EVA-3D/eva-main/readme.md

# EVA

EVA is a carriage platform for MGN rail based printers.

To learn more about EVA [go to the documentation](https://main.eva-3d.page/).

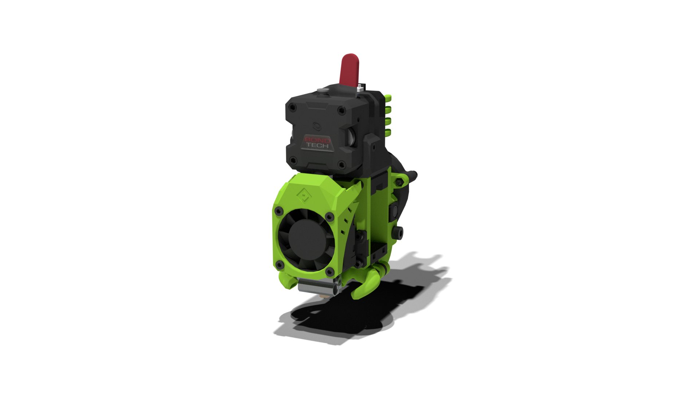
[picture p1: docs/assets/EVA.png]
