EVA-3D/eva-main/docs/ecosystem.md

---
hide:
  - navigation
---

# Ecosystem

There are many projects that came from the same family as EVA. Check them out for the full experience :)

## V-Core 3

A CoreXY 3D printer design from Rat Rig, where I am one of the main developers. Fully compatible with EVA.

{{ button("V-Core 3 page", "https://v-core.ratrig.com/", open_in_new_tab=True) }}

## V-Minion

A cantilevered, cartesian style printer with 180^3^ print volume, I'm on the development team of that one as well. Fully compatible with EVA.

{{ button("V-Minion page", "https://v-minion.ratrig.com/", open_in_new_tab=True) }}

## RatOS

A Klipper-based "firmware bundle" created and maintained by Mikkel Schmidt. 

RatOS allows you to quickly install the firmware for your printer, without the need to learn the very technical details of Klipper.
This bundle contains presets not only for the printers listed above (and more) but also for the specific EVA variants. This is also where you can find different wiring diagrams.

{{ button("RatOS page", "https://os.ratrig.com/", open_in_new_tab=True) }}
