EVA-3D/eva-main/include/heat_insert/probes/bl_touch_volcano.md

---
title: BL-touch Volcano
eva:
  category: probes
  component: bl_touch_volcano
  mounting: heat_insert
  name: heat_insert.probes.bl_touch_volcano
title: BL-touch Volcano

---

{% extends 'component.md' %}
