EVA-3D/eva-main/include/hex_nuts/probes/bl_touch_volcano.md

---
title: BL-touch Volcano
eva:
  category: probes
  component: bl_touch_volcano
  mounting: hex_nuts
  name: hex_nuts.probes.bl_touch_volcano
title: BL-touch Volcano

---

{% extends 'component.md' %}
