EVA-3D/eva-main/include/heat_insert/bottoms/default.md

---
title: Default
eva:
  category: bottoms
  component: default
  mounting: heat_insert
  name: heat_insert.bottoms.default
title: Default

---

{% extends 'component.md' %}
