EVA-3D/eva-main/include/heat_insert/bottoms/tri_horn.md

---
title: Tri Horn
eva:
  category: bottoms
  component: tri_horn
  mounting: heat_insert
  name: heat_insert.bottoms.tri_horn
title: Tri Horn

---

{% extends 'component.md' %}
