EVA-3D/eva-main/include/heat_insert/bottoms/volcano.md

---
title: Volcano
eva:
  category: bottoms
  component: volcano
  mounting: heat_insert
  name: heat_insert.bottoms.volcano
title: Volcano

---

{% extends 'component.md' %}
