EVA-3D/eva-main/include/heat_insert/hotend/revo_voron.md

---
title: REVO Voron
eva:
  category: hotend
  component: revo_voron
  mounting: heat_insert
  name: heat_insert.hotend.revo_voron
title: REVO Voron

---

{% extends 'component.md' %}
