EVA-3D/eva-main/include/heat_insert/shrouds/chonkier.md

---
title: Chonkier
eva:
  category: shrouds
  component: chonkier
  mounting: heat_insert
  name: heat_insert.shrouds.chonkier
title: Chonkier

---

{% extends 'component.md' %}
