EVA-3D/eva-main/include/heat_insert/shrouds/chonky.md

---
title: Chonky
eva:
  category: shrouds
  component: chonky
  mounting: heat_insert
  name: heat_insert.shrouds.chonky
title: Chonky

---

{% extends 'component.md' %}
