EVA-3D/eva-main/include/heat_insert/shrouds/small.md

---
title: Small
eva:
  category: shrouds
  component: small
  mounting: heat_insert
  name: heat_insert.shrouds.small
title: Small

---

{% extends 'component.md' %}
