EVA-3D/eva-main/include/heat_insert/shrouds/tank.md

---
title: Tank
eva:
  category: shrouds
  component: tank
  mounting: heat_insert
  name: heat_insert.shrouds.tank
title: Tank

---

{% extends 'component.md' %}
