EVA-3D/eva-main/include/hex_nuts/bottoms/default.md

---
title: Default
eva:
  category: bottoms
  component: default
  mounting: hex_nuts
  name: hex_nuts.bottoms.default
title: Default

---

{% extends 'component.md' %}
