EVA-3D/eva-main/include/hex_nuts/bottoms/tri_horn.md

---
title: Tri Horn
eva:
  category: bottoms
  component: tri_horn
  mounting: hex_nuts
  name: hex_nuts.bottoms.tri_horn
title: Tri Horn

---

{% extends 'component.md' %}
