EVA-3D/eva-main/include/hex_nuts/bottoms/volcano.md

---
title: Volcano
eva:
  category: bottoms
  component: volcano
  mounting: hex_nuts
  name: hex_nuts.bottoms.volcano
title: Volcano

---

{% extends 'component.md' %}
