EVA-3D/eva-main/include/hex_nuts/hotend/revo_voron.md

---
title: REVO Voron
eva:
  category: hotend
  component: revo_voron
  mounting: hex_nuts
  name: hex_nuts.hotend.revo_voron
title: REVO Voron

---

{% extends 'component.md' %}
