EVA-3D/eva-main/include/hex_nuts/shrouds/chonkier.md

---
title: Chonkier
eva:
  category: shrouds
  component: chonkier
  mounting: hex_nuts
  name: hex_nuts.shrouds.chonkier
title: Chonkier

---

{% extends 'component.md' %}
