EVA-3D/eva-main/include/hex_nuts/shrouds/chonky.md

---
title: Chonky
eva:
  category: shrouds
  component: chonky
  mounting: hex_nuts
  name: hex_nuts.shrouds.chonky
title: Chonky

---

{% extends 'component.md' %}
