EVA-3D/eva-main/include/hex_nuts/shrouds/small.md

---
title: Small
eva:
  category: shrouds
  component: small
  mounting: hex_nuts
  name: hex_nuts.shrouds.small
title: Small

---

{% extends 'component.md' %}
