EVA-3D/eva-main/include/hex_nuts/shrouds/tank.md

---
title: Tank
eva:
  category: shrouds
  component: tank
  mounting: hex_nuts
  name: hex_nuts.shrouds.tank
title: Tank

---

{% extends 'component.md' %}
