EVA-3D/eva-main/include/heat_insert/cooling_inlet/40mm.md

---
title: 40mm based fan
eva:
  category: cooling_inlet
  component: 40mm
  mounting: heat_insert
  name: heat_insert.cooling_inlet.40mm
title: 40mm based fan

---

{% extends 'component.md' %}
