EVA-3D/eva-main/include/heat_insert/cooling_inlet/dual_5015.md

---
title: Dual 5015
eva:
  category: cooling_inlet
  component: dual_5015
  mounting: heat_insert
  name: heat_insert.cooling_inlet.dual_5015
title: Dual 5015

---

{% extends 'component.md' %}
