EVA-3D/eva-main/include/heat_insert/core/cartesian.md

---
title: Cartesian
eva:
  category: core
  component: cartesian
  mounting: heat_insert
  name: heat_insert.core.cartesian
title: Cartesian

---

{% extends 'component.md' %}
