EVA-3D/eva-main/include/heat_insert/core/corexy.md

---
title: CoreXY
eva:
  category: core
  component: corexy
  mounting: heat_insert
  name: heat_insert.core.corexy
title: CoreXY

---

{% extends 'component.md' %}
