EVA-3D/eva-main/include/heat_insert/drive/bmg.md

---
title: BMG
eva:
  category: drive
  component: bmg
  mounting: heat_insert
  name: heat_insert.drive.bmg
title: BMG

---

{% extends 'component.md' %}
