EVA-3D/eva-main/include/heat_insert/drive/lgx.md

---
title: LGX
eva:
  category: drive
  component: lgx
  mounting: heat_insert
  name: heat_insert.drive.lgx
title: LGX

---

{% extends 'component.md' %}
