EVA-3D/eva-main/include/heat_insert/drive/lgx_lite.md

---
title: LGX Lite
eva:
  category: drive
  component: lgx_lite
  mounting: heat_insert
  name: heat_insert.drive.lgx_lite
title: LGX Lite

---

{% extends 'component.md' %}
