EVA-3D/eva-main/include/heat_insert/drive/orbiter_1_5.md

---
title: Orbiter 1.5
eva:
  category: drive
  component: orbiter_1_5
  mounting: heat_insert
  name: heat_insert.drive.orbiter_1_5
title: Orbiter 1.5

---

{% extends 'component.md' %}
