EVA-3D/eva-main/include/heat_insert/drive/orbiter_2_0.md

---
title: Orbiter 2.0
eva:
  category: drive
  component: orbiter_2_0
  mounting: heat_insert
  name: heat_insert.drive.orbiter_2_0
title: Orbiter 2.0

---

{% extends 'component.md' %}
