EVA-3D/eva-main/include/heat_insert/hotend/bmo.md

---
title: BMO
eva:
  category: hotend
  component: bmo
  mounting: heat_insert
  name: heat_insert.hotend.bmo
title: BMO

---

{% extends 'component.md' %}
