EVA-3D/eva-main/include/heat_insert/hotend/mosquito.md

---
title: Mosquito
eva:
  category: hotend
  component: mosquito
  mounting: heat_insert
  name: heat_insert.hotend.mosquito
title: Mosquito

---

{% extends 'component.md' %}
