EVA-3D/eva-main/include/heat_insert/hotend/nova.md

---
title: Nova
eva:
  category: hotend
  component: nova
  mounting: heat_insert
  name: heat_insert.hotend.nova
title: Nova

---

{% extends 'component.md' %}
