EVA-3D/eva-main/include/heat_insert/hotend/rapido.md

---
title: Rapido
eva:
  category: hotend
  component: rapido
  mounting: heat_insert
  name: heat_insert.hotend.rapido
title: Rapido

---

{% extends 'component.md' %}
