EVA-3D/eva-main/include/heat_insert/probes/8mm_probe.md

---
title: 8mm Probes
eva:
  category: probes
  component: 8mm_probe
  mounting: heat_insert
  name: heat_insert.probes.8mm_probe
title: 8mm Probes

---

{% extends 'component.md' %}
