EVA-3D/eva-main/include/heat_insert/probes/bl_touch.md

---
title: BL-touch
eva:
  category: probes
  component: bl_touch
  mounting: heat_insert
  name: heat_insert.probes.bl_touch
title: BL-touch

---

{% extends 'component.md' %}
