EVA-3D/eva-main/include/hex_nuts/cooling_inlet/40mm.md

---
title: 40mm based fan
eva:
  category: cooling_inlet
  component: 40mm
  mounting: hex_nuts
  name: hex_nuts.cooling_inlet.40mm
title: 40mm based fan

---

{% extends 'component.md' %}
