EVA-3D/eva-main/include/hex_nuts/cooling_inlet/dual_5015.md

---
title: Dual 5015
eva:
  category: cooling_inlet
  component: dual_5015
  mounting: hex_nuts
  name: hex_nuts.cooling_inlet.dual_5015
title: Dual 5015

---

{% extends 'component.md' %}
