EVA-3D/eva-main/include/hex_nuts/cooling_inlet/single_5015.md

---
title: Single 5015
eva:
  category: cooling_inlet
  component: single_5015
  mounting: hex_nuts
  name: hex_nuts.cooling_inlet.single_5015
title: Single 5015

---

{% extends 'component.md' %}
