EVA-3D/eva-main/include/hex_nuts/core/cartesian.md

---
title: Cartesian
eva:
  category: core
  component: cartesian
  mounting: hex_nuts
  name: hex_nuts.core.cartesian
title: Cartesian

---

{% extends 'component.md' %}
