EVA-3D/eva-main/include/hex_nuts/core/corexy.md

---
title: CoreXY
eva:
  category: core
  component: corexy
  mounting: hex_nuts
  name: hex_nuts.core.corexy
title: CoreXY

---

{% extends 'component.md' %}
