EVA-3D/eva-main/include/hex_nuts/drive/bmg.md

---
title: BMG
eva:
  category: drive
  component: bmg
  mounting: hex_nuts
  name: hex_nuts.drive.bmg
title: BMG

---

{% extends 'component.md' %}
