EVA-3D/eva-main/include/hex_nuts/drive/lgx.md

---
title: LGX
eva:
  category: drive
  component: lgx
  mounting: hex_nuts
  name: hex_nuts.drive.lgx
title: LGX

---

{% extends 'component.md' %}
