EVA-3D/eva-main/include/hex_nuts/drive/lgx_lite.md

---
title: LGX Lite
eva:
  category: drive
  component: lgx_lite
  mounting: hex_nuts
  name: hex_nuts.drive.lgx_lite
title: LGX Lite

---

{% extends 'component.md' %}
