EVA-3D/eva-main/include/hex_nuts/drive/orbiter_1_5.md

---
title: Orbiter 1.5
eva:
  category: drive
  component: orbiter_1_5
  mounting: hex_nuts
  name: hex_nuts.drive.orbiter_1_5
title: Orbiter 1.5

---

{% extends 'component.md' %}
