EVA-3D/eva-main/include/hex_nuts/drive/orbiter_2_0.md

---
title: Orbiter 2.0
eva:
  category: drive
  component: orbiter_2_0
  mounting: hex_nuts
  name: hex_nuts.drive.orbiter_2_0
title: Orbiter 2.0

---

{% extends 'component.md' %}
