EVA-3D/eva-main/include/hex_nuts/hotend/bmo.md

---
title: BMO
eva:
  category: hotend
  component: bmo
  mounting: hex_nuts
  name: hex_nuts.hotend.bmo
title: BMO

---

{% extends 'component.md' %}
