EVA-3D/eva-main/include/hex_nuts/hotend/mosquito.md

---
title: Mosquito
eva:
  category: hotend
  component: mosquito
  mounting: hex_nuts
  name: hex_nuts.hotend.mosquito
title: Mosquito

---

{% extends 'component.md' %}
