EVA-3D/eva-main/include/hex_nuts/hotend/nova.md

---
title: Nova
eva:
  category: hotend
  component: nova
  mounting: hex_nuts
  name: hex_nuts.hotend.nova
title: Nova

---

{% extends 'component.md' %}
