EVA-3D/eva-main/include/hex_nuts/hotend/rapido.md

---
title: Rapido
eva:
  category: hotend
  component: rapido
  mounting: hex_nuts
  name: hex_nuts.hotend.rapido
title: Rapido

---

{% extends 'component.md' %}
