EVA-3D/eva-main/include/hex_nuts/probes/8mm_probe.md

---
title: 8mm Probes
eva:
  category: probes
  component: 8mm_probe
  mounting: hex_nuts
  name: hex_nuts.probes.8mm_probe
title: 8mm Probes

---

{% extends 'component.md' %}
