EVA-3D/eva-main/include/hex_nuts/probes/bl_touch.md

---
title: BL-touch
eva:
  category: probes
  component: bl_touch
  mounting: hex_nuts
  name: hex_nuts.probes.bl_touch
title: BL-touch

---

{% extends 'component.md' %}
