EVA-3D/eva-main/docs/assets/360/0001.png

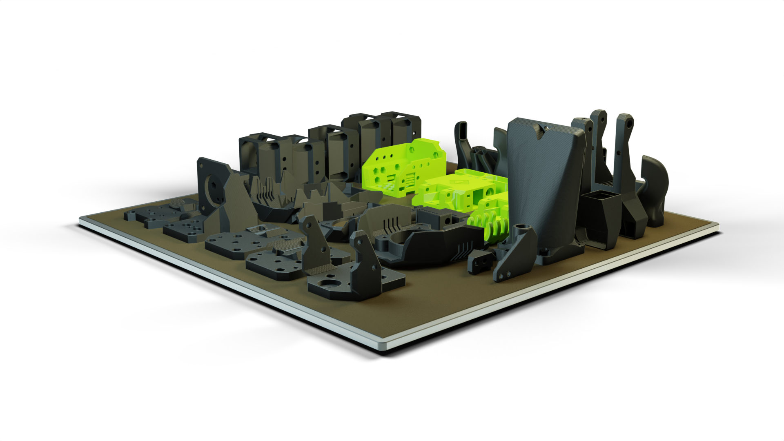
docs/assets/360/0001.png
