EVA-3D/eva-main/docs/assets/360/0002.png

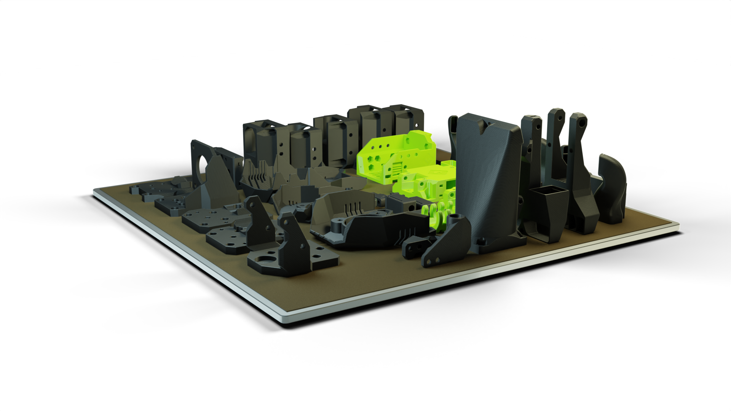
docs/assets/360/0002.png
