EVA-3D/eva-main/docs/assets/360/0004.png

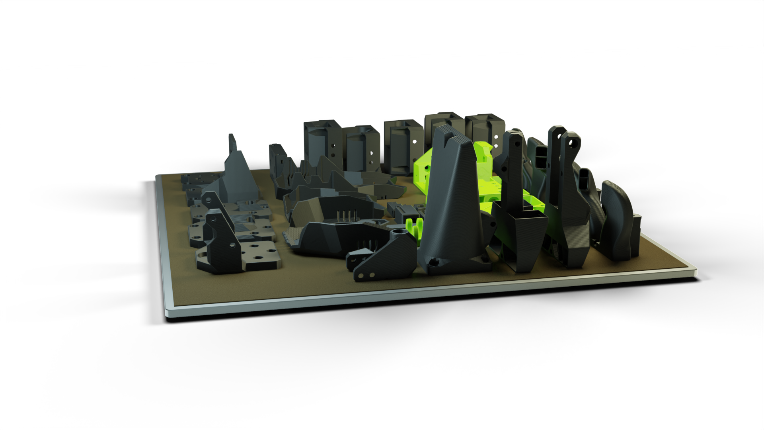
docs/assets/360/0004.png
