EVA-3D/eva-main/docs/assets/360/0005.png

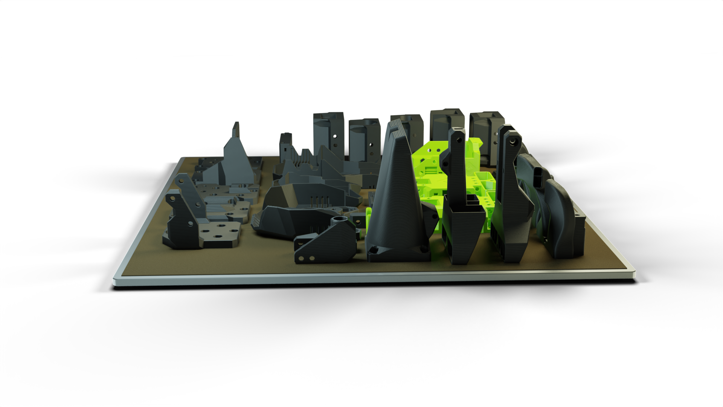
docs/assets/360/0005.png
