EVA-3D/eva-main/docs/assets/360/0006.png

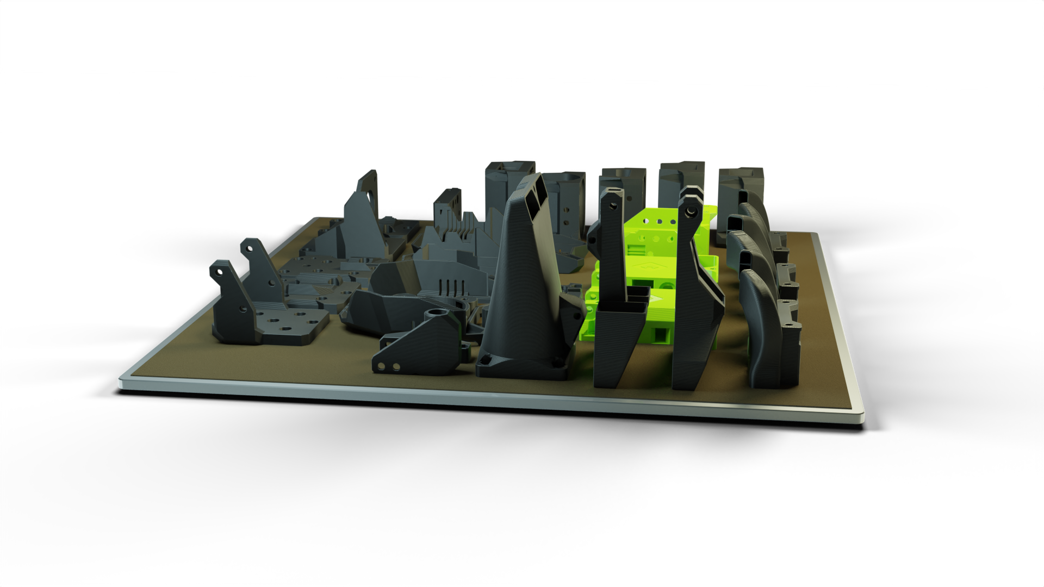
docs/assets/360/0006.png
