EVA-3D/eva-main/docs/assets/360/0007.png

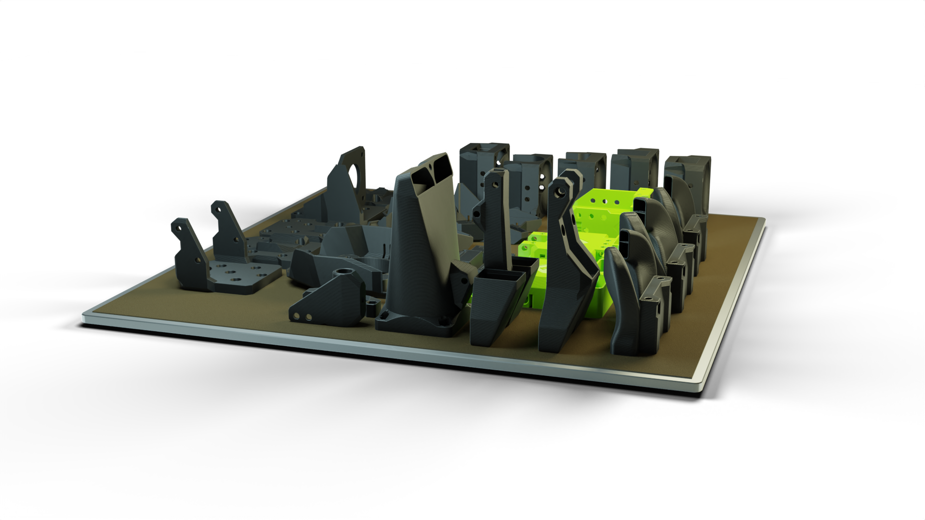
docs/assets/360/0007.png
