EVA-3D/eva-main/docs/assets/360/0008.png

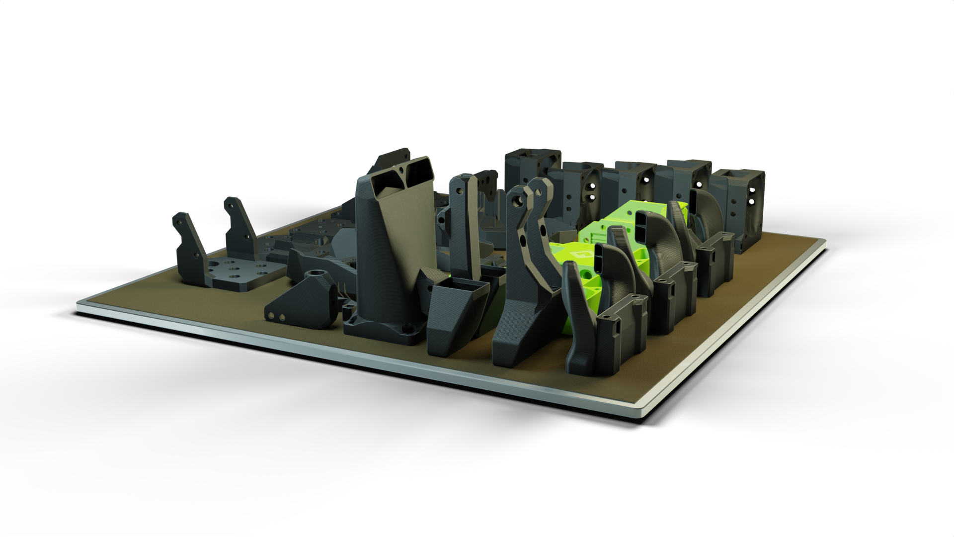
docs/assets/360/0008.png
