EVA-3D/eva-main/docs/assets/360/0009.png

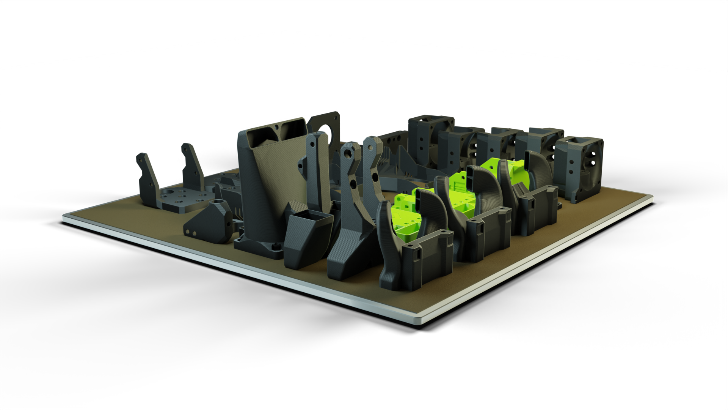
docs/assets/360/0009.png
