EVA-3D/eva-main/docs/assets/360/0010.png

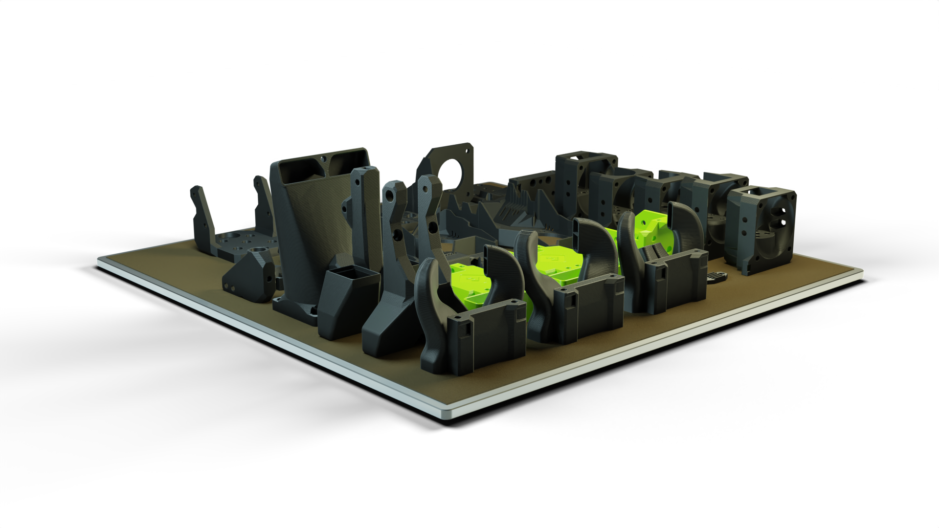
docs/assets/360/0010.png
