EVA-3D/eva-main/docs/assets/360/0011.png

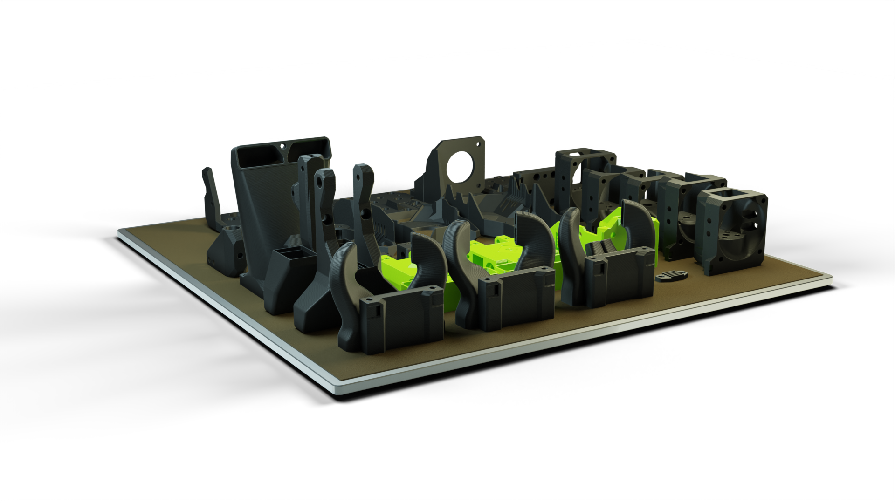
docs/assets/360/0011.png
