EVA-3D/eva-main/docs/assets/360/0012.png

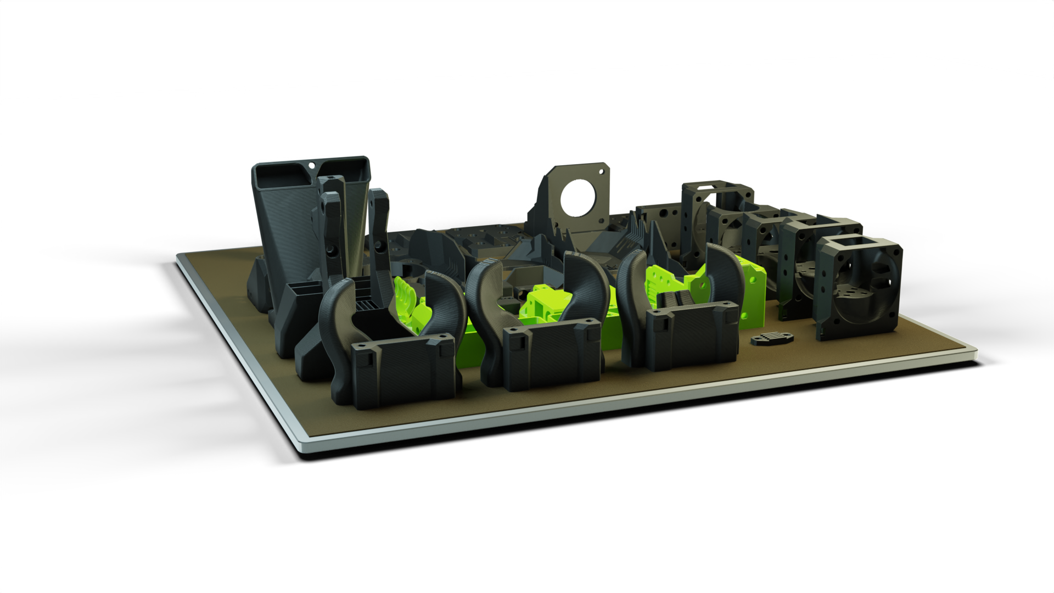
docs/assets/360/0012.png
