EVA-3D/eva-main/docs/assets/360/0013.png

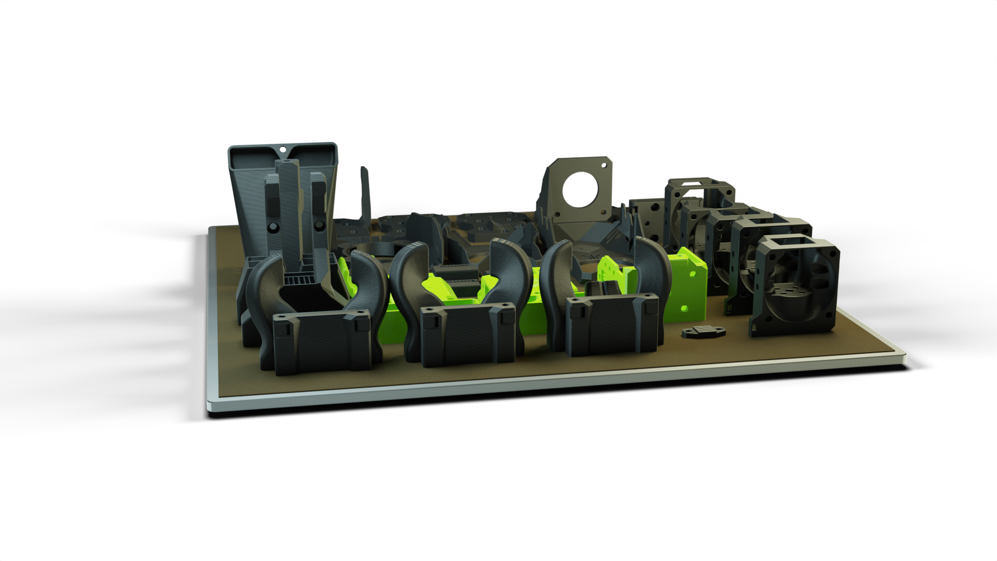
docs/assets/360/0013.png
