EVA-3D/eva-main/docs/assets/360/0014.png

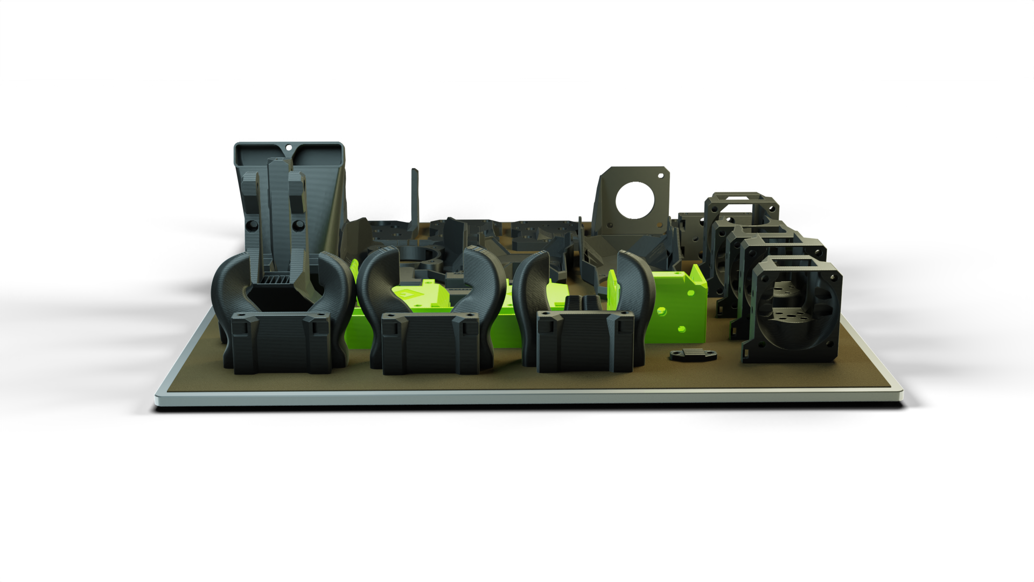
docs/assets/360/0014.png
