EVA-3D/eva-main/docs/assets/360/0015.png

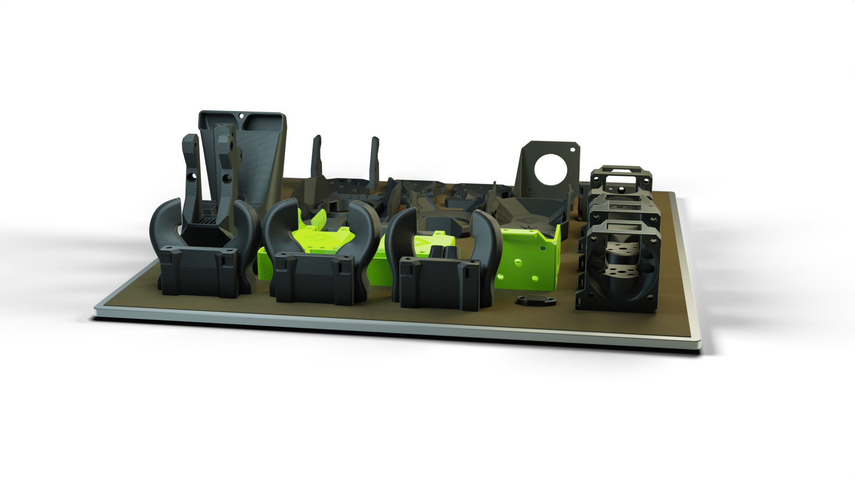
docs/assets/360/0015.png
