EVA-3D/eva-main/docs/assets/360/0016.png

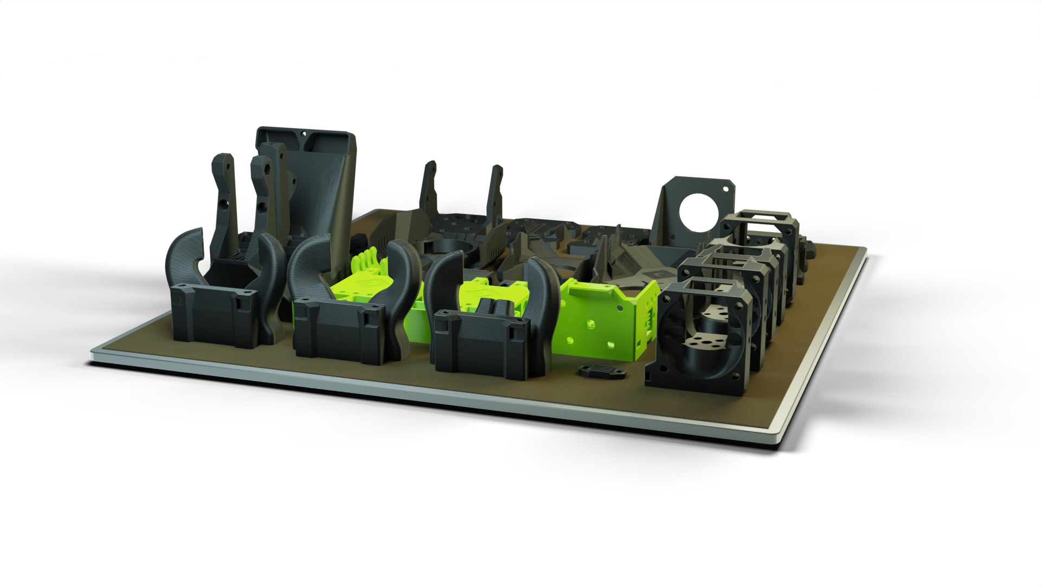
docs/assets/360/0016.png
