EVA-3D/eva-main/docs/assets/360/0017.png

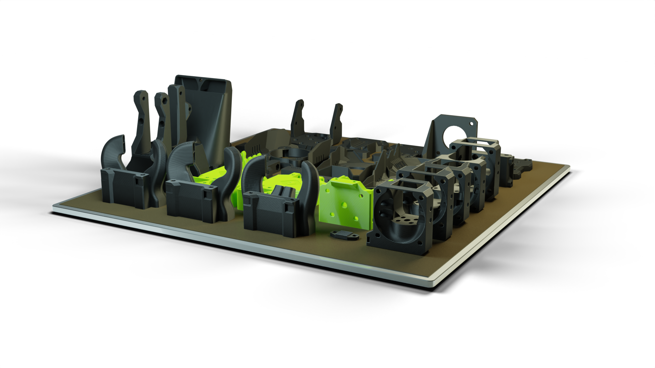
docs/assets/360/0017.png
