EVA-3D/eva-main/docs/assets/360/0019.png

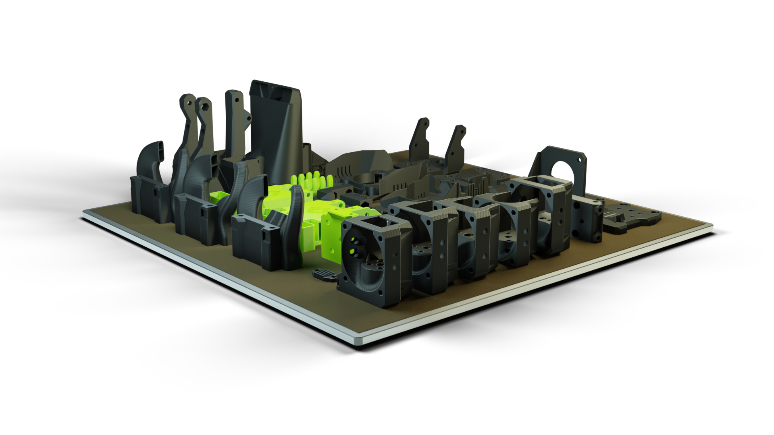
docs/assets/360/0019.png
