EVA-3D/eva-main/docs/assets/360/0020.png

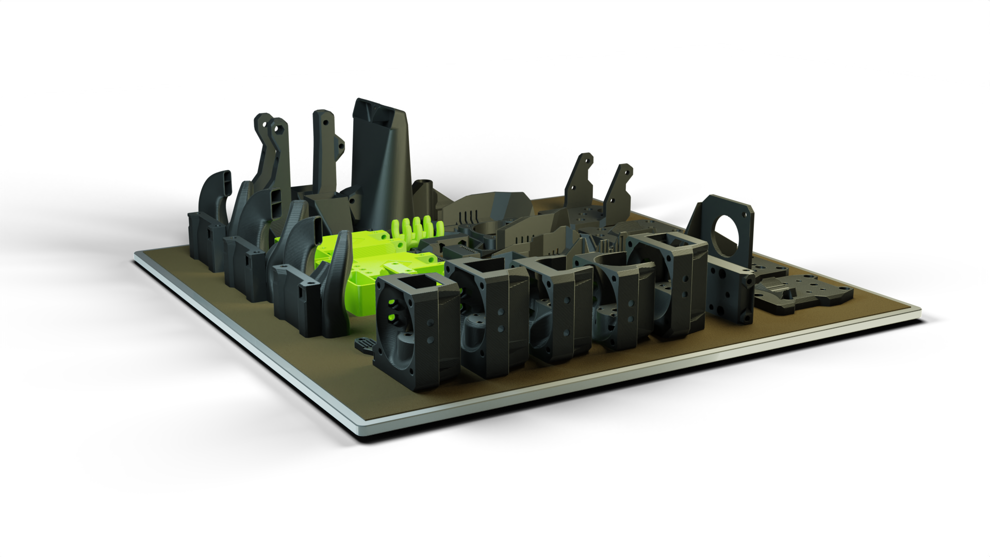
docs/assets/360/0020.png
