EVA-3D/eva-main/docs/assets/360/0021.png

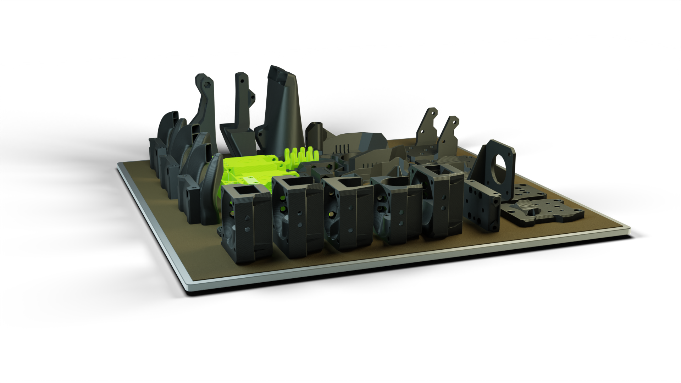
docs/assets/360/0021.png
