EVA-3D/eva-main/docs/assets/360/0022.png

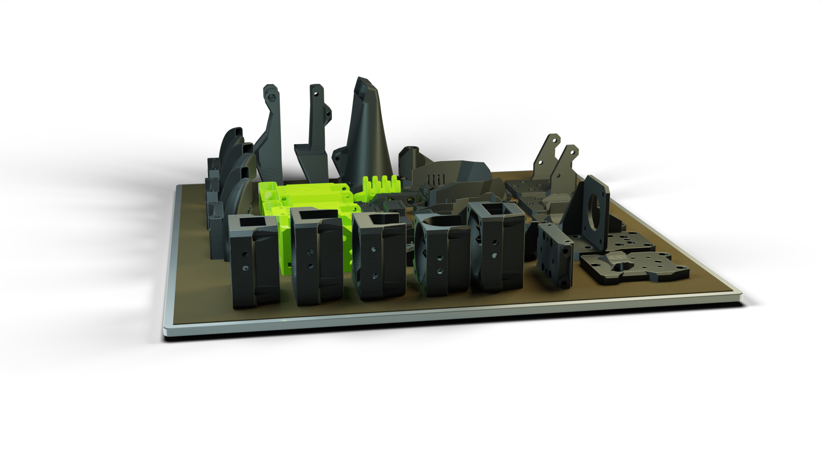
docs/assets/360/0022.png
