EVA-3D/eva-main/docs/assets/360/0023.png

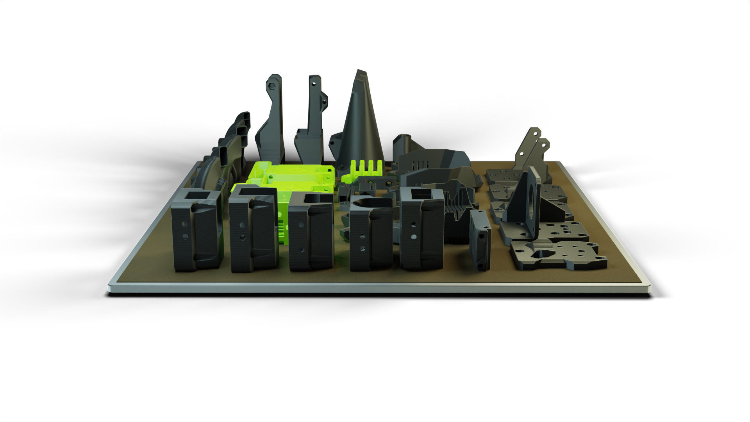
docs/assets/360/0023.png
