EVA-3D/eva-main/docs/assets/360/0024.png

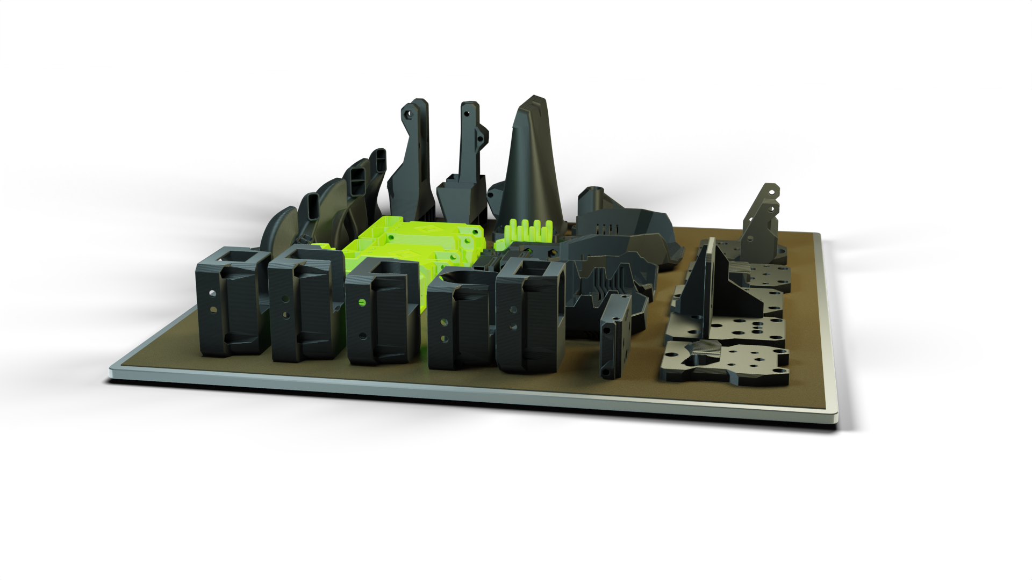
docs/assets/360/0024.png
