EVA-3D/eva-main/docs/assets/360/0025.png

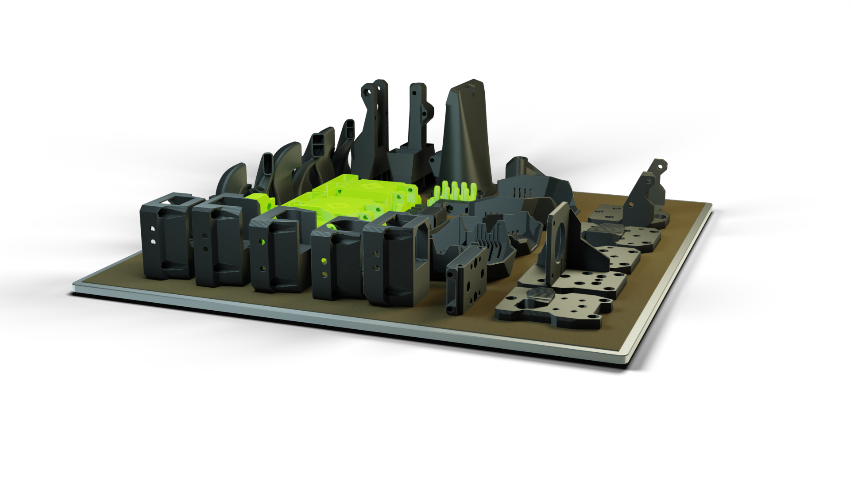
docs/assets/360/0025.png
