EVA-3D/eva-main/docs/assets/360/0027.png

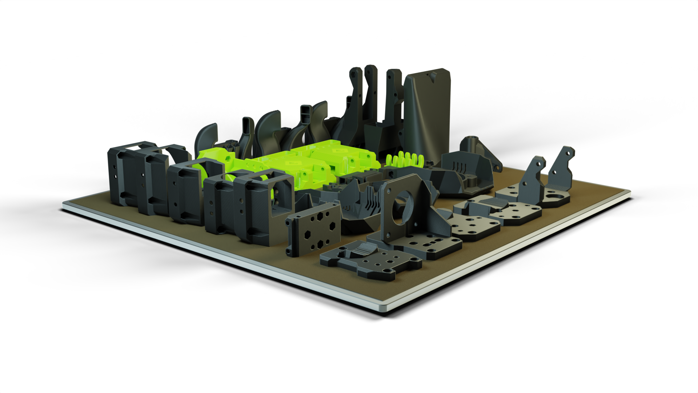
docs/assets/360/0027.png
