EVA-3D/eva-main/docs/assets/360/0029.png

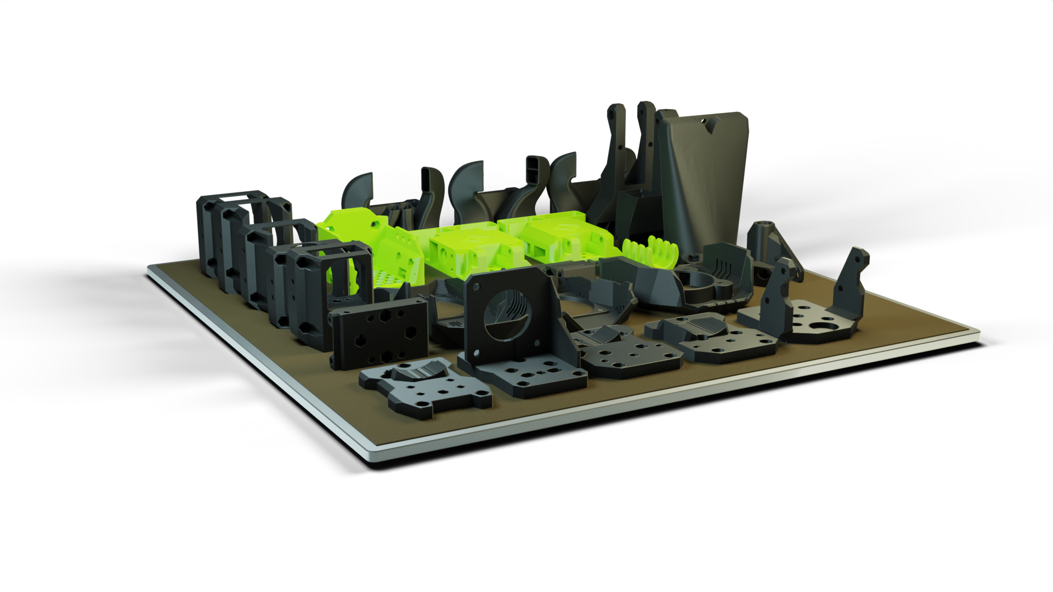
docs/assets/360/0029.png
