EVA-3D/eva-main/docs/assets/360/0030.png

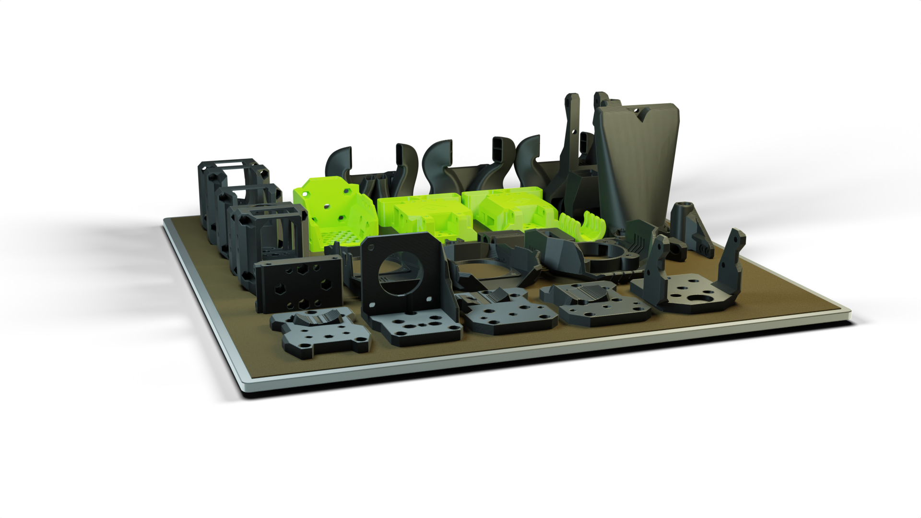
docs/assets/360/0030.png
