EVA-3D/eva-main/docs/assets/360/0031.png

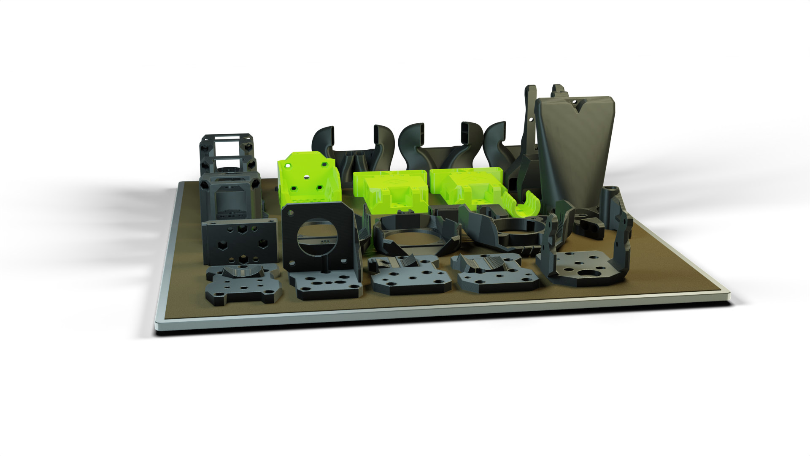
docs/assets/360/0031.png
