EVA-3D/eva-main/docs/assets/360/0032.png

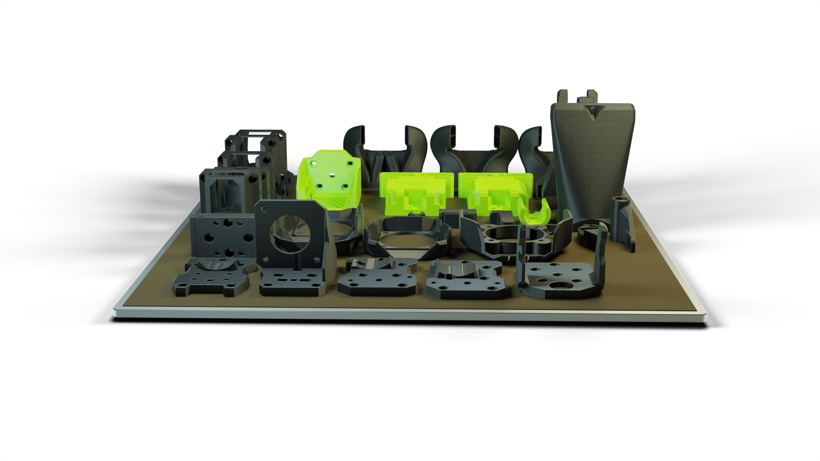
docs/assets/360/0032.png
