EVA-3D/eva-main/docs/assets/360/0033.png

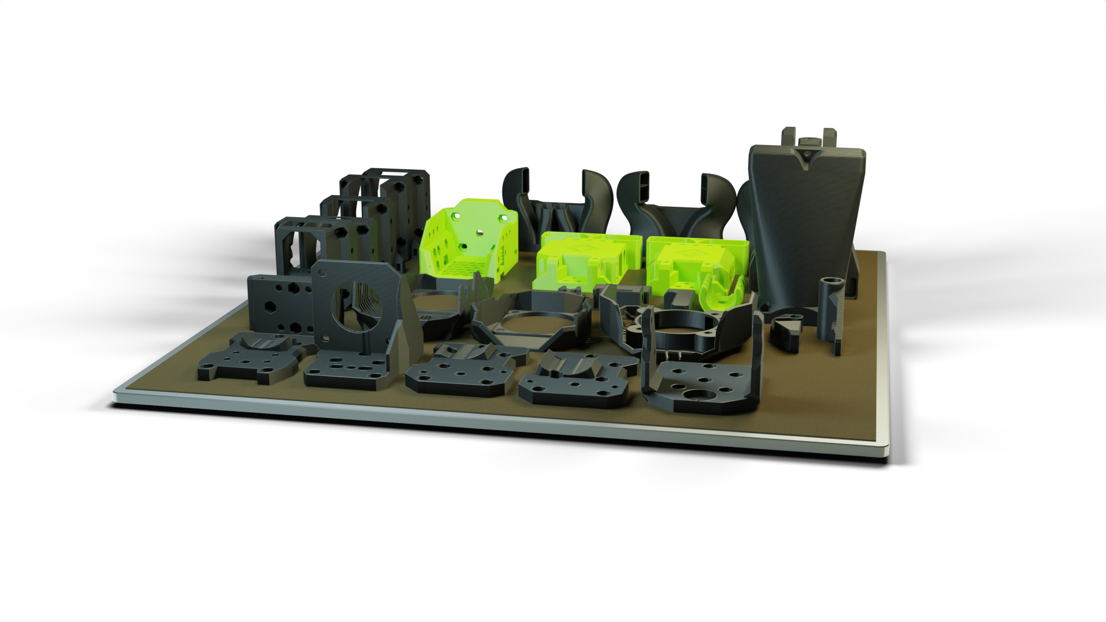
docs/assets/360/0033.png
