EVA-3D/eva-main/docs/assets/360/0034.png

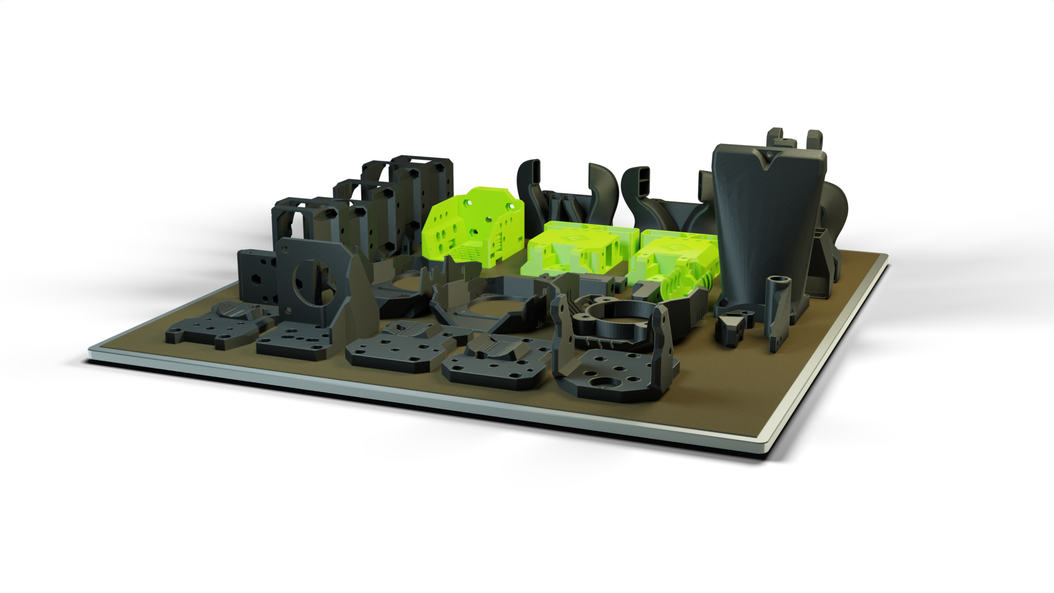
docs/assets/360/0034.png
