EVA-3D/eva-main/docs/assets/pfte_cross_section.png

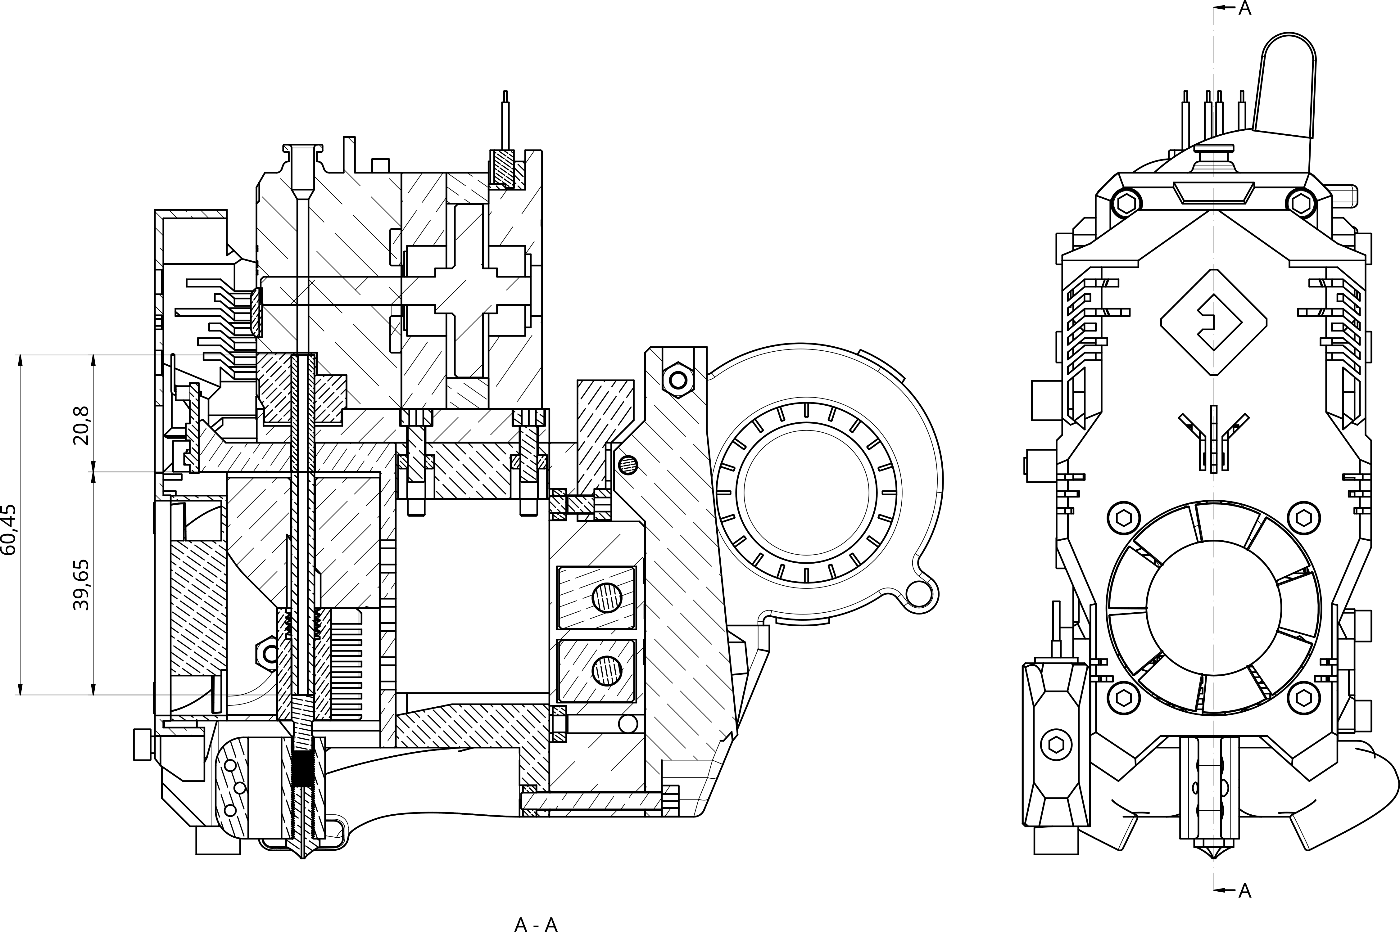
docs/assets/pfte_cross_section.png
