EVA-3D/eva-main/docs/assets/stupid_heat_insert_but_purdy.png

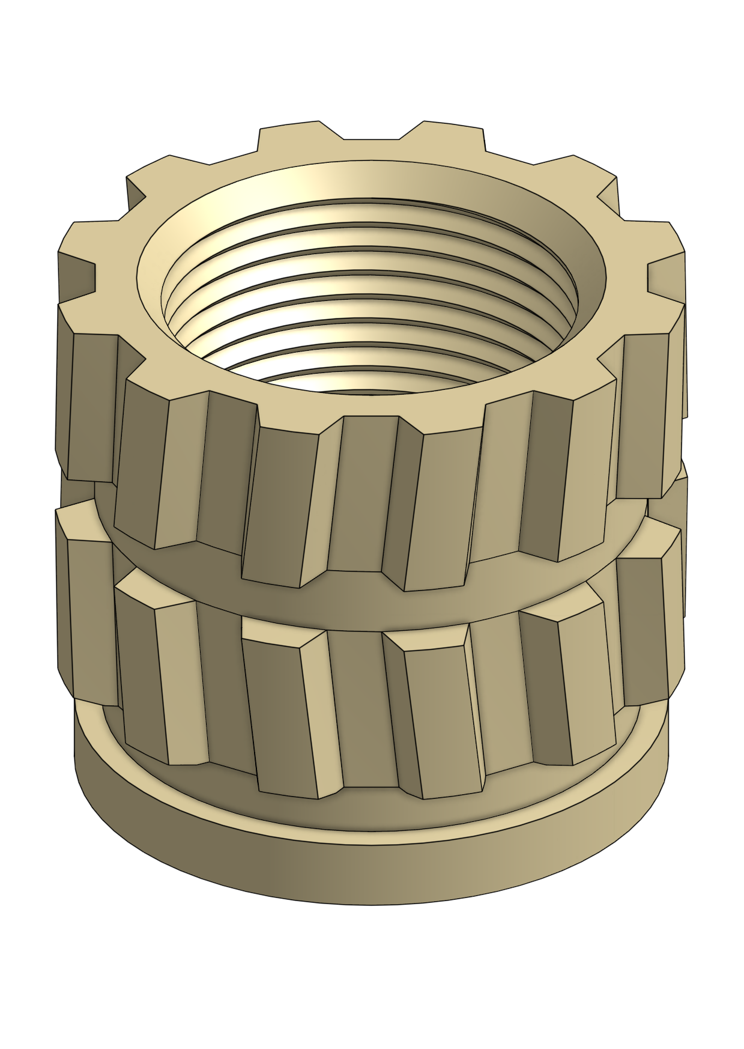
docs/assets/stupid_heat_insert_but_purdy.png
