EVA-3D/eva-main/docs/onshape_assets/heat_insert.bottoms.default.png

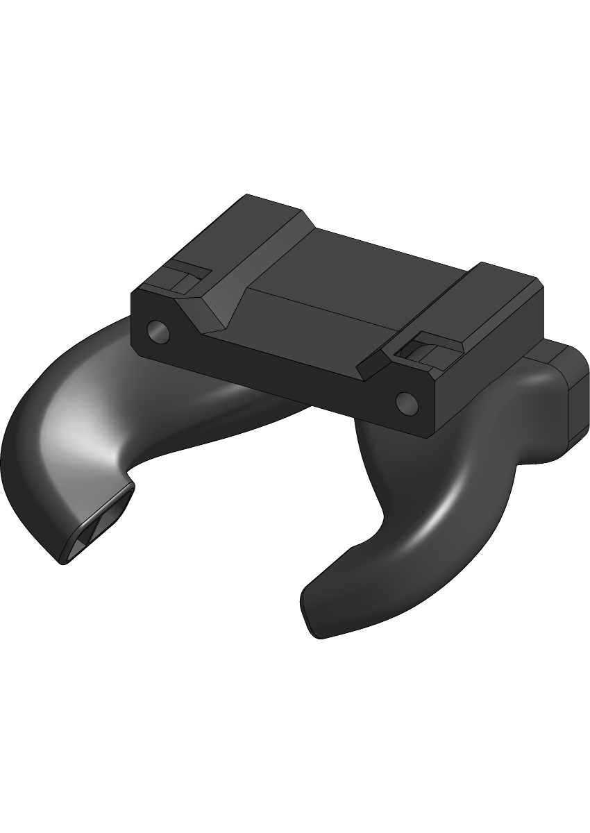
docs/onshape_assets/heat_insert.bottoms.default.png
