EVA-3D/eva-main/docs/onshape_assets/heat_insert.bottoms.volcano.png

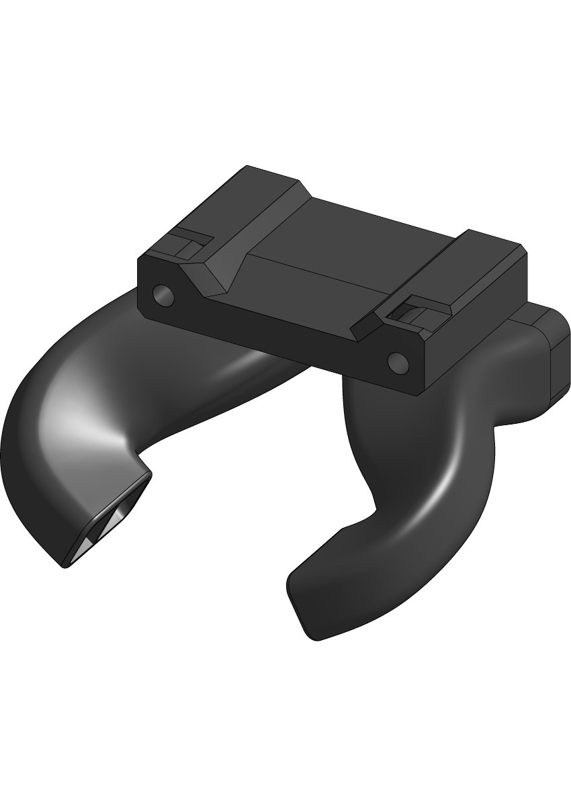
docs/onshape_assets/heat_insert.bottoms.volcano.png
