EVA-3D/eva-main/docs/onshape_assets/heat_insert.cooling_inlet.40mm.png

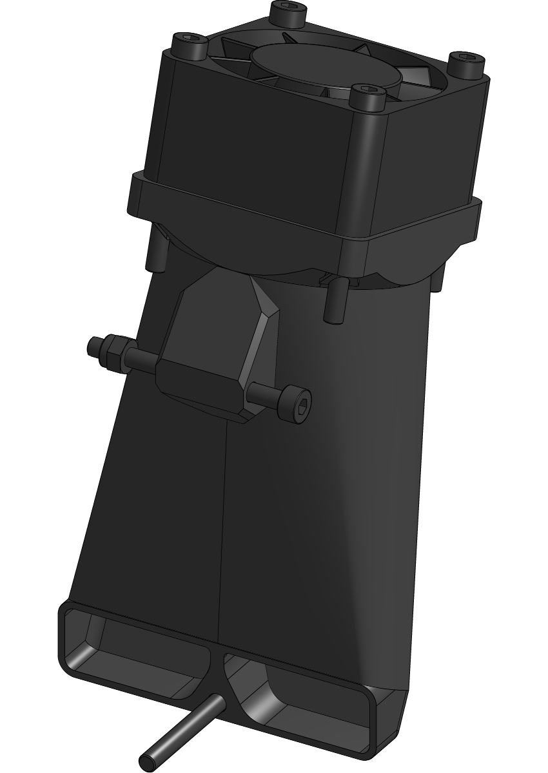
docs/onshape_assets/heat_insert.cooling_inlet.40mm.png
