EVA-3D/eva-main/docs/onshape_assets/heat_insert.cooling_inlet.single_5015.png

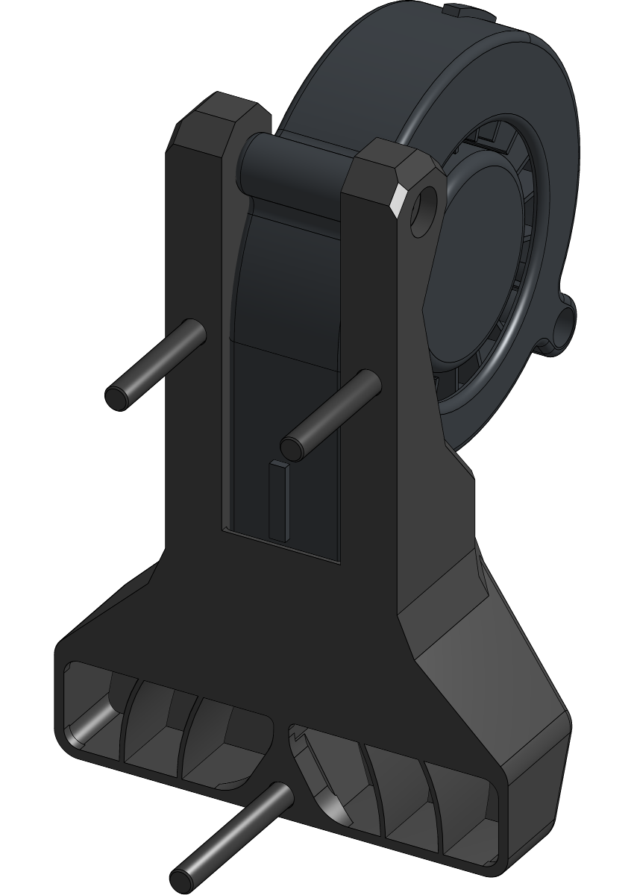
docs/onshape_assets/heat_insert.cooling_inlet.single_5015.png
