EVA-3D/eva-main/docs/onshape_assets/heat_insert.core.cartesian.png

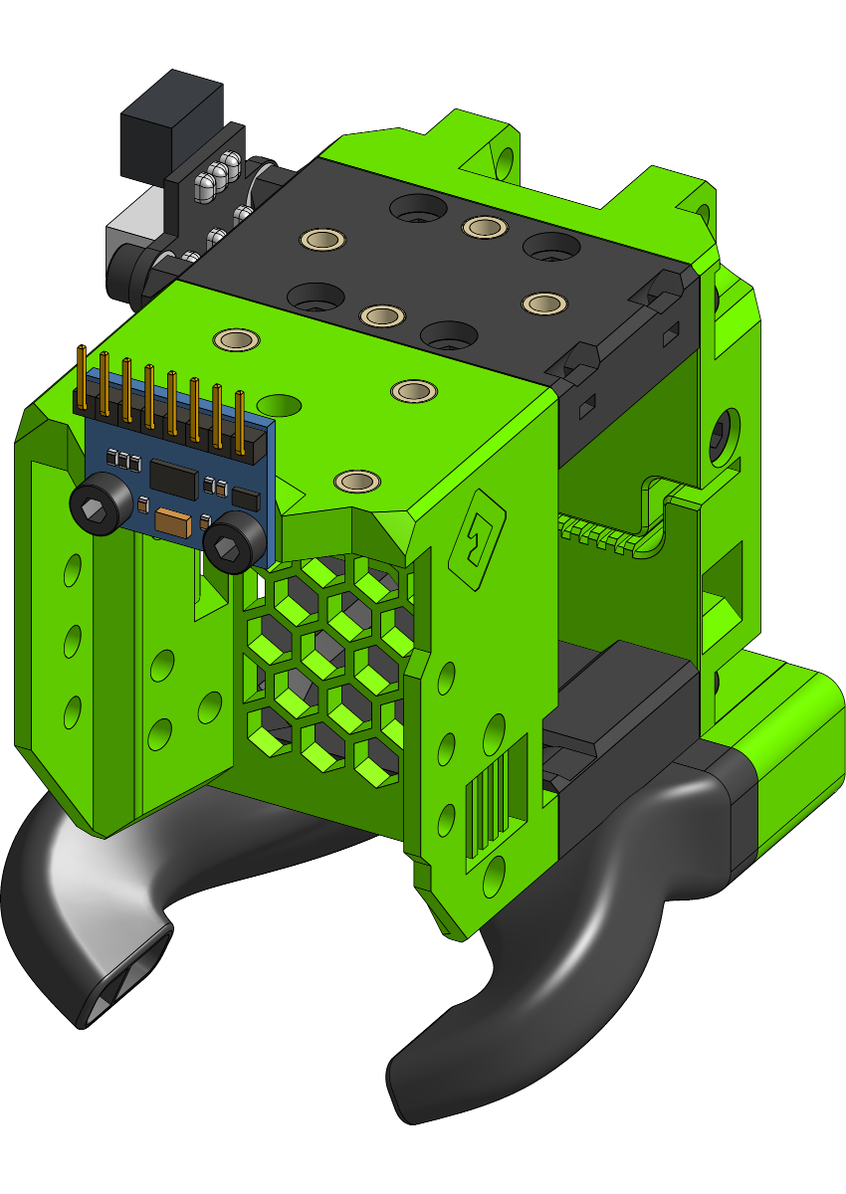
docs/onshape_assets/heat_insert.core.cartesian.png
