EVA-3D/eva-main/docs/onshape_assets/heat_insert.core.corexy.png

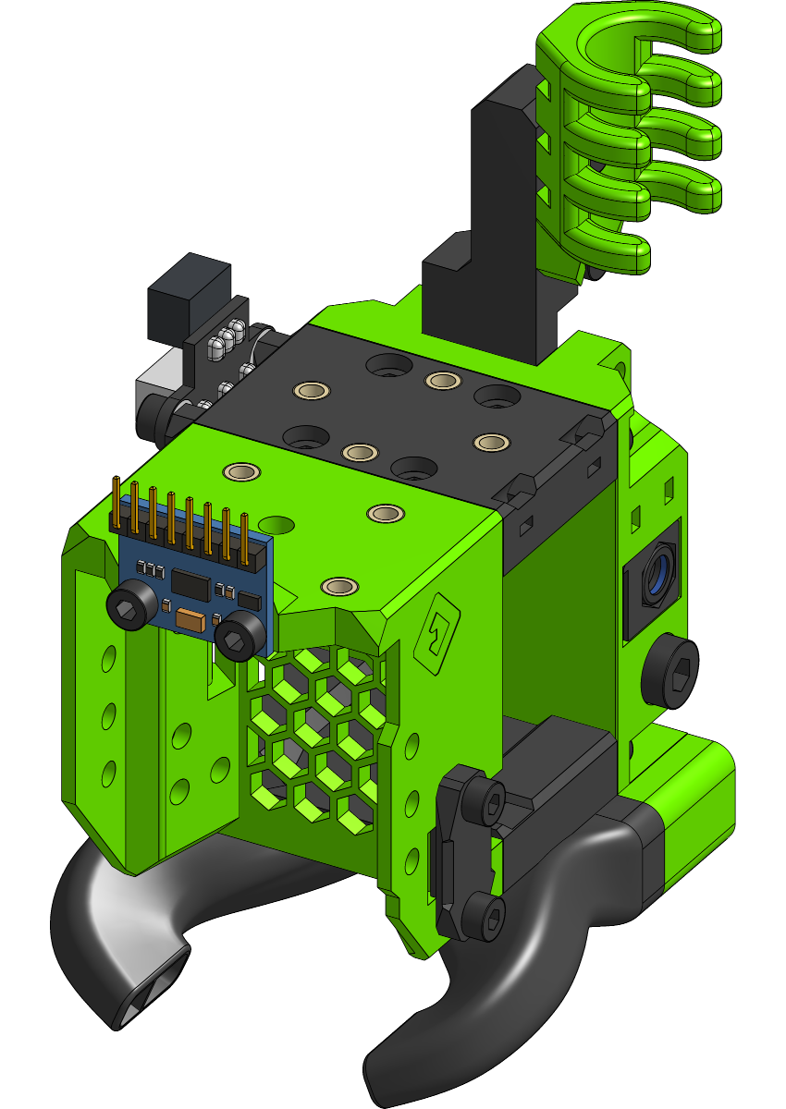
docs/onshape_assets/heat_insert.core.corexy.png
