EVA-3D/eva-main/docs/onshape_assets/heat_insert.drive.bmg.png

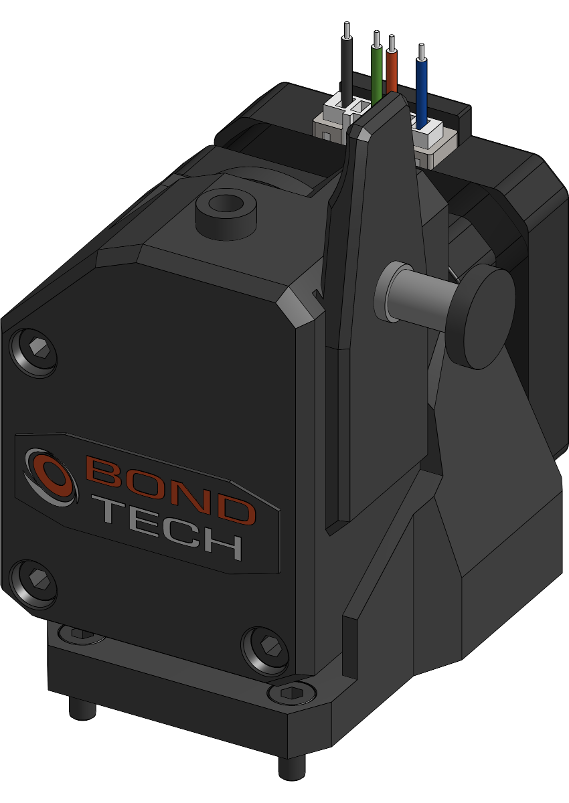
docs/onshape_assets/heat_insert.drive.bmg.png
