EVA-3D/eva-main/docs/onshape_assets/heat_insert.drive.lgx_lite.png

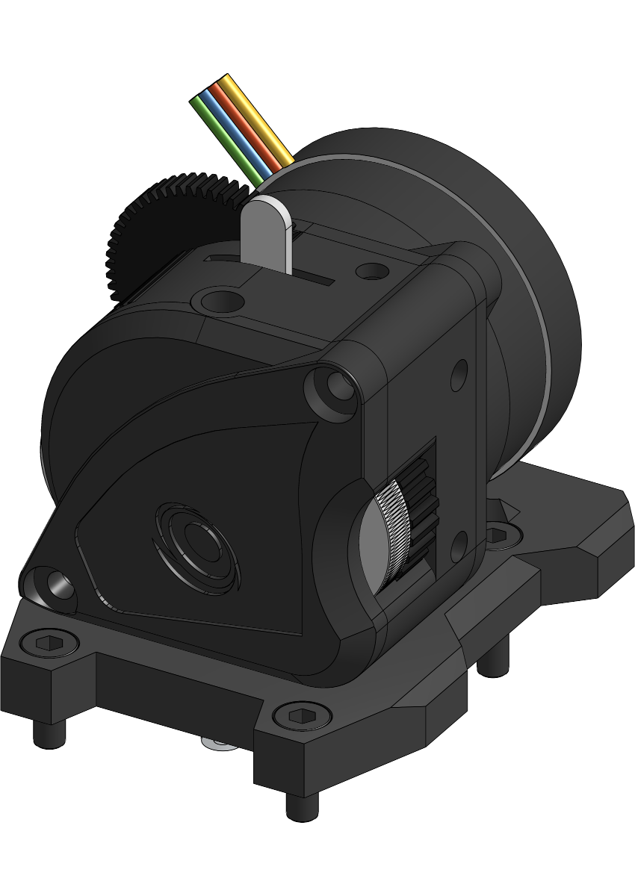
docs/onshape_assets/heat_insert.drive.lgx_lite.png
