EVA-3D/eva-main/docs/onshape_assets/heat_insert.drive.orbiter_1_5.png

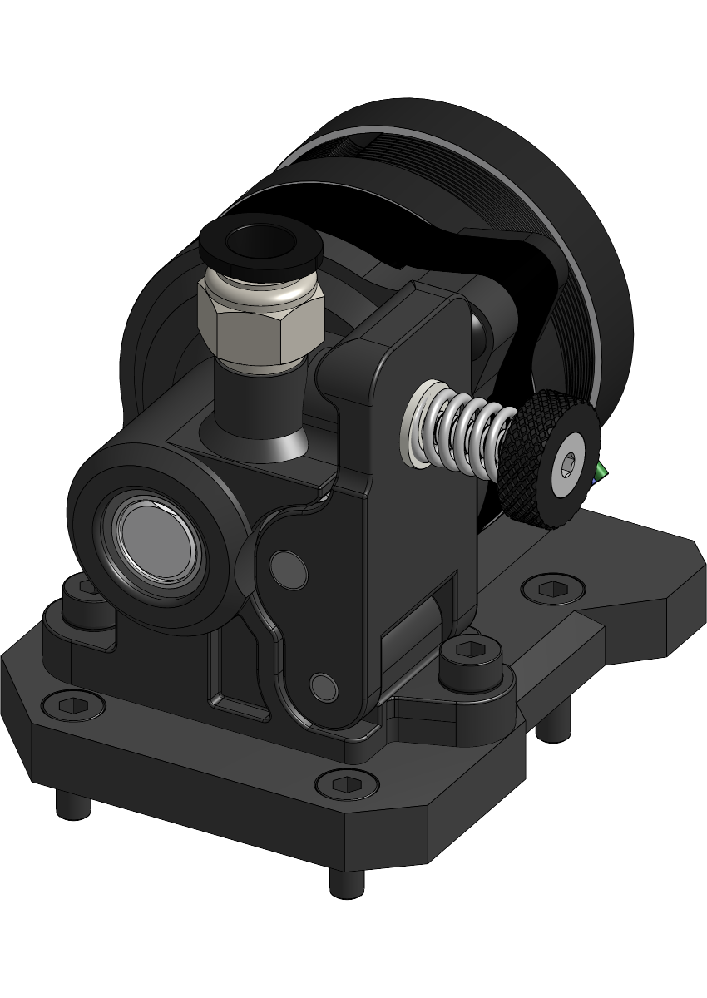
docs/onshape_assets/heat_insert.drive.orbiter_1_5.png
