EVA-3D/eva-main/docs/onshape_assets/heat_insert.drive.orbiter_2_0.png

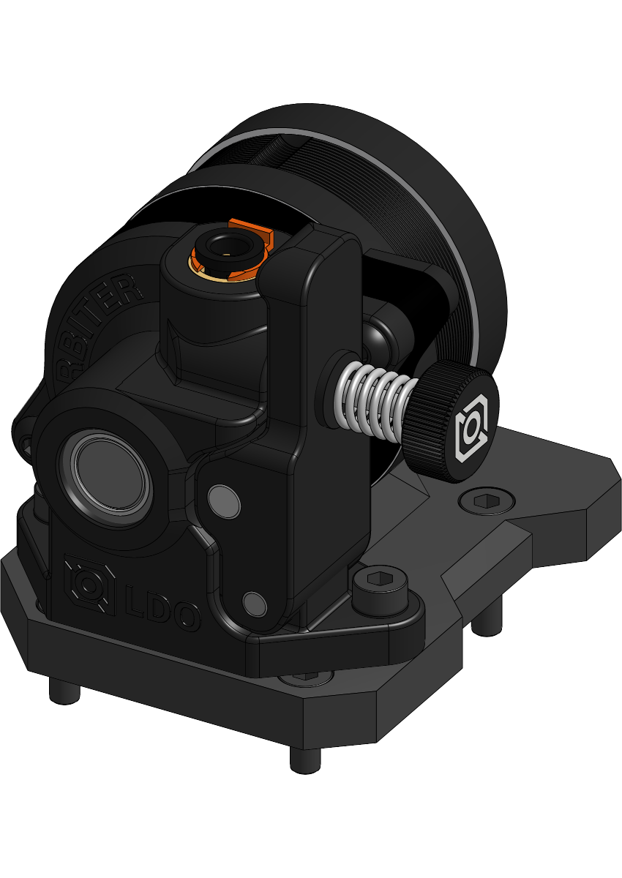
docs/onshape_assets/heat_insert.drive.orbiter_2_0.png
