EVA-3D/eva-main/docs/onshape_assets/heat_insert.hotend.bmo.png

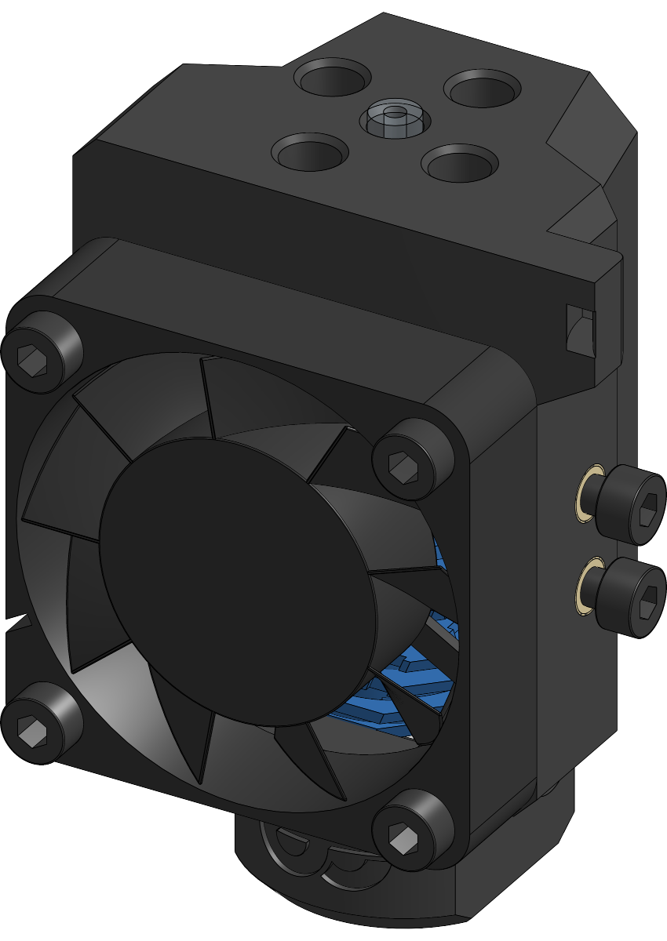
docs/onshape_assets/heat_insert.hotend.bmo.png
