EVA-3D/eva-main/docs/onshape_assets/heat_insert.hotend.rapido.png

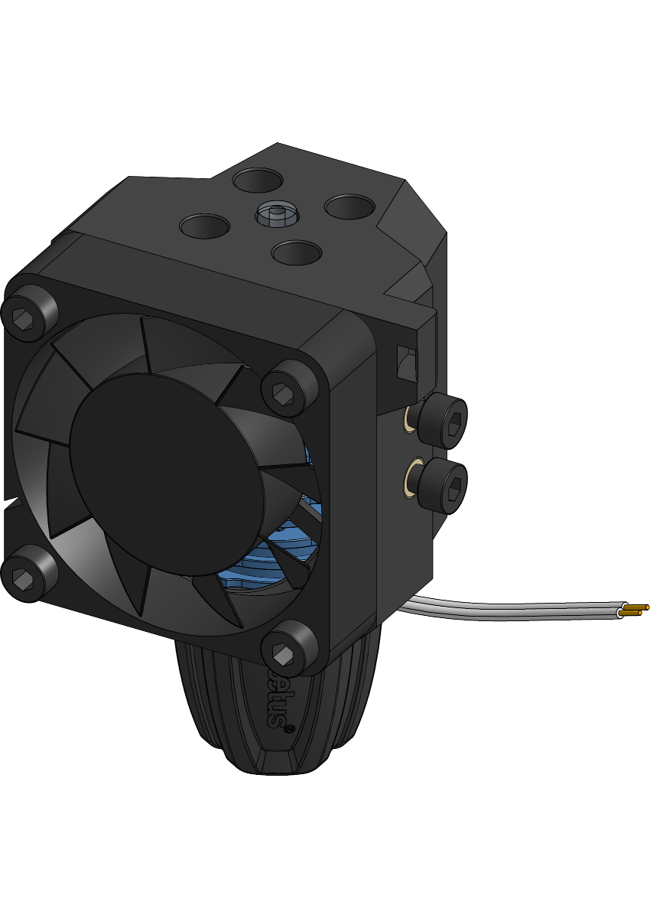
docs/onshape_assets/heat_insert.hotend.rapido.png
