EVA-3D/eva-main/docs/onshape_assets/heat_insert.hotend.revo_voron.png

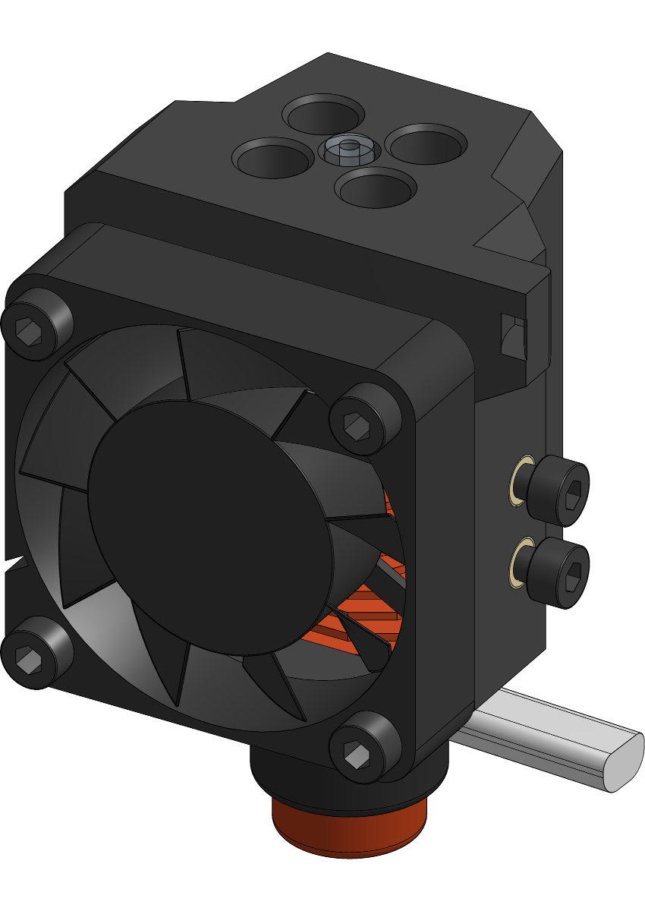
docs/onshape_assets/heat_insert.hotend.revo_voron.png
