EVA-3D/eva-main/docs/onshape_assets/heat_insert.probes.8mm_probe.png

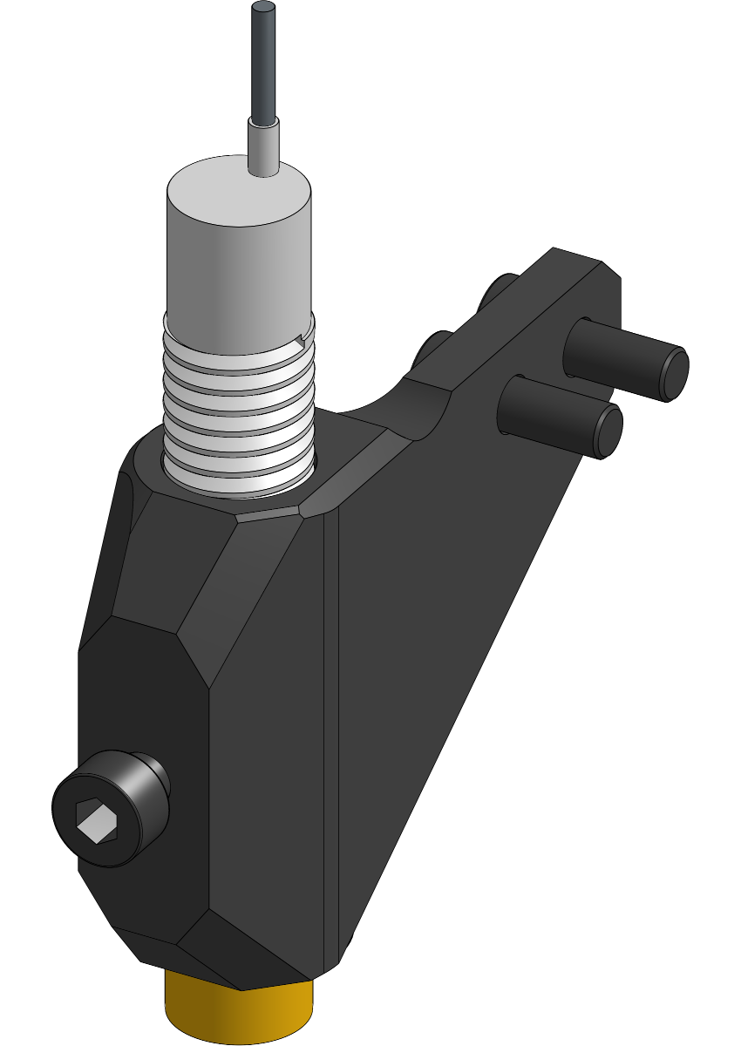
docs/onshape_assets/heat_insert.probes.8mm_probe.png
