EVA-3D/eva-main/docs/onshape_assets/heat_insert.probes.bl_touch_volcano.png

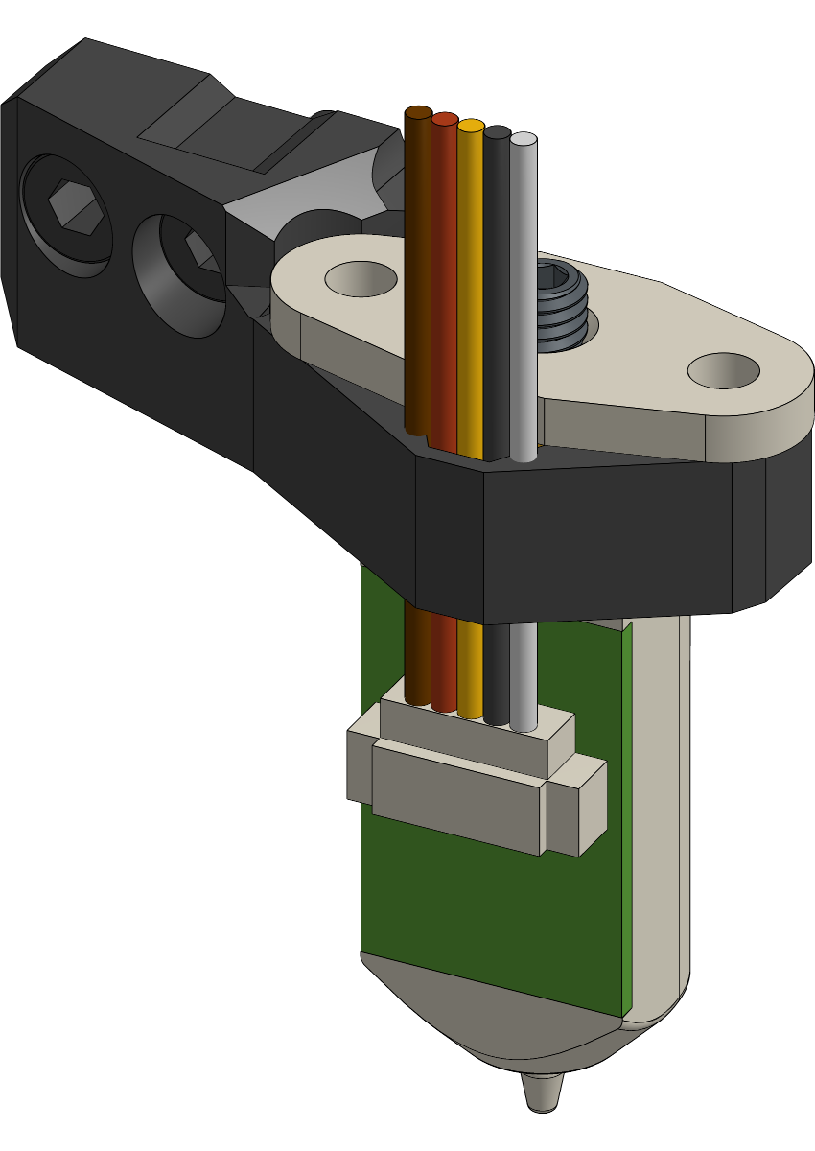
docs/onshape_assets/heat_insert.probes.bl_touch_volcano.png
