EVA-3D/eva-main/docs/onshape_assets/heat_insert.shrouds.chonkier.png

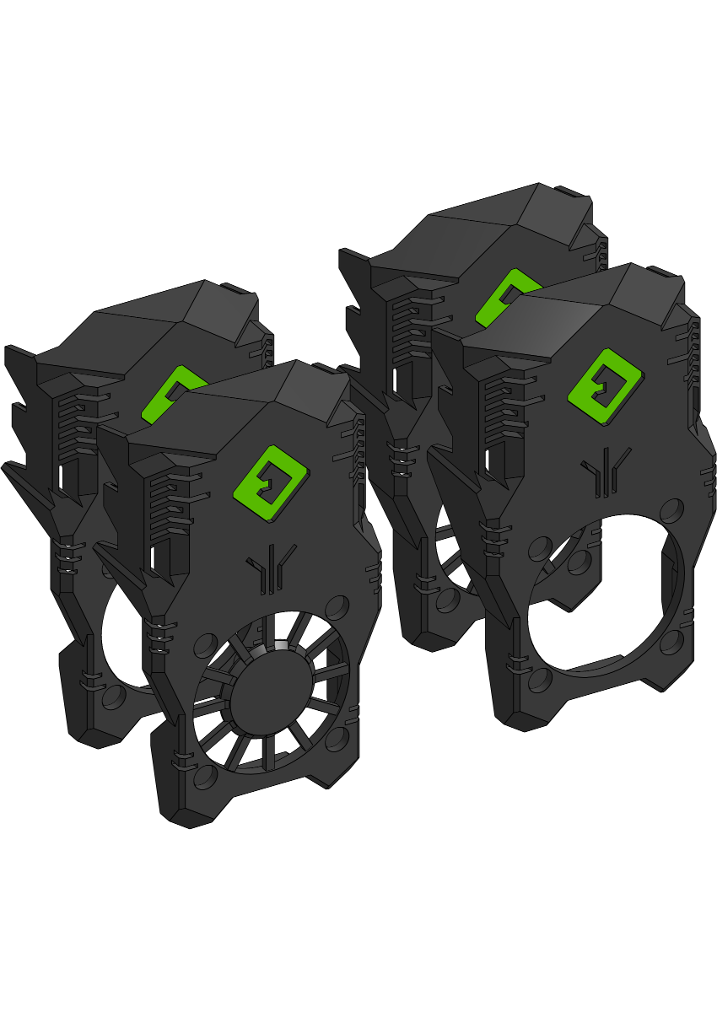
docs/onshape_assets/heat_insert.shrouds.chonkier.png
