EVA-3D/eva-main/docs/onshape_assets/heat_insert.shrouds.chonky.png

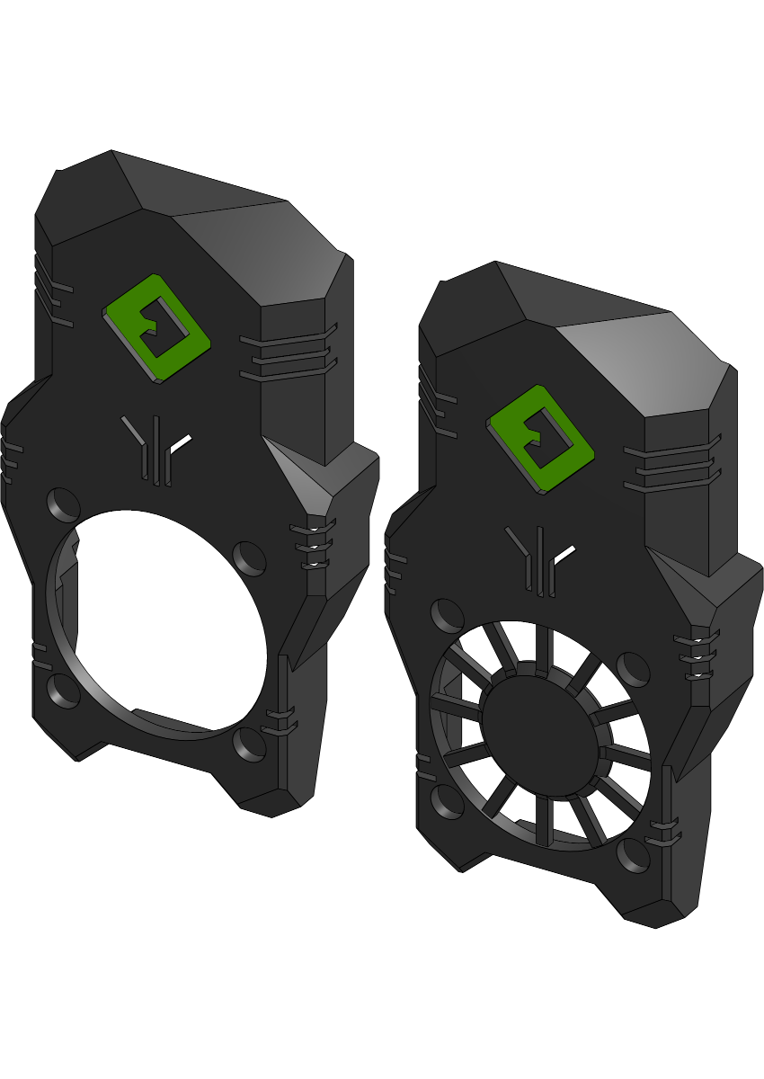
docs/onshape_assets/heat_insert.shrouds.chonky.png
