EVA-3D/eva-main/docs/onshape_assets/heat_insert.shrouds.small.png

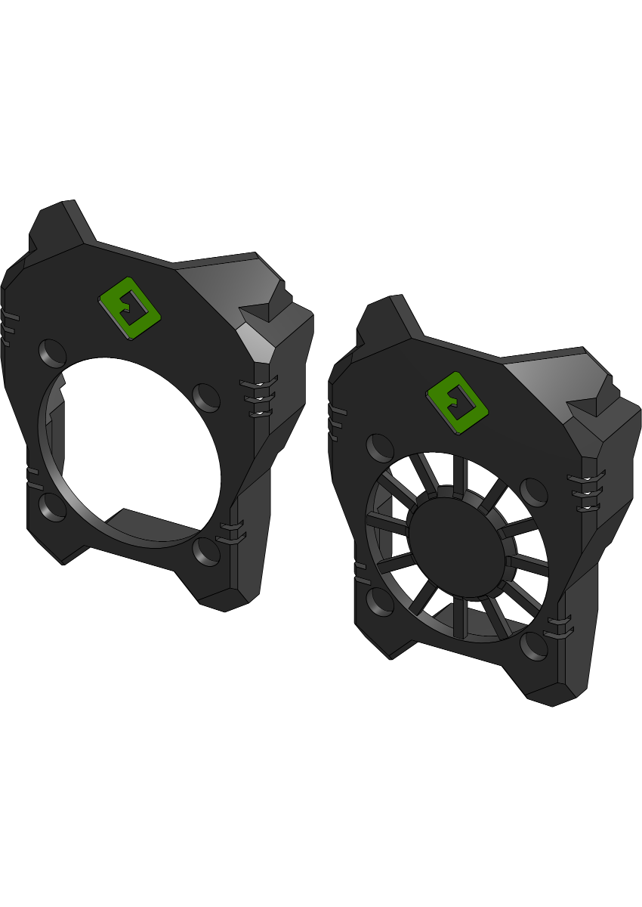
docs/onshape_assets/heat_insert.shrouds.small.png
