EVA-3D/eva-main/docs/onshape_assets/heat_insert.shrouds.tank.png

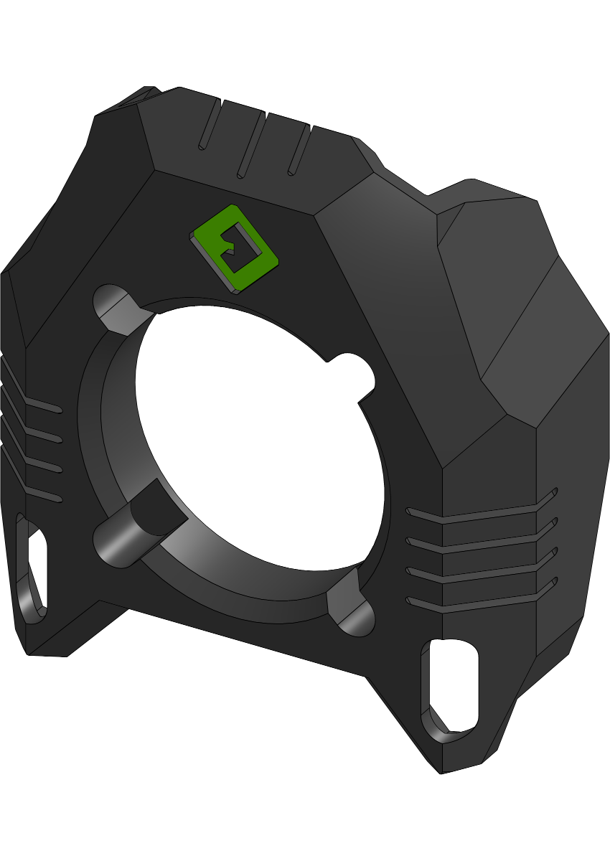
docs/onshape_assets/heat_insert.shrouds.tank.png
