EVA-3D/eva-main/docs/onshape_assets/hex_nuts.core.cartesian.png

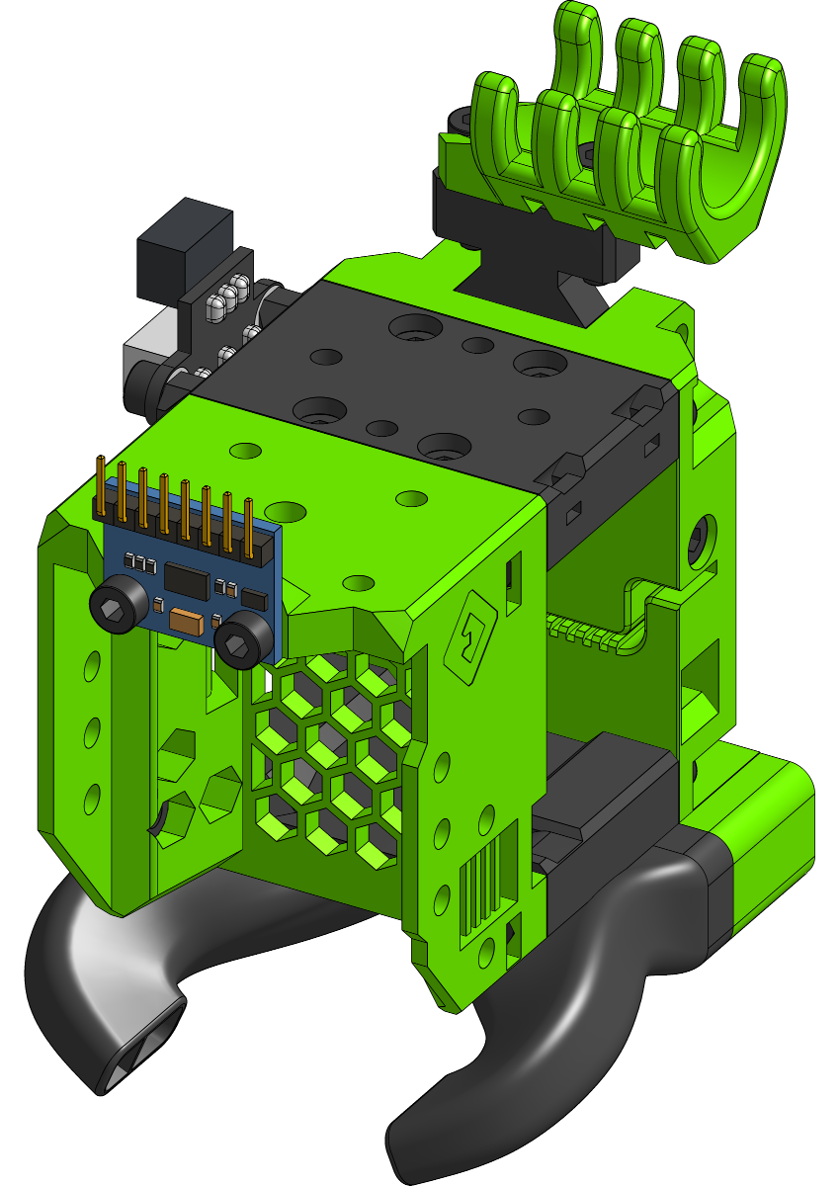
docs/onshape_assets/hex_nuts.core.cartesian.png
