EVA-3D/eva-main/docs/stls/heat_insert/cable_management/guide/cable_guide_mount_fi.stl

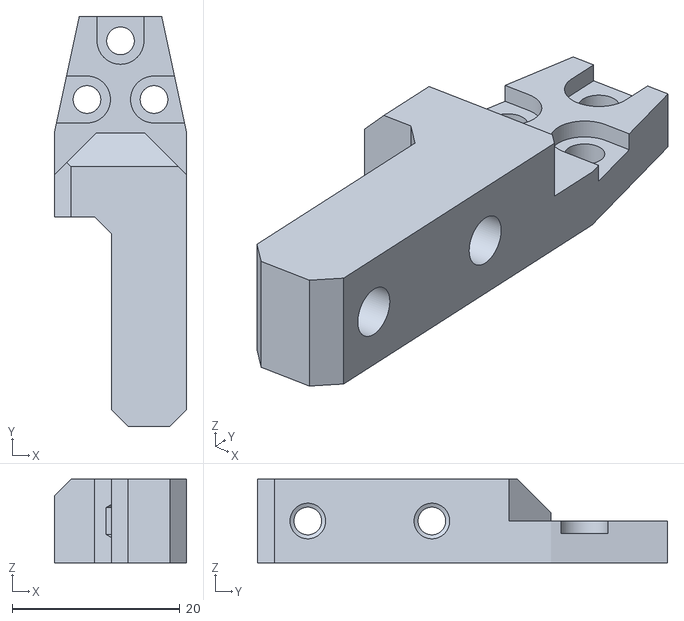
[picture p65: CAD file, 2022-06-12]
docs/stls/heat_insert/cable_management/guide/cable_guide_mount_fi.stl
15.8 x 48.9 x 10.0
