EVA-3D/eva-main/docs/stls/heat_insert/cooling_inlet/40mm/40mm_fan_inlet_fi.stl

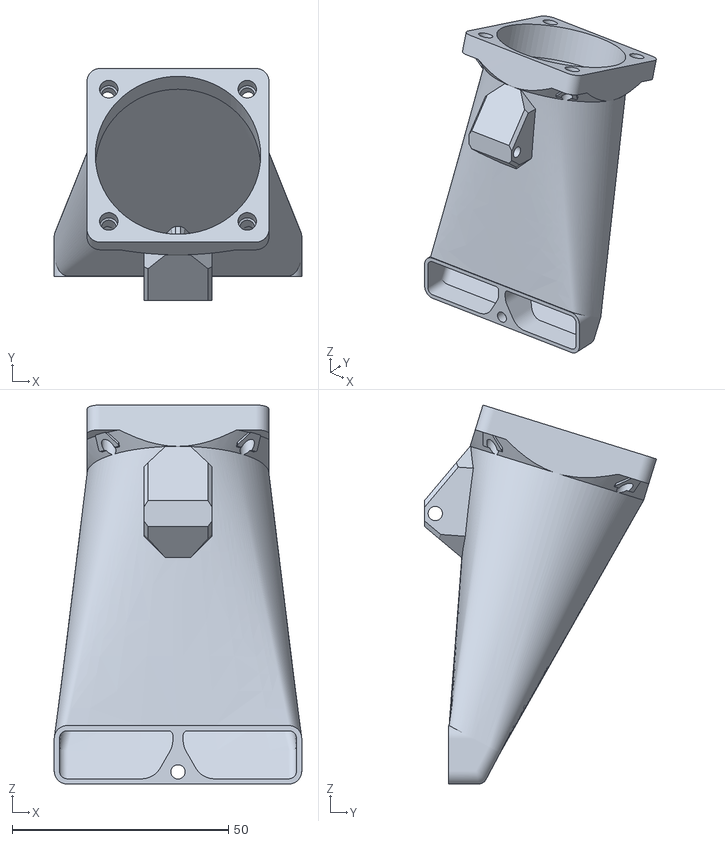
[picture p66: CAD file, 2022-05-08]
docs/stls/heat_insert/cooling_inlet/40mm/40mm_fan_inlet_fi.stl
57.2 x 53.6 x 87.6
