EVA-3D/eva-main/docs/stls/heat_insert/cooling_inlet/dual_5015/dual_5015_inlet_fi.stl

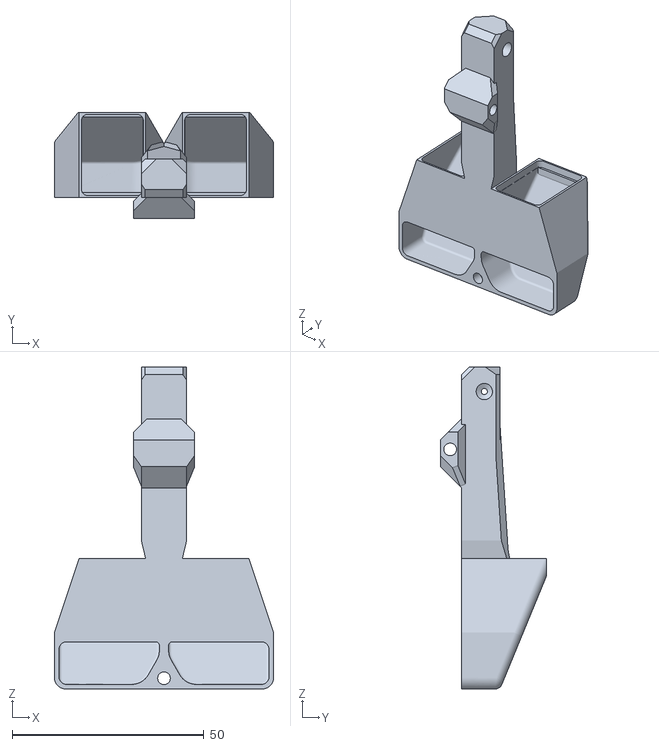
[picture p67: CAD file, 2022-06-12]
docs/stls/heat_insert/cooling_inlet/dual_5015/dual_5015_inlet_fi.stl
57.2 x 27.6 x 84.0
