EVA-3D/eva-main/docs/stls/heat_insert/cooling_inlet/single_5015/5015_inlet_fi.stl

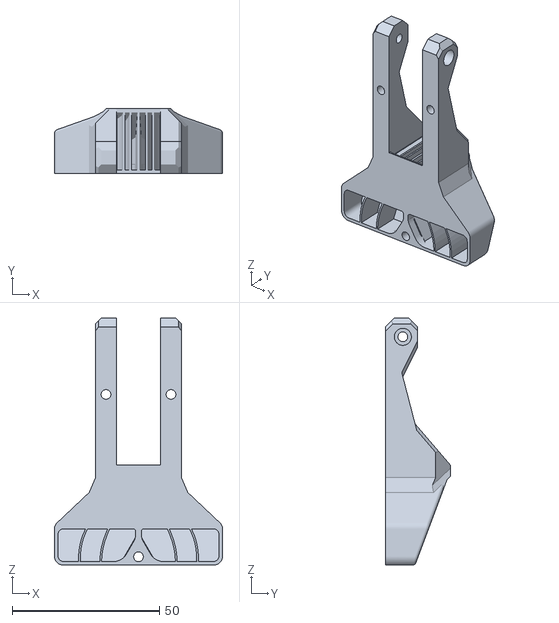
[picture p68: CAD file, 2022-06-12]
docs/stls/heat_insert/cooling_inlet/single_5015/5015_inlet_fi.stl
57.2 x 22.0 x 84.0
