EVA-3D/eva-main/docs/stls/heat_insert/core/cartesian/top_endstop_mgn12c_fi.stl

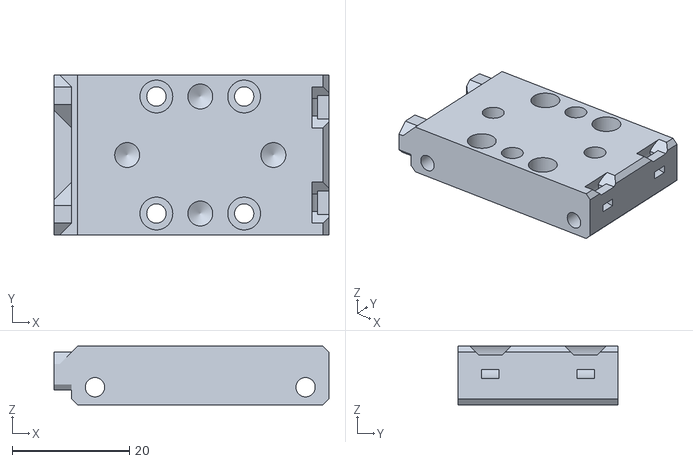
[picture p69: CAD file, 2022-06-12]
docs/stls/heat_insert/core/cartesian/top_endstop_mgn12c_fi.stl
47.0 x 27.3 x 10.0
