EVA-3D/eva-main/docs/stls/heat_insert/drive/bmg/drive_bmg.stl

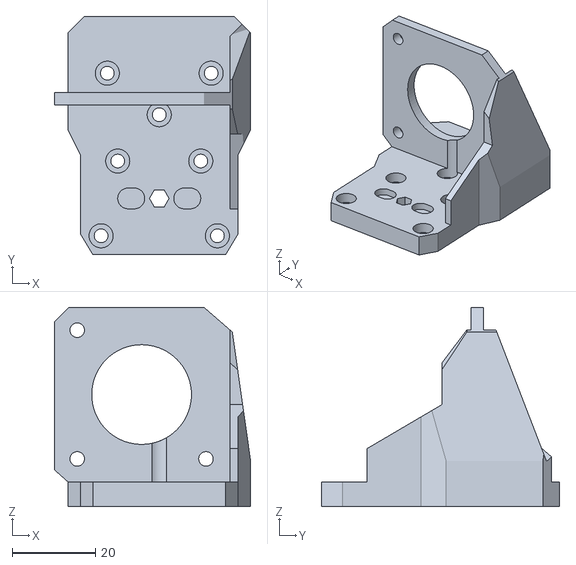
[picture p70: CAD file, 2022-05-08]
docs/stls/heat_insert/drive/bmg/drive_bmg.stl
47.2 x 57.3 x 48.0
