EVA-3D/eva-main/docs/stls/heat_insert/drive/lgx/drive_lgx.stl

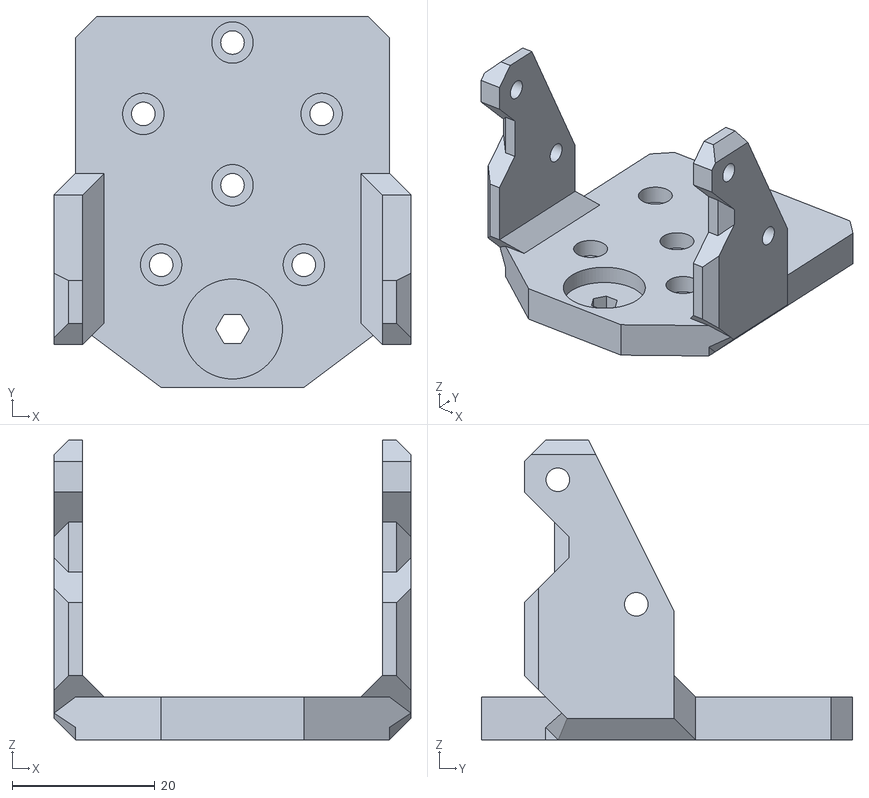
[picture p71: CAD file, 2022-05-08]
docs/stls/heat_insert/drive/lgx/drive_lgx.stl
50.0 x 52.0 x 42.0
