EVA-3D/eva-main/docs/stls/heat_insert/drive/lgx_lite/drive_lgx_lite.stl

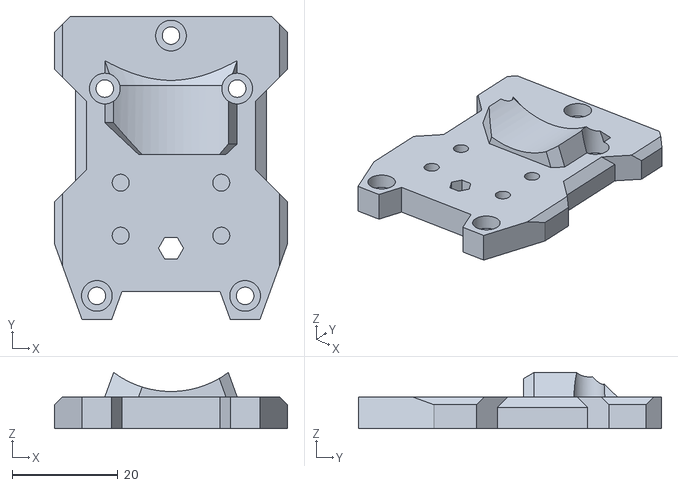
[picture p72: CAD file, 2022-05-08]
docs/stls/heat_insert/drive/lgx_lite/drive_lgx_lite.stl
44.0 x 57.3 x 10.6
