EVA-3D/eva-main/docs/stls/heat_insert/drive/orbiter_1_5/drive_orbiter_1.5_fi.stl

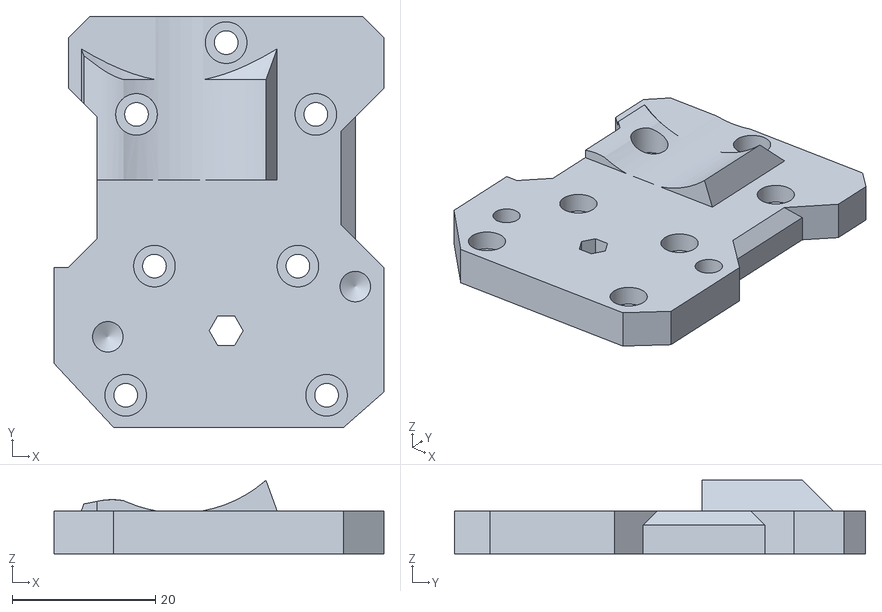
[picture p73: CAD file, 2022-05-08]
docs/stls/heat_insert/drive/orbiter_1_5/drive_orbiter_1.5_fi.stl
46.0 x 57.3 x 10.3
