EVA-3D/eva-main/docs/stls/heat_insert/drive/orbiter_2_0/drive_orbiter_2.0_fi.stl

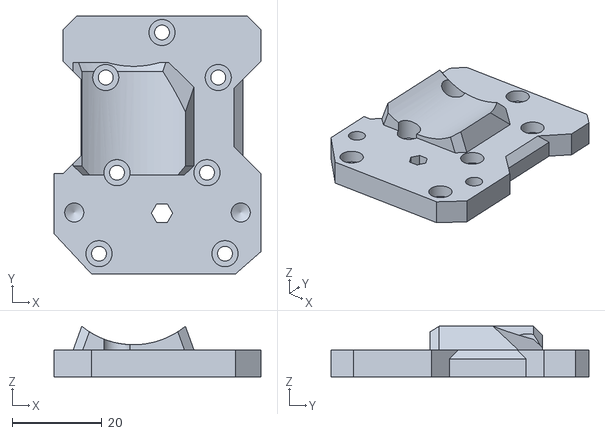
[picture p74: CAD file, 2022-05-08]
docs/stls/heat_insert/drive/orbiter_2_0/drive_orbiter_2.0_fi.stl
46.0 x 57.3 x 11.2
