EVA-3D/eva-main/docs/stls/heat_insert/hotend/bmo/hotend_bmo_fi.stl

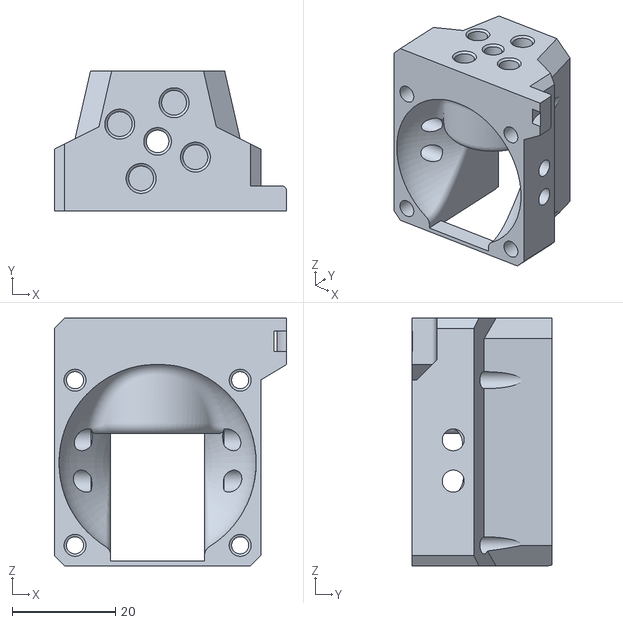
[picture p75: CAD file, 2022-05-08]
docs/stls/heat_insert/hotend/bmo/hotend_bmo_fi.stl
45.0 x 27.2 x 48.1
