EVA-3D/eva-main/docs/stls/heat_insert/hotend/mosquito/hotend_mosquito_fi.stl

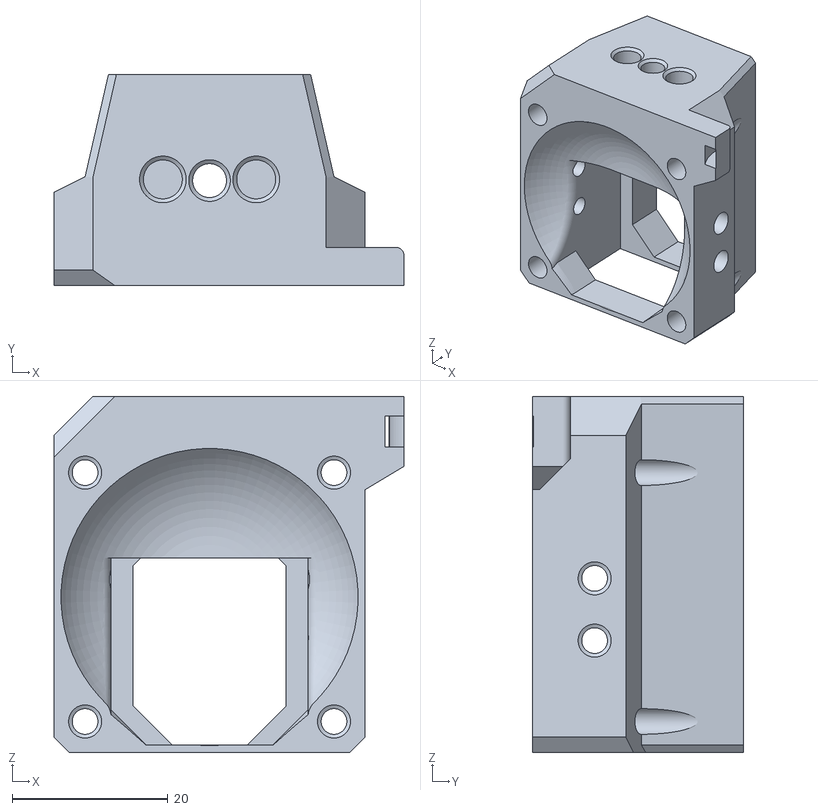
[picture p76: CAD file, 2022-06-12]
docs/stls/heat_insert/hotend/mosquito/hotend_mosquito_fi.stl
45.0 x 27.2 x 45.8
