EVA-3D/eva-main/docs/stls/heat_insert/hotend/nova/hotend_nova_fi.stl

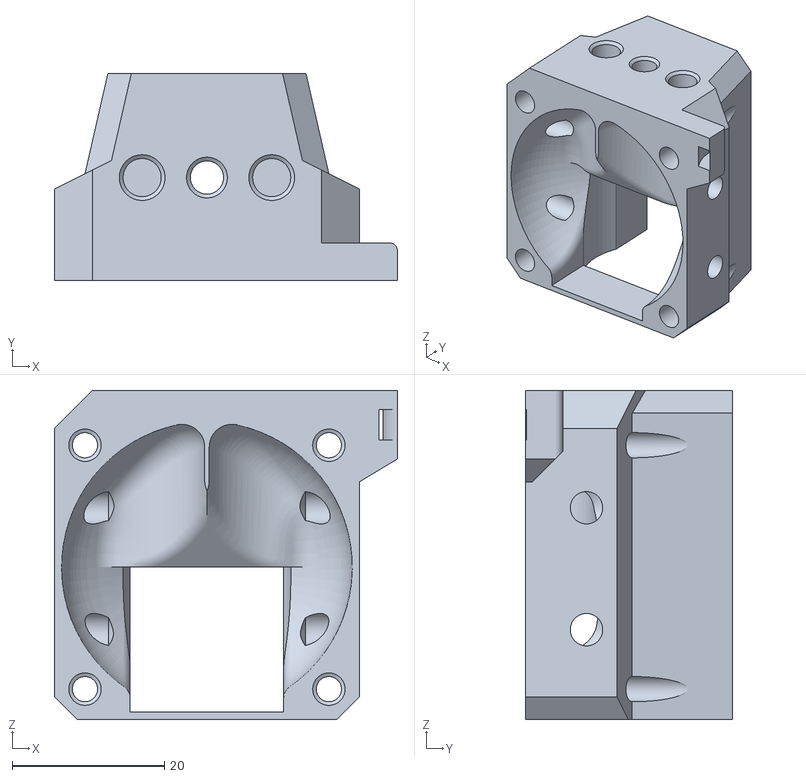
[picture p77: CAD file, 2022-05-08]
docs/stls/heat_insert/hotend/nova/hotend_nova_fi.stl
45.0 x 27.2 x 43.2
