EVA-3D/eva-main/docs/stls/heat_insert/hotend/rapido/hotend_rapido_fi.stl

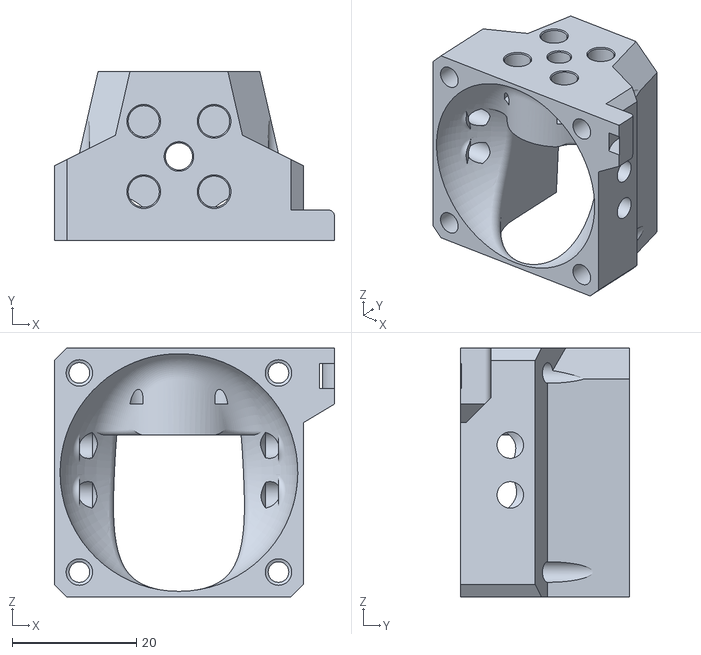
[picture p78: CAD file, 2022-05-08]
docs/stls/heat_insert/hotend/rapido/hotend_rapido_fi.stl
45.0 x 27.2 x 40.0
