EVA-3D/eva-main/docs/stls/heat_insert/hotend/revo_voron/hotend_revo_voron_fi.stl

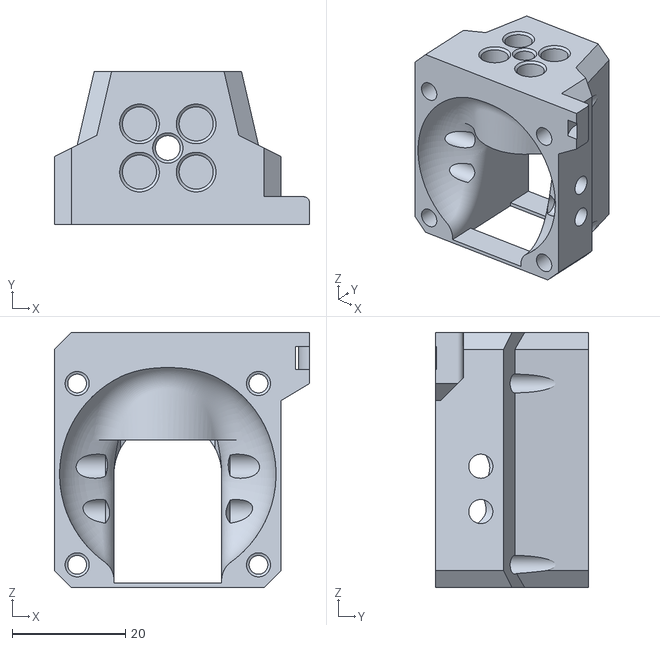
[picture p79: CAD file, 2022-06-25]
docs/stls/heat_insert/hotend/revo_voron/hotend_revo_voron_fi.stl
45.0 x 27.0 x 45.0
