EVA-3D/eva-main/docs/stls/heat_insert/probes/8mm_probe/lj8_probe_mount.stl

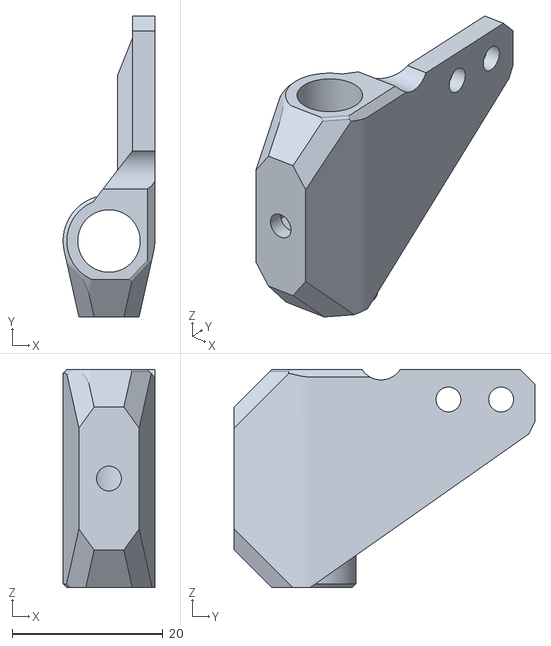
[picture p80: CAD file, 2022-05-08]
docs/stls/heat_insert/probes/8mm_probe/lj8_probe_mount.stl
12.2 x 40.0 x 29.0
