EVA-3D/eva-main/docs/stls/heat_insert/probes/bl_touch/bl_touch_mount.stl

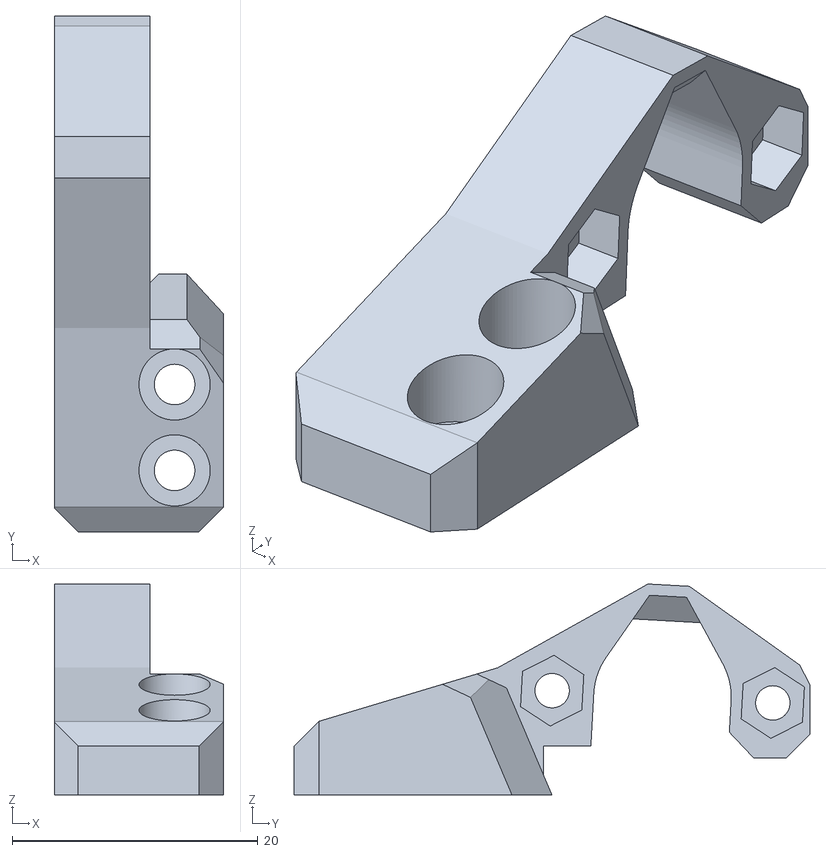
[picture p81: CAD file, 2022-07-09]
docs/stls/heat_insert/probes/bl_touch/bl_touch_mount.stl
13.8 x 42.0 x 17.2
