EVA-3D/eva-main/docs/stls/heat_insert/probes/bl_touch_volcano/bl_touch_mount_volcano.stl

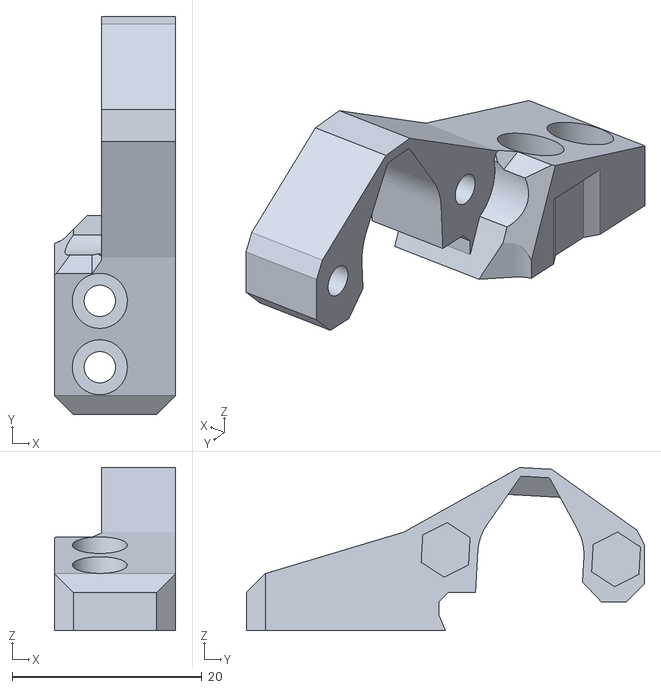
[picture p82: CAD file, 2022-07-09]
docs/stls/heat_insert/probes/bl_touch_volcano/bl_touch_mount_volcano.stl
12.8 x 42.0 x 17.2
