EVA-3D/eva-main/docs/stls/heat_insert/shrouds/all/shroud_chonky_fan_cover.stl

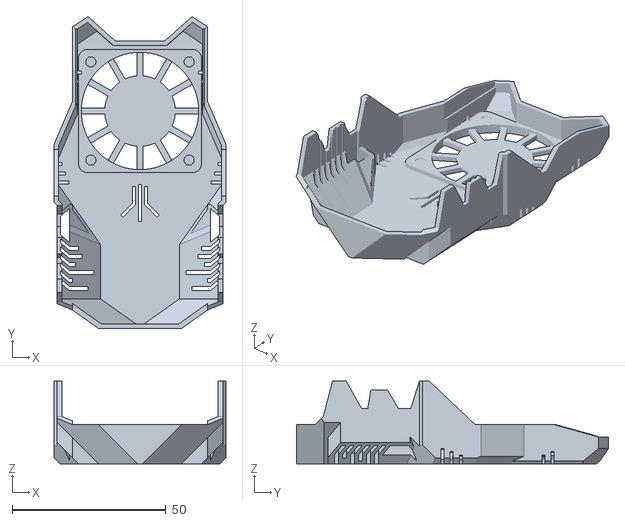
[picture p83: CAD file, 2022-05-10]
docs/stls/heat_insert/shrouds/all/shroud_chonky_fan_cover.stl
55.9 x 101.6 x 27.0
