EVA-3D/eva-main/docs/stls/heat_insert/shrouds/chonkier/shroud_chonky_cut.stl

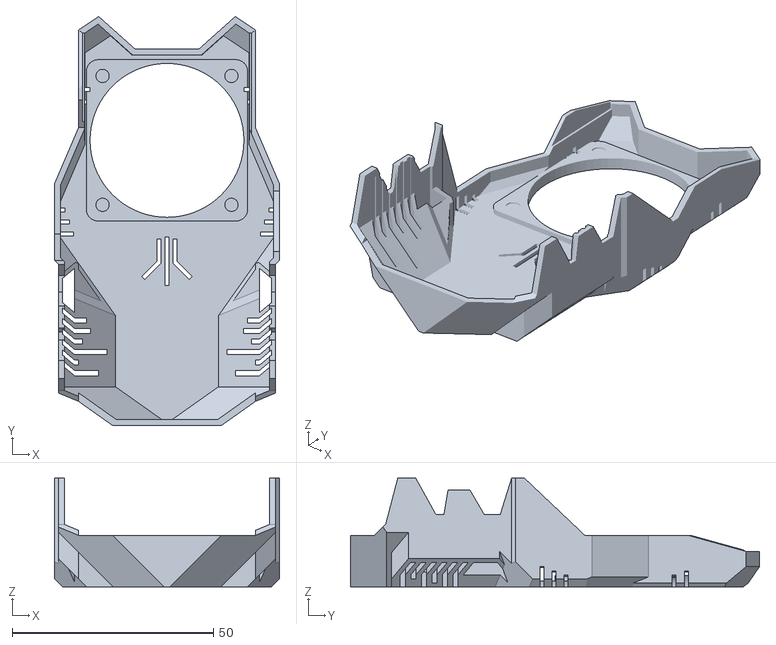
[picture p84: CAD file, 2022-06-12]
docs/stls/heat_insert/shrouds/chonkier/shroud_chonky_cut.stl
55.9 x 101.6 x 27.0
