EVA-3D/eva-main/docs/stls/heat_insert/shrouds/chonky/shroud_chonky_fan_cover.stl

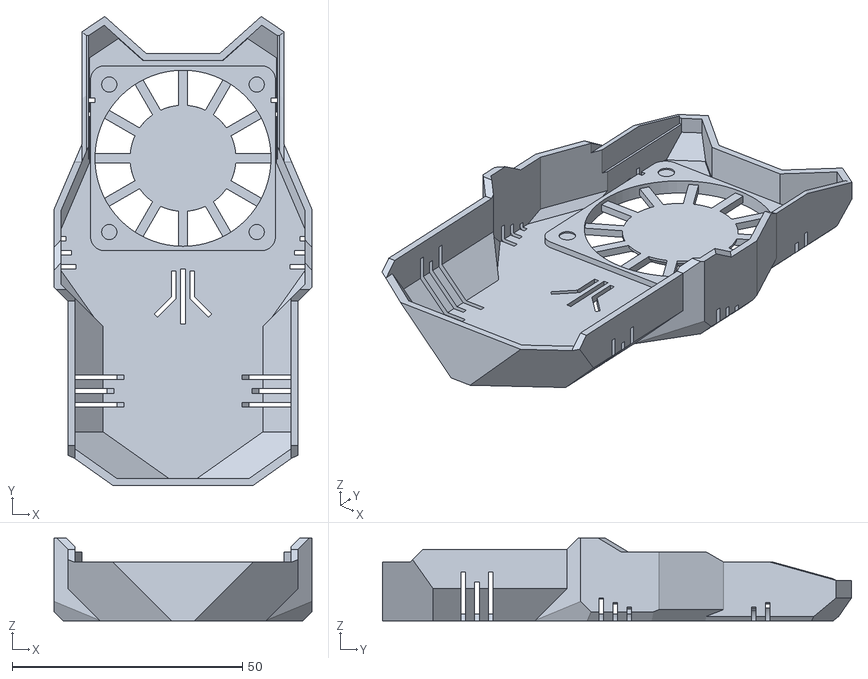
[picture p85: CAD file, 2022-06-12]
docs/stls/heat_insert/shrouds/chonky/shroud_chonky_fan_cover.stl
55.9 x 101.8 x 18.0
