EVA-3D/eva-main/docs/stls/heat_insert/shrouds/small/shroud_fan_cover.stl

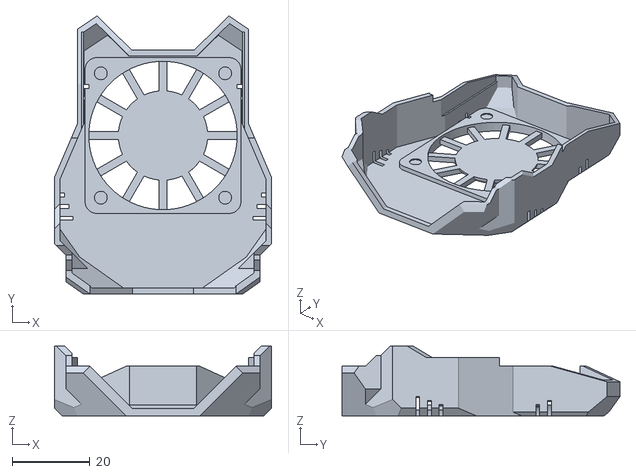
[picture p86: CAD file, 2022-05-10]
docs/stls/heat_insert/shrouds/small/shroud_fan_cover.stl
55.9 x 71.6 x 18.0
