EVA-3D/eva-main/docs/stls/heat_insert/shrouds/tank/shroud_tank.stl

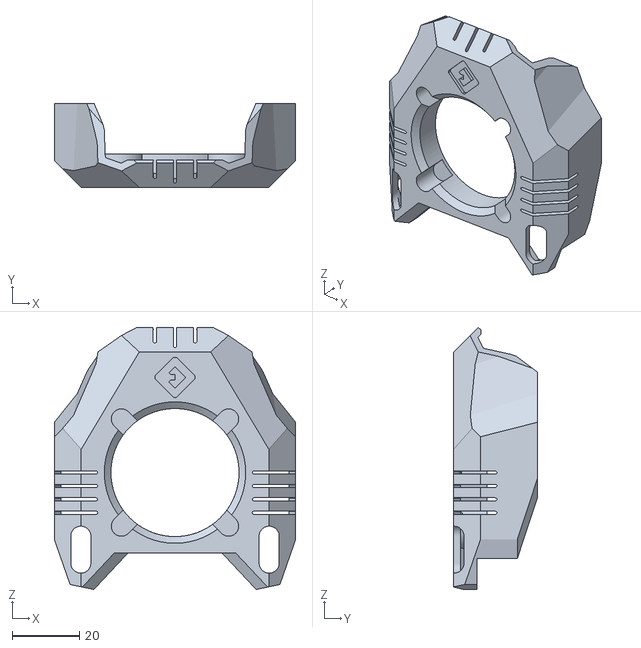
[picture p87: CAD file, 2022-06-12]
docs/stls/heat_insert/shrouds/tank/shroud_tank.stl
72.0 x 25.0 x 78.2
