EVA-3D/eva-main/docs/stls/hex_nuts/core/cartesian/cable_guide_mount_barrel.stl

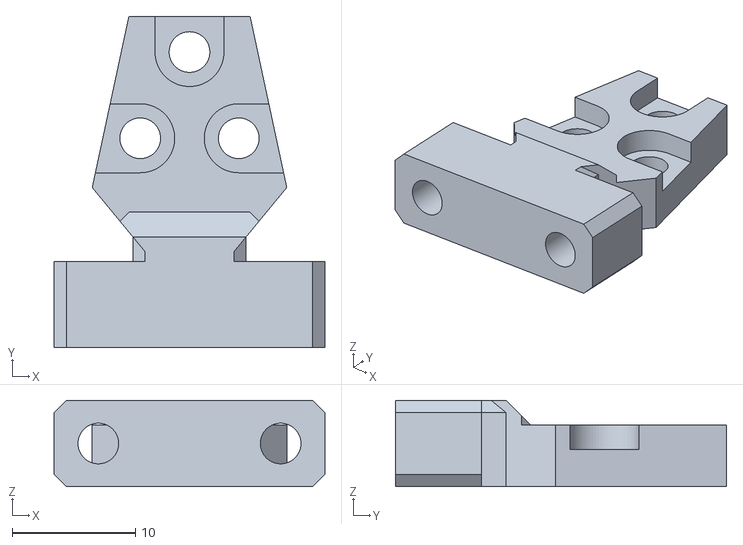
[picture p88: CAD file, 2022-06-12]
docs/stls/hex_nuts/core/cartesian/cable_guide_mount_barrel.stl
22.0 x 26.9 x 7.00
