EVA-3D/eva-main/docs/stls/hex_nuts/core/corexy/top_endstop_mgn12c.stl

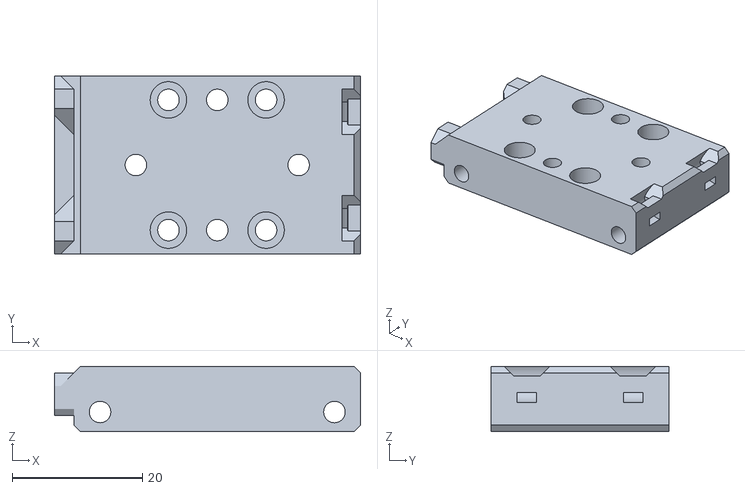
[picture p89: CAD file, 2022-06-12]
docs/stls/hex_nuts/core/corexy/top_endstop_mgn12c.stl
47.0 x 27.3 x 10.0
