EVA-3D/eva-main/docs/stls/hex_nuts/hotend/mosquito/hotend_mosquito.stl

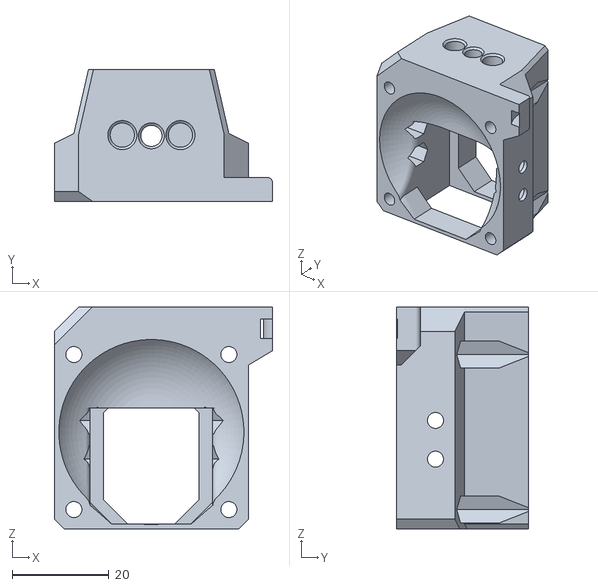
[picture p90: CAD file, 2022-05-08]
docs/stls/hex_nuts/hotend/mosquito/hotend_mosquito.stl
45.0 x 27.2 x 45.8
