EVA-3D/eva-main/docs/stls/hex_nuts/hotend/nova/hotend_nova.stl

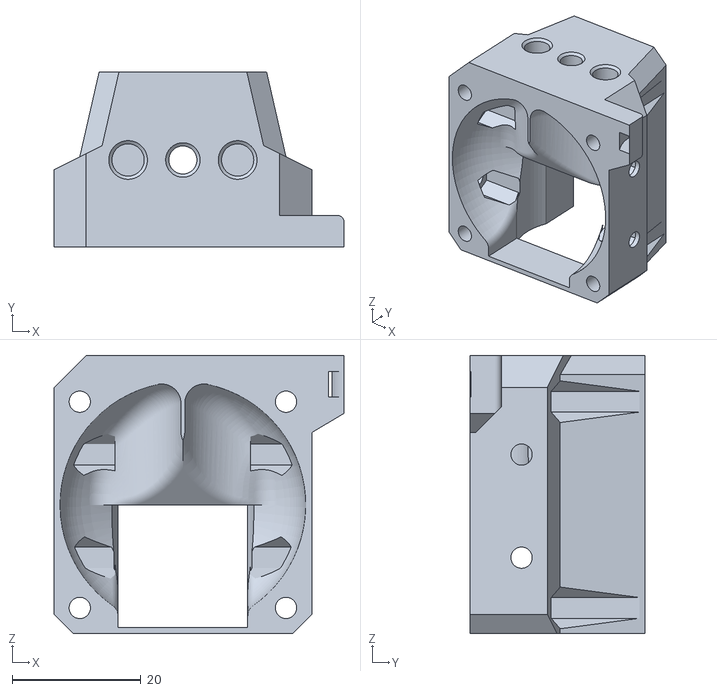
[picture p91: CAD file, 2022-05-08]
docs/stls/hex_nuts/hotend/nova/hotend_nova.stl
45.0 x 27.2 x 43.2
