EVA-3D/eva-main/docs/stls/hex_nuts/hotend/rapido/hotend_rapido.stl

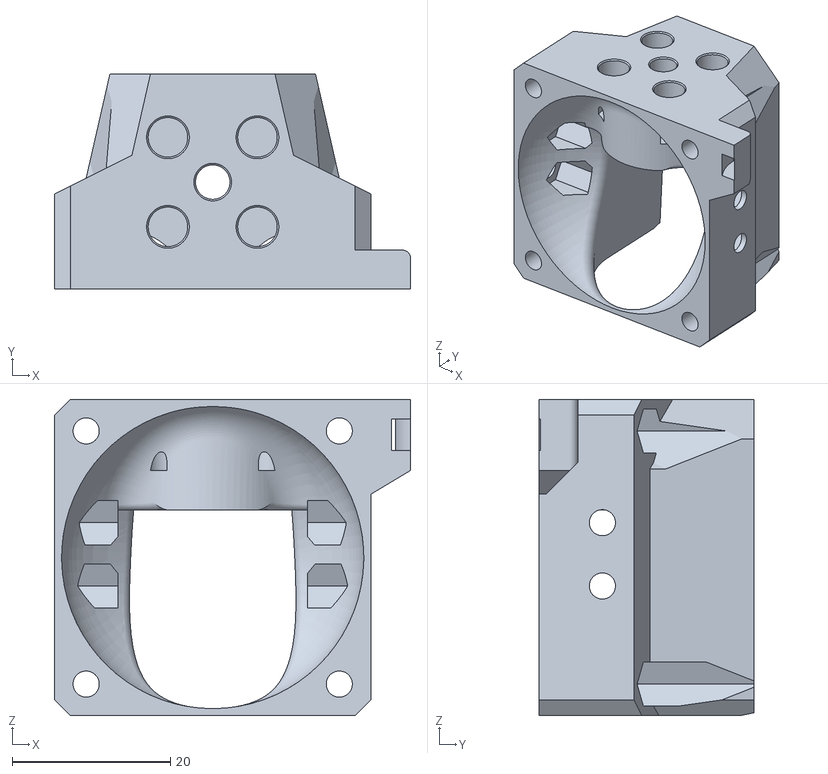
[picture p92: CAD file, 2022-06-12]
docs/stls/hex_nuts/hotend/rapido/hotend_rapido.stl
45.0 x 27.2 x 40.0
