EVA-3D/eva-main/docs/stls/hex_nuts/shrouds/chonkier/shroud_chonky_fan_cover_cut.stl

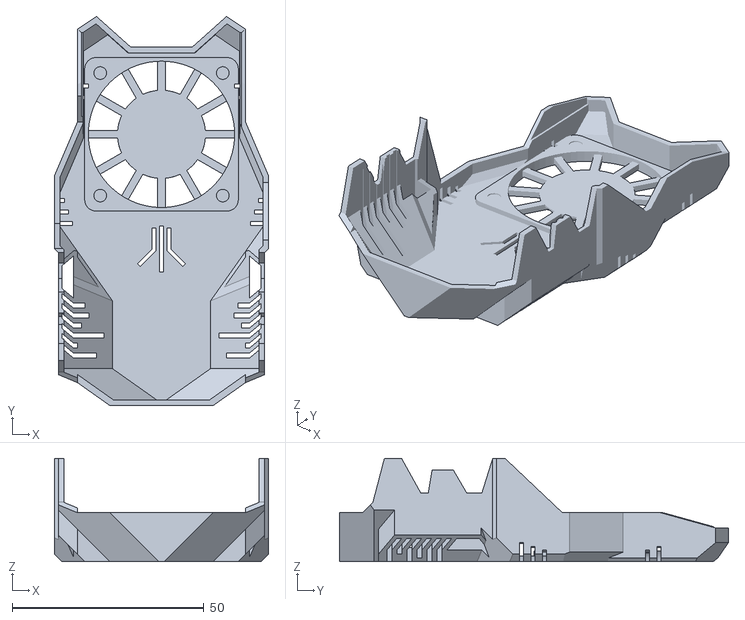
[picture p93: CAD file, 2022-06-12]
docs/stls/hex_nuts/shrouds/chonkier/shroud_chonky_fan_cover_cut.stl
55.9 x 101.6 x 27.0
