EVA-3D/eva-main/docs/stls/hex_nuts/shrouds/small/shroud.stl

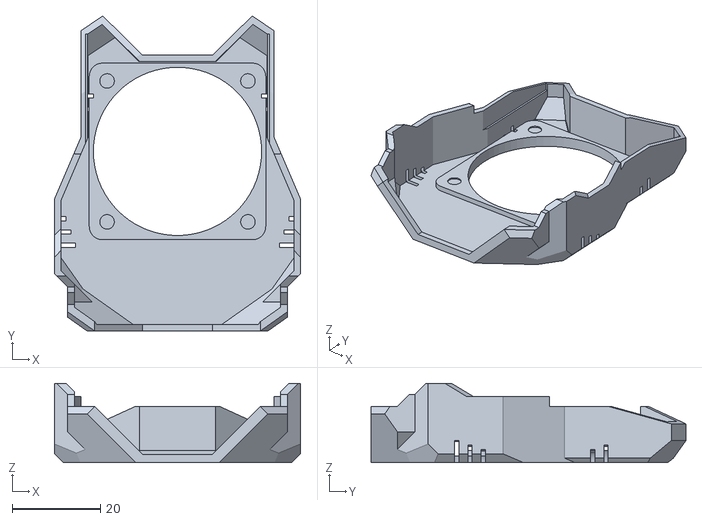
[picture p94: CAD file, 2022-05-10]
docs/stls/hex_nuts/shrouds/small/shroud.stl
55.9 x 71.6 x 18.0
