EVA-3D/eva-main/docs/stls/heat_insert/cable_management/guide/cable_guide.stl

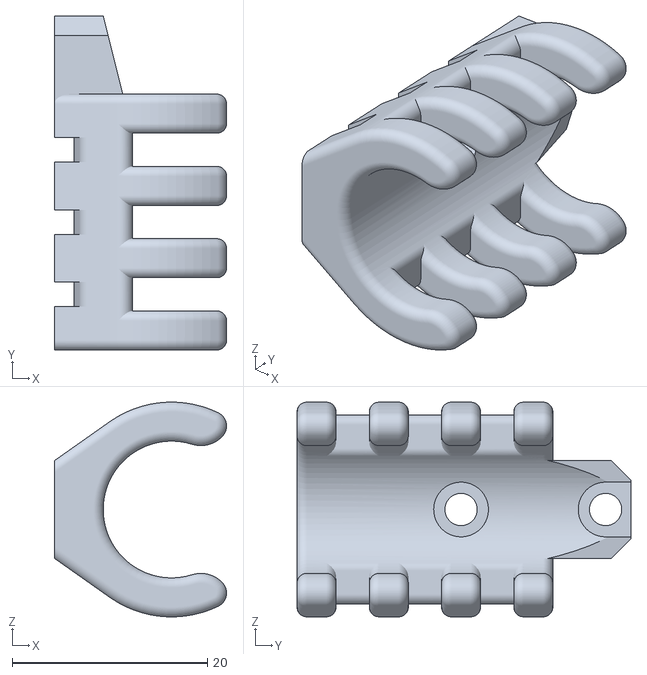
[picture p95: CAD file, 2022-05-08]
docs/stls/heat_insert/cable_management/guide/cable_guide.stl
17.6 x 34.2 x 22.0
