EVA-3D/eva-main/docs/stls/heat_insert/core/cartesian/back_cartesian_fi.stl

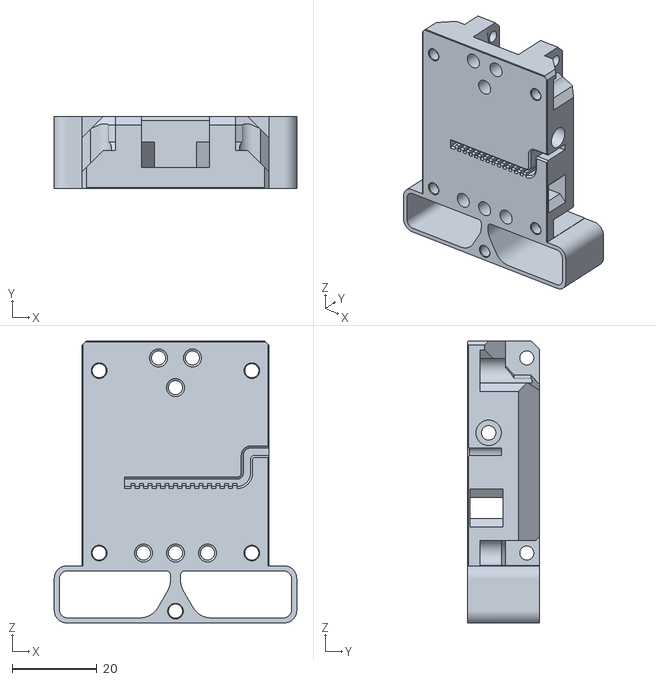
[picture p96: CAD file, 2022-05-08]
docs/stls/heat_insert/core/cartesian/back_cartesian_fi.stl
57.2 x 17.0 x 66.5
