EVA-3D/eva-main/docs/stls/heat_insert/shrouds/chonky/shroud_chonky.stl

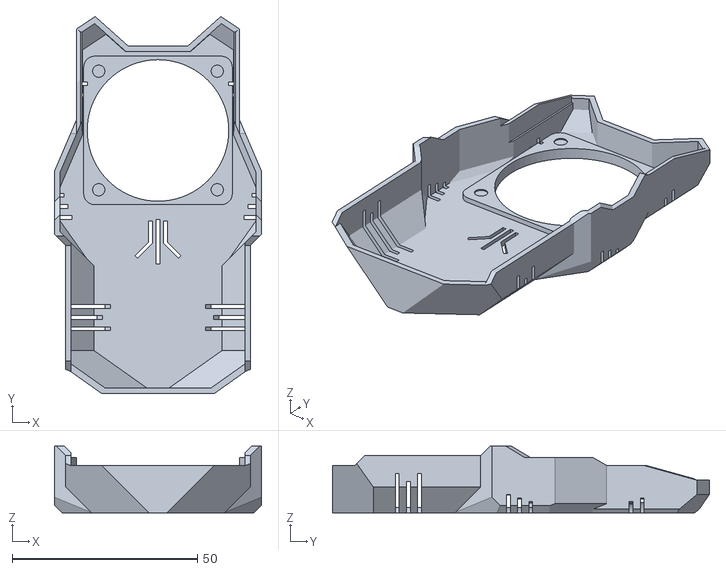
[picture p97: CAD file, 2022-05-10]
docs/stls/heat_insert/shrouds/chonky/shroud_chonky.stl
55.9 x 101.8 x 18.0
