EVA-3D/eva-main/docs/stls/heat_insert/core/cartesian/front_universal_fi.stl

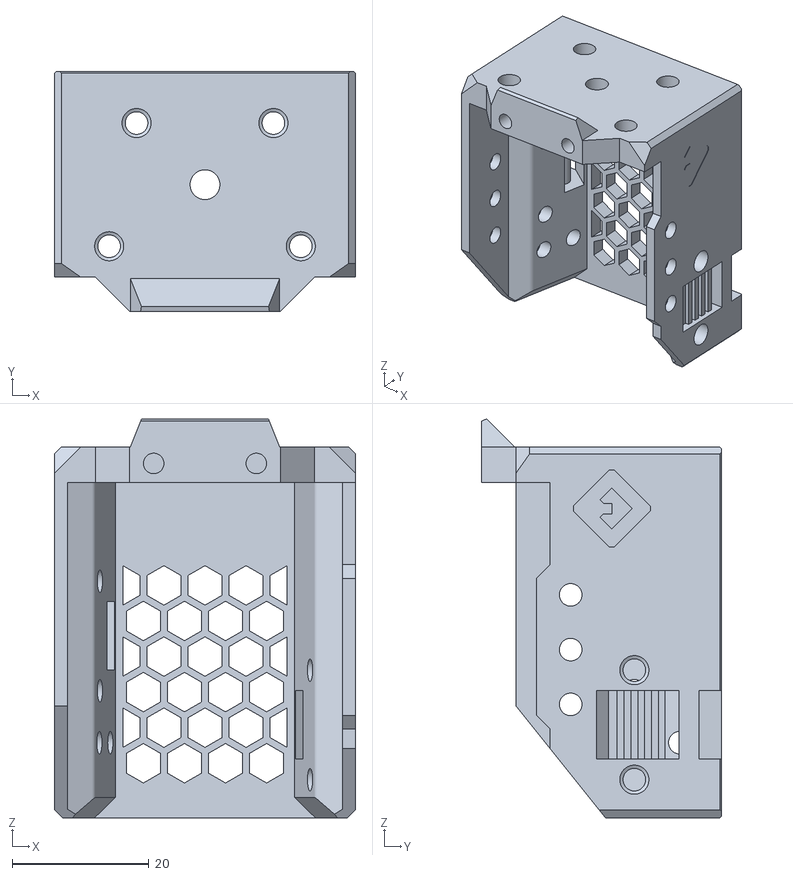
[picture p98: CAD file, 2022-05-08]
docs/stls/heat_insert/core/cartesian/front_universal_fi.stl
44.0 x 35.0 x 58.3
