EVA-3D/eva-main/docs/stls/heat_insert/core/corexy/core_xy_belt_grabber.stl

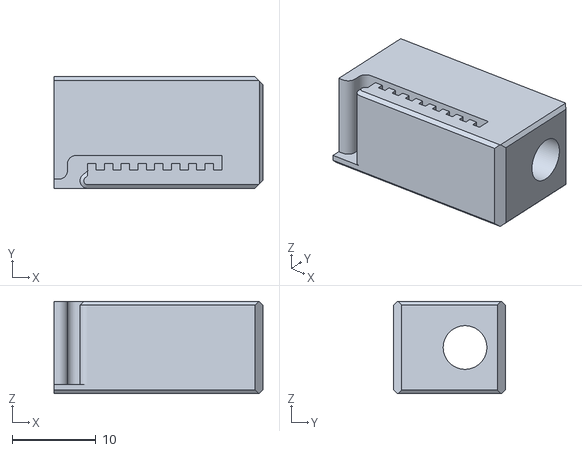
[picture p99: CAD file, 2022-05-08]
docs/stls/heat_insert/core/corexy/core_xy_belt_grabber.stl
24.9 x 13.3 x 11.0
