EVA-3D/eva-main/docs/stls/hex_nuts/core/cartesian/front_universal.stl

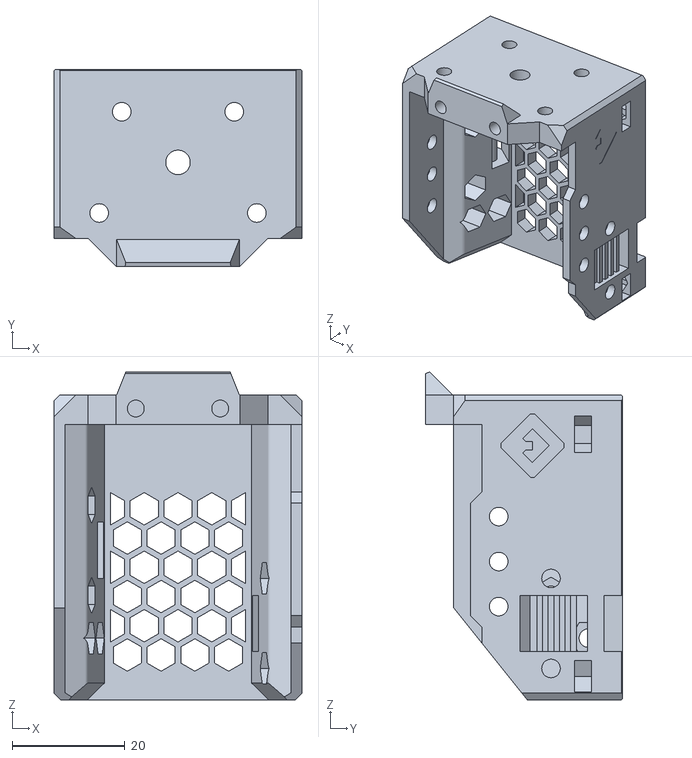
[picture p100: CAD file, 2022-05-10]
docs/stls/hex_nuts/core/cartesian/front_universal.stl
44.0 x 35.0 x 58.3
