EVA-3D/eva-main/docs/stls/heat_insert/core/cartesian/cartesian_belt_grabber.stl

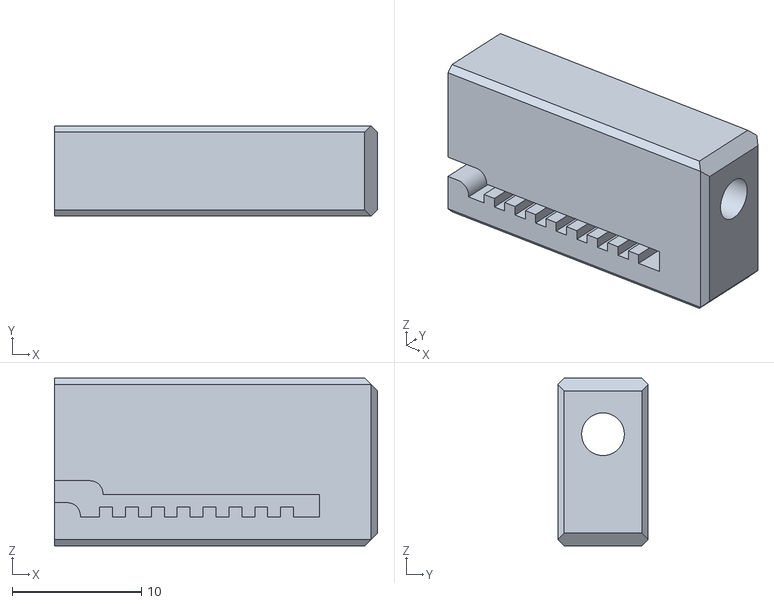
[picture p101: CAD file, 2022-05-08]
docs/stls/heat_insert/core/cartesian/cartesian_belt_grabber.stl
25.0 x 7.00 x 13.0
