EVA-3D/eva-main/docs/stls/heat_insert/core/corexy/back_core_xy_fi.stl

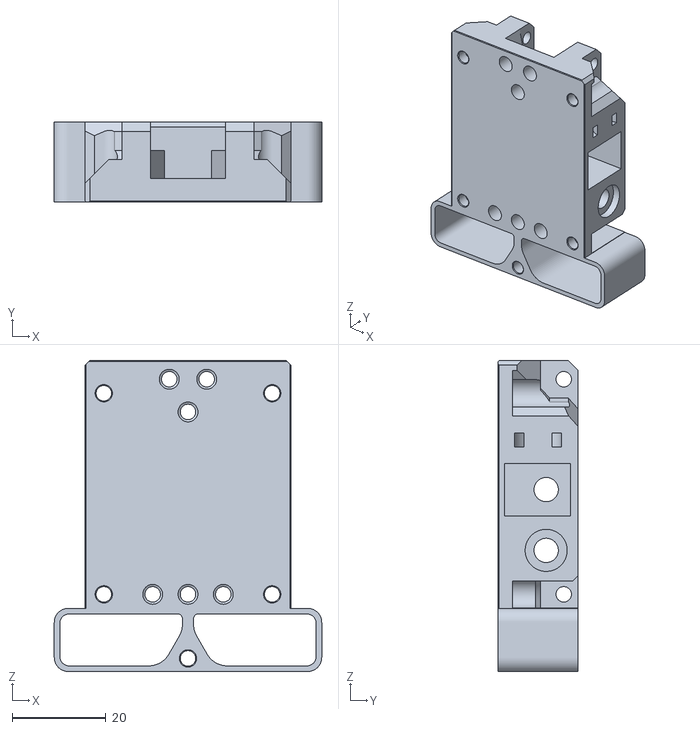
[picture p102: CAD file, 2022-05-08]
docs/stls/heat_insert/core/corexy/back_core_xy_fi.stl
57.2 x 17.0 x 66.5
