EVA-3D/eva-main/docs/stls/hex_nuts/core/corexy/face_belt_grabber.stl

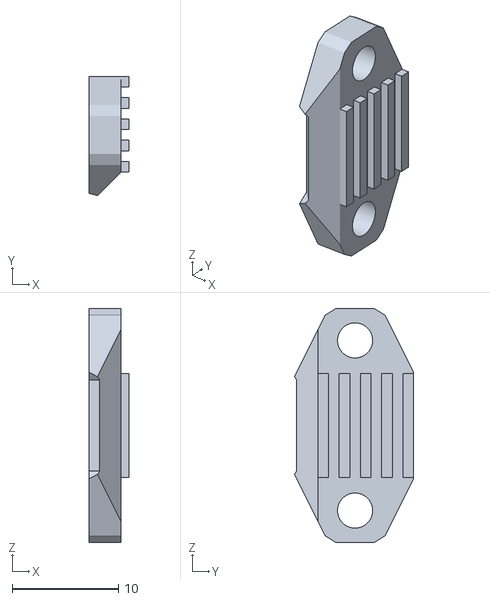
[picture p103: CAD file, 2022-05-08]
docs/stls/hex_nuts/core/corexy/face_belt_grabber.stl
3.75 x 11.2 x 22.0
