EVA-3D/eva-main/(list of files, cad)

Other CAD files:
docs/stls/hex_nuts/cable_management/guide/cable_guide_mount.stl
docs/stls/hex_nuts/cooling_inlet/40mm/40mm_fan_inlet.stl
docs/stls/hex_nuts/cooling_inlet/dual_5015/dual_5015_inlet.stl
docs/stls/hex_nuts/cooling_inlet/single_5015/5015_inlet.stl
docs/stls/hex_nuts/drive/orbiter_1_5/drive_orbiter_1.5.stl
docs/stls/hex_nuts/drive/orbiter_2_0/drive_orbiter_2.0.stl
docs/stls/hex_nuts/hotend/bmo/hotend_bmo.stl
docs/stls/hex_nuts/hotend/revo_voron/hotend_revo_voron.stl
docs/stls/hex_nuts/core/corexy/cable_guide_mount.stl
docs/stls/hex_nuts/shrouds/chonkier/shroud_chonky.stl
docs/stls/heat_insert/shrouds/chonkier/shroud_chonky.stl
docs/stls/hex_nuts/core/cartesian/back_cartesian.stl
docs/stls/hex_nuts/core/corexy/back_core_xy.stl
