EVA-3D/eva-main/include/heat_insert/cable_management/guide.md

---
title: Simple guide
eva:
  category: cable_management
  component: guide
  mounting: heat_insert
  name: heat_insert.cable_management.guide
title: Simple guide

---

{% extends 'component.md' %}
