EVA-3D/eva-main/include/hex_nuts/cable_management/guide.md

---
title: Simple guide
eva:
  category: cable_management
  component: guide
  mounting: hex_nuts
  name: hex_nuts.cable_management.guide
title: Simple guide

---

{% extends 'component.md' %}
