EVA-3D/eva-main/docs/onshape_assets/heat_insert.cable_management.guide.png

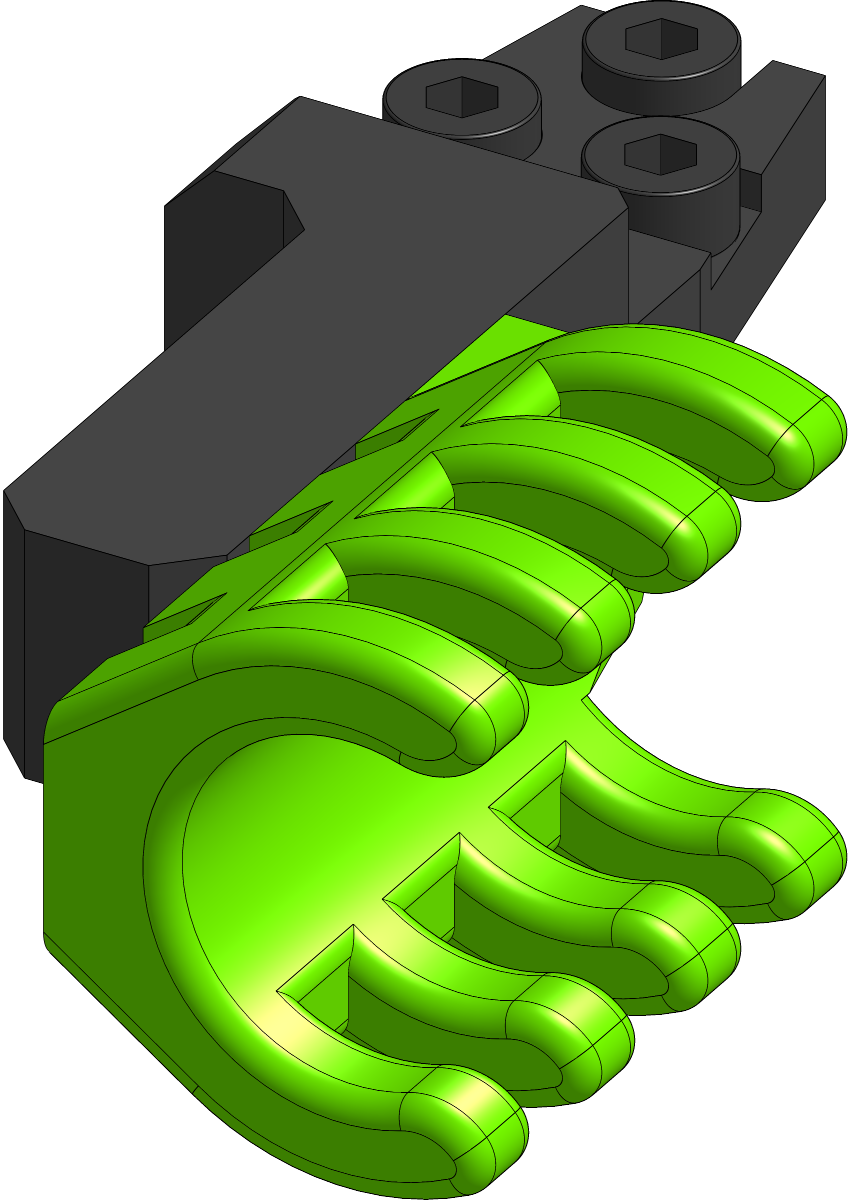
docs/onshape_assets/heat_insert.cable_management.guide.png
