EVA-3D/eva-main/(threads)

Thread 1 (2020-11-22):

Documentation: add explanation for new pokey pokey hole technique.

miklschmidt, 2020-11-22:
~~I've noticed that some screw holes are missing in a couple of parts. The few I've noticed so far: The V6 shroud, core xy back (3 holes for universal cable mount), the universal cable mount itself is missing from the EVA 2 repositories, but is missing holes in newest EVA 1 as well. I will keep an eye out as i begin to print the EVA 2 parts and list them here.~~

Update: See discussion.

pkucmus, 2020-11-23:
If you are talking about for e.g. those:
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
then that's my ~time saving~ professional technique that allows the holes to be printed mid-air. One then needs to poke or drill the holes before assembly.

miklschmidt, 2020-11-23:
@pkucmus ooooh. I see! Fair enough. I might've missed the memo on that one.

pkucmus, 2020-11-23:
Still a valid note to self to document that. Thanks!

miklschmidt, 2020-11-23:
@pkucmus i've updated the issue to reflect the needed change :)

pkucmus, 2020-11-30:
Fixed: https://eva-3d.github.io/eva-main/printing/#pokey-pokey-hole-technique

Closed 2020-11-30.

Thread 3 (2020-12-07):

Feature Request: Alternative blower fan sizes.

miklschmidt, 2020-12-07:
It would be really cool if we could swap the 90 deg back for a 5020 or even 6015 version. I don't know if larger ones will be possible but... basically as large as we can go. Here's a few options:
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

miklschmidt, 2020-12-07:
There's like a 30% difference between the 5015 and 6015 sunons in airflow. Moving to a 7030 would give us almost 3,5 times the airflow at the same noise level. But that one is a chonker (would love it though :D)!

pkucmus, 2021-05-09:
@miklschmidt anything to share / document here from the work done on Discord?

miklschmidt, 2021-05-09:
@pkucmus Yes!

7530 seems to outperform dual 5015's in the test i've done so far. Which makes sense because it's as stated previously quite a lot more airflow. The duct in it's current form does not benefit much from a 7530 or dual 5015's as there's simply not enough room to move more air. What we had to do is increase the width of the bottom duct by 10mm, and beef up the horns to something like 2x, and add a middle duct on top of that. Regarding fans, there's a really really interesting option that i'm trying to get my hands on, the Delta BCB0812UHN, a 75x80x30 fan. It has 5 times the pressure of my current Sunon 5015's and 10 (!!) times the airflow. Still waiting to receive one.

Supersniffles came up with a pretty elegant Dual 5015 fan design that only costs around 2mm on Y on the 1.3, no space is lost on the V3 (except if you have stuff mounted on the back extrusion, unfortunately). But it looks like the ducts aren't quite wide enough to fully utilize the airflow of the 5015s.

miklschmidt, 2021-05-09:
With the 7530, the 10mm wider duct and the "monster horns duct" from supersniffles i succesfully printed a 20 minute benchy without any signs of cooling problems.

miklschmidt, 2021-05-09:
I don't know if it makes sense to look at something like the HevACS instead, but it's just such a brute force solution 😂

miklschmidt, 2021-05-09:
One thing is for sure though, the current duct design and single 5015 is underpowered relative to the performance we can get out of the Rat Rig machines currently. That's a shame. It's very hard to print a benchy faster than 50 minutes with the current design. You can't print 45 degree overhangs much faster than 50-70 mm/s (depending on the fan). It's just not good enough, given the hardware we have available, so some solution needs to be found, in my opinion.

flow23, 2021-05-12:
Oh yeah. Bigger fans. This would also help the V-Cast I guess.

pkucmus, 2021-05-15:
Should we change the standard and increase the fan output on all `back` part?

miklschmidt, 2021-05-15:
Unless there’s a good reason not to, i would say yes!

Closed 2021-09-04.

Thread 7 (2020-12-31):

Toolboard support

pkucmus, 2020-12-31:
Moved from EVA 1 https://github.com/pkucmus/EVA/issues/24

philkry, 2021-01-25:
@pkucmus do you have a plan already on when this will get implemented?
Or is there maybe some bleeding-edge version available to test?

pkucmus, 2021-01-25:
@philkry I'm working on the 2.2.0 release currently, this is meant for 2.3.0

pkucmus, 2021-01-25:
@philkry I found the previous attempts we tried: https://cad.onshape.com/documents/bbefa7dc6aa8749d2947b610/w/f35b0df99ac53a3b3afd0ae4/e/8b3fb665196e336e4b59316d maybe you'll find something usable

Closed 2021-09-04.

Thread 8 (2020-12-31):

EVA on BLV

pkucmus, 2020-12-31:
Moved from EVA 1: https://github.com/pkucmus/EVA/issues/32

pkucmus, 2020-12-31:
This maybe a more of a BLV project than EVA project but for the sake of tracking I'll leave this here

morpheus200, 2021-03-03:
After your upgrade to EVA 2 and support of the Mosquito Hotend (Thanks a lot) i have printed all parts and have also encountered this problem. Mirroring the front helps but for the rear side this is not possible because the fan is the wrong way round.
It looks like it is a problem with the BLV Cube design, because the belts are guided differently.

damik422, 2021-03-08:
Hey I have a hevort not a BLV but the belt path is similar. I have a problem, the rear belts are flipped so that the teeth side faces away from the 2020 extrusion. The belt holders are designed for the belts facing the other way around. Is there a way to mitigate that or do i have to modify the belt holders so that they have teeth on the other side of the channel for the belt? ps. im using 6mm belts

pkucmus, 2021-03-09:
> Hey I have a hevort not a BLV but the belt path is similar. I have a problem, the rear belts are flipped so that the teeth side faces away from the 2020 extrusion. The belt holders are designed for the belts facing the other way around. Is there a way to mitigate that or do i have to modify the belt holders so that they have teeth on the other side of the channel for the belt? ps. im using 6mm belts

Please check in the Onshape document in the 'backs' folder. There's a high chance those are already there.

pkucmus, 2021-03-09:
Here: https://cad.onshape.com/documents/1765b04fac582f6c1c470bd3/w/1cc31596374d6ce51cd23fa9/e/626c5e88e2db7d8a29b52142
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

tetele, 2021-03-10:
Finally published the conversion kit for the BLV MGN Cube on the contributions repo https://contrib.eva-3d.page/printer-compatibility/blv-mgn-cube/

Closed 2021-09-04.

Thread 9 (2020-12-31):

Duet Mini IR sensor

pkucmus, 2020-12-31:
Moved from EVA 1: https://github.com/pkucmus/EVA/issues/18

pkucmus, 2021-01-08:
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

Few things I was trying to consider:
1. how the pins are aligned, they go outwards into X-, I made a cut to loop the wires under the probe mount and guide back
2. since I haven't tested it yet and never used it before I don't know if the cover makes sense or not
3. I initially tried a different orientation with the electronics facing the hotend but that did not feel comfortable with that, especially when Mosquito is considered (wide heat block)

tetele, 2021-01-10:
@pkucmus the capacitor is not necessarily that short in all models, so in my case, i the cap would be unusable because the capacitor would have nowhere to go https://imgur.com/a/9IULosT

Also, keep in mind that the usable range of the IR sensor is pretty small, so there would have to be brackets for different height hotends (I'm thinking about the Volcano in particular here).

Ronniehertog, 2021-01-30:
Hi all,

 I was looking for a IR probe mount, found this and 're-desinged' it so it can slide up and down, and to be firmly attached using the embeded nuts on the left hand side.

[IR sensor mount v2.zip](https://github.com/EVA-3D/eva-main/files/5898535/IR.sensor.mount.v2.zip)

tetele, 2021-02-01:
@Ronniehertog some "default position" indicators for V6 and Volcano standard height screw positions would make it great. But that's just nitpicking.

Apart from that, I have one single issue with this design: not everybody will be able to print the long bridge in the regular printing position (i.e. right hand side of the screw channel).

But a very elegant solution, congrats!

Thread 10 (2021-01-01):

EVA 2 / Orbiter (Orbiter support)

pkucmus, 2021-01-01:
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

MGN 12: https://cad.onshape.com/documents/bb8303124bc8370b6d1924bc/w/8276a22c579374e8b02e9b96/e/6b8206d26df549409bc1d1b2

MGN 15: https://cad.onshape.com/documents/551442bc5664b4216eddf506/w/16749997681c8bec66757f15/e/8952ad2027c63b84e64fdcba

pkucmus, 2021-01-16:
Added the Orbiter CR-10 version to both MGN12 and MGN15

tetele, 2021-01-19:
Using this on a BLV MGN Cube with a Volcano 0.4mm nozzle. The assembly went great, as with all EVA components.

Here's a sample print at 0.2mm height, 80mm/s perimeter speed and 100mm/s infill speed. Acceleration 3000, except for external perimeter, which is capped at 300 for a better finish. Colorfabb economy PLA black @ 200deg

I could have gone higher with the acceleration, but I haven't really tuned it yet.

https://imgur.com/a/QLx88BT

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

Closed 2021-02-04.

Thread 11 (2021-01-07):

BLTouch mount interferes with probe

shuffleznl, 2021-01-07:
First of all, many thanks for a great design. Amazing work!

Quick one on the BLtouch Standard mount; the vertical overhang-reinforcement to support the horizontal BLtouch mount area interferes with the mounting 'flange' of the BLtouch itself.

It's only ever so slight, may just be 1mm off in the design.
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

pkucmus, 2021-01-07:
Thank you for the ticket, I'll look into it

pkucmus, 2021-01-07:
Looking at the picture, there's a chance your printer is overextruding a bit but the lack of tolerance on the design is an issue I just fixed.
You can find the new part here:
https://cad.onshape.com/documents/94cafeab52e3dfa0a28bae89/w/99794094315556b24b5664ec/e/d6374a1e5b14711360d3b164

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

Please let me know if it works.

shuffleznl, 2021-01-07:
Extrusion still needs to be tuned yes :) Printed way too fast (💯mm/s) on 0.15 with very poor non-dried 'transparent' Amazon filament :). Currently still run V-Core (rails) w/o EasyMod and EVA, printed EVA components fit like a glove though, your design is awesome! Will print all again slower with Easy & EVA ❤️

Printing now.

Closed 2021-01-07.

Thread 12 (2021-01-08):

[BUG] The bolt that secures the endstop mount to the top plate hits the MGN carriage on the Orbiter assembly

tetele, 2021-01-08:
## Describe the bug
Wrong offset between the bottom plane of the top piece and the lip of the endstop groove on the top piece (the groove is too close to the bottom).

## Actual behavior
The bolt that secures the endstop mount to the top plate hits the MGN carriage, so I can't secure the endstop mount to the top piece

## Expected behavior
I can screw in the bolt that secures the endstop mount to the top piece all the way, so that the endstop mount is rigid against the top piece.

## Pictures
https://imgur.com/a/RWgkyJs

## Device
 - EVA version: 2.1.1
 - Orbiter Assembly

## Additional context
Add any other context about the problem here.

pkucmus, 2021-01-08:
Fixed, thank you: https://cad.onshape.com/documents/bb8303124bc8370b6d1924bc/w/8276a22c579374e8b02e9b96/e/09d4e72250a20923ab87fce6

Closed 2021-01-11.

Thread 13 (2021-01-08):

[FR] DyzeExtruder support

msource, 2021-01-08:
## Describe the solution you'd like
DyzeExtruder is becoming a good alternative to Hemera and TL Matrix, there are more reasons why this is a good extruder. Challenge to use this in the EVA2 support :)

### Functional and non-functional requirements
- Add possibility to use the DyzerExtruder for the EVA2 mount

### Proposed solution
Add EVA2 support for the DyzeExtruder

### Additional context
[DyzeExtruder](https://dyzedesign.com/2020/08/the-ultimate-guide-to-3d-printer-extruder/)

Closed 2021-09-04.

Thread 14 (2021-01-10):

[BUG] Holes in hemere probe adapter wrong size

WartyTowel, 2021-01-10:
Hi,

I open the bug here, I was not able to find a way to open a issue in the hemera repo.

The file "hemera_probe_adapter.stl" has two holes to fit nuts in, this nuts will hold the probe holder, if I'm not wrong. The holes have 5mm after printing but M3 nuts have 5,4mm outder diameter from site to site. So the nuts will not fit, not even with some force.

All other printed parts worked very fine, so I guess that it is a problem with the part, not with my printer or my settings.

Cheers, Chriss

Closed 2021-01-11.

Thread 15 (2021-01-11):

[EP] Bottom plate endstop mount

tetele, 2021-01-11:
## Problem description
There are printer designs where the X endstop is mounted below the gantry.

## Describe the solution you'd like
A bottom plate groove (identical to the one on the top plate) to mount same-spec endstop carriers would be super beneficial.

### Functional and non-functional requirements
- place endstop below the aluminium extrusion
-  (nice to have) allow the endstop switch to be slid under/in the carriage, so that you get more range of motion in the X axis

### Considered Alternatives
Routing a mount/support from the top plate around the gantry and avoiding the belts is complicated and does not produce structurally rigid parts. Not to mention elegant ones.

### Additional context
Case in point: the BLV MGN Cube printer design, where the X endstop is mounted below the carriage and hits a vertical surface in the leftmost piece that connects the gantry to the Y linear rail.

Closed 2021-09-04.

Thread 16 (2021-01-13):

Published STL's of the Bowden top does not fit MGN12H

rveda, 2021-01-13:
## Describe the bug
Published STL's of the Bowden top does not fit MGN12H

## Actual behavior
The hole pattern matches MGN12C

## Expected behavior
The STL file to have the enlogated screw holes like in the CAD model.

## Pictures
I exported the top piece from the CAD model and compared it to the STL
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

## Device
Hemera download and the complete download

rveda, 2021-01-13:
Sorry. Didn't realize it was not released yet. You can close this Issue.

pkucmus, 2021-01-14:
For future reference, the parts in question are yet to be released and I need to do a better job describing that the Onshape links are always bleeding edge.

Closed 2021-01-14.

Thread 17 (2021-01-14):

[EP] Support larger motors on the BMG direct drive

tetele, 2021-01-14:
## Problem description
If you use a motor that's larger than the 25mm pancake in the design, it would hit the universal cable mount and not fit

## Describe the solution you'd like
I'd like to have either a universal cable mount or cable holder mounting point on the top BMG direct drive plate.

### Functional and non-functional requirements
- have the possibility to use larger motors for the direct drive BMG and also have a cable holder
- have alternative mount points for the cable holder

### Proposed solution
Widen the top hole on the universal cable mount (the one that's not countersunk for bolt heads) to 3mm and align it with the side holes on the top piece so that you can mount the cable holder laterally. https://www.screencast.com/t/a7jK3fgvZad

### Considered Alternatives
Only bad ideas :D

### Additional context
The BLV MGN Cube BOM includes a 40mm extruder motor that doesn't fit the EVA 2.1.1 mounts.

pkucmus, 2021-01-14:
I have a few comments (open for discussion):
1. Use 25mm or 23mm NEMAs - if someone has access to those then those should be used to reduce the X gantry weight, I understand that not everybody wants to pony up for one hence more points...
2. This could be an adapter to move the cable holder to the side 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
3. Probably the least involved idea, move the holes on the cable holder part to match the extra side holes on the BMG and Titan parts (that's what those were for initially): 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

EduardoOliveira, 2021-01-14:
As a quick and dirty solution, once upon a time I inserted m3 nuts as
spacers in between the carriage and the cable holder to accommodate the e3d
pancake wich is bigger than normal, I don't believe it to be 40mm thought.

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

pkucmus, 2021-01-14:
At one point only 23mm pancakes fit, now 25mm (like the E3D ones) are supported as well

tetele, 2021-01-14:
@pkucmus regarding point 3 above, those holes don't line up. I think it would be a good enough idea if it were feasible, but it's not. What should change? The top or the cable holder?

tetele, 2021-01-15:
That would imply redesigning the entire holder, as you can't have the holes poking through the channels meant for zip ties. Also, you'd get less wall thickness if you move those holes to be 10mm apart instead of the 7.4mm that's currently between the "fingers" of the cable holder.

So my question is: why not enlarge the top hole on the universal cable mount to 3mm diameter and align it so that it's exactly 10mm apart (center to center) from the bottom screw hole on the same piece? That would fit nicely in the sidewall of the direct drive top mount.

pkucmus, 2021-01-15:
Those extra holes are to grab a thread of filament to make the cable bunch stiffer (like the nylon trick Prusa does). I just think there are more solutions to that problem :) To narrow down and add one other:
1. Making a new cable holder part - I still think it's possible, just the ziptie spacing would need to change
2. Do what you are describing and make a different cable post that would take the 2 hole 10mm spacing on the side.

The tops are complex (in maintenance) and should be last to change.

tetele, 2021-01-18:
@pkucmus any favorites?

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

pkucmus, 2021-01-18:
I like them both. From experience I can tell you that 2 zip ties is sometimes not enough so the first one my behave better.

tetele, 2021-01-18:
My thoughts exactly. I'll edit the universal cable mount post and upload them both here. Thanks!

tetele, 2021-01-18:
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

[modified cable holder.zip](https://github.com/EVA-3D/eva-main/files/5829766/modified.cable.holder.zip)

Closed 2021-09-04.

Thread 18 (2021-01-15):

[EP] Support for Sidewinder X1 Daughterboard / NF Crazy Hotend

nicedevil007, 2021-01-15:
Heya just want to ask if you can create a "Sideplate" to mount the Artillery Sidewinder's Daugtherboard for the ribbon cable.

Besides the NF Crazy Hotend from Mellow I just wanted to ask if your version for the Mosquitto would be compatible?
The NF Crazy is a bit more as a triangle but the rest (cooling part) is the same from dimensions.

pkucmus, 2021-03-05:
Widely understood support for the Sidewinder is not something I can tackle right now. NF Crazy is not officially supported but it may work by accident.

top-gun, 2021-03-05:
The NF Crazy does work by accident :) I've been using one for a few weeks.

Closed 2021-03-05.

Thread 19 (2021-01-17):

[EP] Support for Bondtech LGX

pkucmus, 2021-01-17:
## Problem description
Bondtech is releasing this new (face heavy) extruder/hotend which is already of high demand. EVA should support it especially that @ogland already made the work for EVA 1.

## Describe the solution you'd like

General support for Bondtech LGX

### Functional and non-functional requirements
- as a first pass, port @ogland's work to EVA 2

### Proposed solution

None

### Considered Alternatives

None

### Additional context

None

pkucmus, 2021-03-27:
Open for testing: https://cad.onshape.com/documents/d2a2f19b34851a8570487add/w/1ff9bb9662c715a9cdc3d984/e/f74cb56cf915933a84ff4023
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

ogland, 2021-03-27:
Looks good! Looking forward to seeing your approach to LGX FF.

pkucmus, 2021-03-27:
@ogland I aim to port yours as well and release both

pkucmus, 2021-03-27:
Would be cool if it was printable... don't print - there's still much work to do with this on.

pkucmus, 2021-04-25:
Deployed in 2.3.0: https://main.eva-3d.page/drives/lgx/

Closed 2021-04-25.

Thread 20 (2021-01-19):

[BUG] V6 higher than duct

cad405, 2021-01-19:
## Describe the bug
EVA 2.1.1 makes my V6 higher than the duct (either RHD and duct 2.1).

## Actual behavior
The nozzle is higher than the duct which makes impossible to print.

## Expected behavior
The nozzle should be lower than the duct.

## Pictures
In the picture attached you can see the nozzle and block is higher than the duct. On the duct 2.1 things get worse.
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

## Device
 - Printer: V-Cast
 - EVA version: 2.1.1
 - Mods: none (original E3D V6 and Bondtech BMG)

## Additional context
Changed from EVA 1.3.0 without changing V6 height or opening it. So it was a direct swap to 2.1.1.
Printed all parts from 2.1.1 stls in PETG and mounted all new parts. Removed 1.3 old parts.

cad405, 2021-01-23:
The problem was related with my actual print. Everything is sorted. Thanks.

Closed 2021-01-23.

Thread 21 (2021-01-25):

[EP] Support for 4020 extrusions.

simonjohansson, 2021-01-25:
## Problem description
I have a Sovol SV01 which comes with a 4020 extrusion for the X axis. The current design assumes a 2020 extrusion

## Describe the solution you'd like

Adapt the back and front plate for 4020 extrusions.

### Functional and non-functional requirements
- functional requirement
- functional requirement
- non-functional requirement

### Proposed solution

I just glanced over the CAD drawings and I think if the front and back plate would just extend 20mm at the top everything would work with a longer boden tube between the extruder and the hotend?

### Considered Alternatives
Put a 2020 extrusion on my printer, but I don't want to faff around with drilling and tapping holes :)

liner238, 2021-02-27:
Hello! , please raise this topic again. A similar problem. there is a 20x40 profile and I can't put EVA on it.
Because of the import curve in solidworks, I can't do it myself.

liner238, 2021-02-27:
while I'm waiting for the mod, I tried to do it myself. It turned out scary, but it should work. I will add it to print.

https://drive.google.com/file/d/1kOXiTMUfa8gKGMt0tax1G64r5P_7PTy_/view?usp=sharing

pkucmus, 2021-03-05:
EVA is a MGN 2020 based platform - a defined standard a printer needs to follow. So it's more about a printer working with EVA than EVA working with a printer. I understand the need but that will simply not be EVA but maybe a EVA-4020 fork.

I hope you'll understand.

Closed 2021-03-05.

Thread 22 (2021-01-28):

Volcano Bltouch

churd83, 2021-01-28:
Great job on this mod, but there is no mount for the BLtouch that accomodates the Volcano hotend.

pkucmus, 2021-03-05:
Noted, next time please use the issue template.

pkucmus, 2021-03-06:
Proposed fix

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
https://cad.onshape.com/documents/94cafeab52e3dfa0a28bae89/w/99794094315556b24b5664ec/e/d6374a1e5b14711360d3b164

Closed 2021-03-06.

Thread 23 (2021-02-09):

Looking for an older version of files

nesdnuma, 2021-02-09:
Hello,

I got pieces printer for a BMG-M + Mosquito configuration adapted to the pre-2.0 version. Now I am going to assemble it.  Can you tell me where the instructions for this version are?

pkucmus, 2021-02-09:
You can find the documentation for EVA 1.x.x here: https://pkucmus.github.io/EVA/

nesdnuma, 2021-02-09:
Thanks a lot!

Closed 2021-02-09.

Thread 24 (2021-02-19):

Bottom _mgn15.stl misaligned hole

DennisLex, 2021-02-19:
I noticed that the bottom_mgn15 has a misaligned hole. The middle one which is meant as a recess to fit the screw that is used to fasten the v6_support. Using the 8mm screw, it pushes against the bootom_mgn15, because the hole is too low.
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

Here is the bottom_mgn12 as a reference. It can be clearly seen that the middle hole is placed higher up the side.
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

Easy fix is to use a 6mm screw i.s.o. 8mm.
best fix would be to move the recess hole a bit up.

Closed 2021-03-06.

Thread 25 (2021-02-23):

[EP] bmg v6 short version and adjustable belt height.

codycato, 2021-02-23:
Great project,, Would love to see v6 bmg short version. No ptfe in-between and a adjustable belt holder to accommodate various belt height.

pkucmus, 2021-02-23:
Thanks.
This is unreachable in the nearest future.
The belt can be up to 10mm more will not fit on the plate.

Please use the issue template next time.

Thanks again.

Closed 2021-02-23.

Thread 26 (2021-02-23):

[EP] Mosquito-face: Shield heatblock from coldend-fan

top-gun, 2021-02-23:
## Problem description
On the Mosquito mount, I found that the heatblock runs into thermal issues with strong fans for the coldend. It is possible to overcome this by PWM-reducing the fan performance, but that's not possible with any mainboard, and it is bad for the fan. In fact, the fan is not the problem. It is a gap in the face-part that lets air escape freely downwards where it is not supposed to go.

## Describe the solution you'd like

Change the face-part so it shields the heatblock better from airflow.

Short summary of what you want to happen.

Close the gap at the bottom of the Mosquito-face

### Functional and non-functional requirements
nothing, this is just a minor change to an existing CAD-designed part

### Proposed solution

On the sides of the gap, there are surfaces on the mount that directly face each other. An extrusion on one of these surfaces that extends over the whole gap and reduces the down-facing air-stream considerably. With this modification, I was able to reach 265°C hotend temperature and to PID-tune at 260° without more thermal-runoffs.

### Considered Alternatives
None, I think this is the easiest solution.

### Additional context
There are also unecessary gaps on the support-part, but I can't close them well.
[Mosuito-face.zip](https://github.com/EVA-3D/eva-main/files/6031597/Mosuito-face.zip)

pkucmus, 2021-03-06:
I applied the fix @top-gun made to the face, did not apply the support part change:
https://cad.onshape.com/documents/1765b04fac582f6c1c470bd3/w/1cc31596374d6ce51cd23fa9/e/71691e38db5265f268854a02

Closed 2021-03-06.

Thread 27 (2021-03-01):

[EP] Improved Mosquito - Bondtech filament path and Mosquito nozzle visibiltiy

SmallGreenParrot, 2021-03-01:
## Problem description
The Mosquito - Bondtech scenario looks good.
But with (a) the extruder to hot-end filament path hidden, and (b) the heater / thermistor oriented to the front, early problem discovery is difficult.

## Describe the solution you'd like
(a) Exposing the filament path between the hot-end and extruder would allow hands-free inspection. It would also avoid an issue like having a missing PTFE tube.
(b) If the Mosquito was turned 180 degrees with the heater at the back,  it would make the nozzle more easily visible.
Doing that makes the fan shroud design more of a challenge but the end result would assist  in fault discovery.

### Functional and non-functional requirements
- visibility of the extruder to hot-end filament path.
- better visibility of the mosquito nozzle.
- careful repositioning of the fan air shroud path. to avoid heat issues.

### Proposed solution
I'm sure there will be some users who prefer to hide as many of the inner workings as possible.
One way to meet all requirements would be to have a snap-on front cover for cosmetic appearance, with the ability to leave that cover off permanently for those who prefer the naked solution.

### Considered Alternatives

### Additional context

pkucmus, 2021-03-05:
I'm not sure I'm following:
re a) what inspection are you thinking about here? what is the use case? missing PTFE tube - that part I completely don't understand, if it's missing it's an assembly error on the user, right?
re b) This is a "wont do" for 2 reasons - there is no space for that and the support part and I don't want that heat to be closed there

Please let me know if I got something wrong

SmallGreenParrot, 2021-03-05:
When everything is working fine, visibility into the filament path is
just for interest sake.

When there is a problem, that is where visibility and easy access become
important.

Not focusing on problems with the design,
I was trying provide a wish-list of features in an effort to contribute
to the creation process.

For example, the Micro Swiss line of extruders have excellent visibility
without touching anything.
https://store.micro-swiss.com/collections/extruders

I have had some recent frustration servicing a different 3D printer and
I thought you might appreciate some positive suggestions.
Having just ordered a kit from RatRig, I will soon face these issues.

My thought processes are just;
"If there was a problem with the filament somewhere, how would I go
about finding the problem and fixing it?"
"Is it possible to improve the design to assist in that?"

I have even thought further about how I might go changing the ho-end for
a different brand?
Would it have to include disassembly of the drive belt mechanism to do that?
The Prusa MK3 is like that. You have to take everything apart, making it
a really big job.

The many hours of work that have gone into the designs is obvious.
I hope my attempt at constructive contribution have not been taken
negatively.

Regards,
Noel

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

pkucmus, 2021-03-24:
Sorry, I missed your reply somehow. My English maybe failing me here as I'm still not sure if I'm following but we maybe slightly invading the "over-engineering" territory here - which by design principle I'm am strictly avoiding.
I am grateful for all feedback (sorry if I sounded mean).
Discord might be a better place for a quick discussion about this, would you care to reach me out there?

pkucmus, 2021-03-29:
Closing this one, but feel free to comment if need be

Closed 2021-03-29.

Thread 28 (2021-03-01):

[EP] Copperhead

pkucmus, 2021-03-01:
## Problem description

I'd like to add Copperhead to the list of supported hotends.

## Describe the solution you'd like

Copperhead needs to be a fully supported hotend in the standard

### Functional and non-functional requirements
- Needs to work with the universal face
- Tip of the nozzle needs to be in the same point in space relative to the carriage as V6/Mosquito/Dragon
- No groovemount
- Support 40mm hotend fan

### Proposed solution

Something along those lines:
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

### Considered Alternatives
N/A

### Additional context
I'm waiting for the delivery of one I got from donations (thanks).

pkucmus, 2021-03-27:
Open for testing: https://cad.onshape.com/documents/980a8bb4514542eeb90c5c21/w/fd1e2bf7da865e46d00cc945/e/c8b435b40390c0eb453f4c9e
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

pkucmus, 2021-04-25:
Deployed in 2.3.0: https://main.eva-3d.page/hotends/Copperhead/

benrr101, 2023-11-23:
It seems the copperhead was dropped in v3. Is that correct? Are there any plans to bring it back in a later release?

Closed 2021-04-25.

Thread 29 (2021-03-01):

[EP] Orbiter 1.5 (and 2.0?) support

pkucmus, 2021-03-01:
## Problem description
A few days after EVA / Orbiter was released The Orbiter 1.5 was released I need to figure out support for 1.0, 1.5 and possibly 2.0 is it gets here before I will be able to address this.

## Describe the solution you'd like

Make an additional variants of EVA / Orbiter for different Orbiter versions

### Functional and non-functional requirements
- Default v1 Orbiter support has to remain
- CR-10 v1 Orbiter support has to remain
- Orbiter v1.5 support is added
- Orbiter v2.0 support is added (if possible)

### Proposed solution

Not sure yet, but possibly it's just a different mounting screw alignment for 1.5 to fit on EVA

### Considered Alternatives
N/A

### Additional context
N/A

Oranginator, 2021-03-02:
Here you go, this is for Orbiter 1.5 standard. I simply hat to move the mounting holes a bit.
[Orbiter 15 mount.zip](https://github.com/EVA-3D/eva-main/files/6069406/Orbiter.15.mount.zip)

pkucmus, 2021-03-06:
Deprecating Orbiter 1.0 support, it will be available in git history (I'll link in the documentation).
Orbiter 1.5 support: https://cad.onshape.com/documents/bb8303124bc8370b6d1924bc/w/8276a22c579374e8b02e9b96/e/6b8206d26df549409bc1d1b2

pranas, 2021-07-17:
STLs are available in history but is there a way to get history from Onshape (the CAD file for particular piece)?

pranas, 2021-07-19:
It's here:  https://cad.onshape.com/documents/bb8303124bc8370b6d1924bc/v/aef34c7fede34b1b25331696/e/09d4e72250a20923ab87fce6

Closed 2021-03-06.

Thread 31 (2021-03-14):

[FR] Sherpa Mini support

msource, 2021-03-14:
## Problem description
Support on EVA2 for Sherpa Mini

## Describe the solution you'd like
Support on EVA2 for Sherpa Mini

### Additional context
https://github.com/Annex-Engineering/Sherpa_Mini-Extruder

pkucmus, 2021-03-21:
@msource do you have a supplier to recommend? Where can I get one?

msource, 2021-03-21:
Yes Sir:
https://a.aliexpress.com/_mqp85jV

lowtolerance, 2021-12-29:
Is it safe to say this issue can be closed now that EVA 2.4 has an official Sherpa Mini top?

Closed 2021-12-29.

Thread 32 (2021-03-20):

Nut clearance at join of "universal face" and "bottom_mgn12_short_duct"

pman92, 2021-03-20:
The captive nut hex shape at the bottom of "universal_face.stl" is too short for a M3 nut to be fully pulled in flush. It sticks out and prevents "bottom_mgn12_short_duct.stl" from mating properly. This nut is used to secure "v6_support.stl".

There is room in "bottom_mgn12_short_duct.stl" to provide a clearance hole so the bolt and nut could both protrude into them.

[image](https://imgur.com/a/jIgDy7Z)

silvalis, 2021-03-20:
As per the duct alignment issue, you've printer the incorrect bottom_mgn12_short_duct. The one in the orbiter fileset has a cutout to allow clearance for the nut and screw.

pkucmus, 2021-03-20:
There might be an issue with the stl directory in the root of the project, in the image bellow you'll find a preview of the proper file:
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
https://cad.onshape.com/documents/1765b04fac582f6c1c470bd3/w/1cc31596374d6ce51cd23fa9/e/bf748cd402ac505d88311d6e

pkucmus, 2021-03-20:
It was a filename issue it's fixed in: https://github.com/EVA-3D/eva-main/commit/0f7b9bcc789e196c75741722d1397ba23493656d
Thanks

Closed 2021-03-20.

Thread 33 (2021-03-20):

Part cooling fan duct alignment with hot end (MGN12, cartesian, dragon hotend)

pman92, 2021-03-20:
This may be an issue with me using the wrong stl's or not really an issue at all (I'm unsure).
I'm printing parts to build a cartesian printer using MGN12, an orbiter extruder and dragon hot-end. I'm still waiting on the hotend to arrive, but have noticed after printing that the output of the fan duct is sitting far forward of the center of the filament path.
I'm using "universal face" and "dragon_face" at the front, "back_cartesian" at the back, and "bottom_mgn12_short_duct" with "Duct V2.1 straight" at the bottom (as listed at https://main.eva-3d.page/drives/orbiter/)
It almost appears that without the spacer that is part of "bottom_mgn12_short_duct" pushing the duct further forward it would be in the right spot (IE. if "Duct V2.1 straight" was bolted directly to "back_cartesian")

[image 1](https://imgur.com/0tkUchp)

[image 2](https://imgur.com/undefined)

silvalis, 2021-03-20:
Looks like you've printed the wrong bottom_mgn12_short_duct. Maybe the one from the Aero or the Hemera fileset. Use the one in your orbiter link above.

pkucmus, 2021-03-20:
It was a filename issue it's fixed in: https://github.com/EVA-3D/eva-main/commit/0f7b9bcc789e196c75741722d1397ba23493656d

Please print https://github.com/EVA-3D/eva-main/blob/main/stls/bottom_mgn12_short_duct.stl

Thanks

Closed 2021-03-20.

Thread 35 (2021-03-23):

[EP] Compability with piezo orion probe.

weawer, 2021-03-23:
## Problem description
Start using the EVA system with an e3d v6 and an piezo orion sensor

## Describe the solution you'd like

For the EVA system to have a modified hotend holder and fan ducts to accommodate the extra size this sensor needs for the PCB and holder.

### Proposed solution

The module for the mounts builds about 19mm to the height and is 35mm wide. It is placed between the mount and the hotend.
This means that the fan ducts would need to be about 19mm lower and a bit longer. I believe the face assembly would be the biggest hurdle since it would have to both be elongated and modified to make room for the piezo mount and pcb/wires.

Step/stl files for pcb and mount for the piezo orion can be found here
https://www.thingiverse.com/thing:2841681/files

pkucmus, 2021-03-24:
This topic is returning from time to time. Sadly it's not something that I'm able or willing to do as it would require different set of parts for all hotends - not something I can maintain in the long run.
I also want to keep the tip of the nozzle in Z as a part of the spec - in short Piezo Orion does not fit EVA, but I'm open to discussion

weawer, 2021-03-24:
@pkucmus thanks for your quick response. i understand the issue. Thank you for the consideration.

pawlowskialex, 2021-06-17:
Sorry to resurrect an old thread, but I've been thinking about a similar thing, albeit with a different spin.
Instead trying to fit the whole Piezo Orion, we can take a small piezo transducer, and put it behind the hot end directly, something like this.

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
https://cad.onshape.com/documents/9b313e797dbfe82298fa97a9/w/bfab425eae9c42bf816e1e9c/e/a83baf260163688de249ca06

The extrusion I drew is way to small to host a real transducer, but there are 12 mm transducers out there which should fit.
We'd need to provide a small amount of flexibility for the transducer to register pressure, and this can be accomplished through a shallow counterbore on the hotend mount, where we will put a short spring.

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
https://cad.onshape.com/documents/9b313e797dbfe82298fa97a9/w/bfab425eae9c42bf816e1e9c/e/b189a406e6de5fcfe5c86762

Then, when we have mechanics sorted out, we can use the amazing [Pyro-Piezo](https://docs.pyroballpcbs.com/) PCB to drive the whole thing.

(Pardon my Onshape skills)

pkucmus, 2021-06-17:
@pawlowskialex this is one of the best issue comments I ever got, thank you for that.
I am struggling a little here as we put so much work into making the hotend as stiff as possible and then piezo options need some slack. Maybe someone needs to teach me more about it but right now I just don't like the whole piezo option. Additionally I'd like to learn what is the benefit - it's not a more accessible / easier option and the others - Bltouch and Inductive probes seem to be more than enough accurate.
Again awesome work preparing this, we need more comments like that but piezo is just not a fit here or someone needs to help me to stop being ignorant about it :)

pawlowskialex, 2021-06-17:
I can totally understand your hesitation and I’m not 100% convinced this is a good idea neither. It will indeed add some mechanical instability.
But, the reason I think this might be interesting is the potential benefit to non-planar printing it might bring. Having a BLTouch attached to your extruder really limits the range of safe motion and introduces a risk of your probe ramming into the print.
And to throw ideas out there, there are other potential mounting options for the piezo than the hotend: either side of the gantry, on the rail slide, or even under the bed (but it’s probably not the best option for V-Core 3)
But this really requires experimenting and mechanical expertise (which I don’t have yet)

pawlowskialex, 2021-06-18:
Another interesting solution that doesn't require introducing flex into the frame: https://github.com/KevinOConnor/klipper/issues/3741

Closed 2021-03-25.

Thread 36 (2021-03-25):

[EP] Wider cooling duct to stop warp on mosquito hotends

bionicmunky, 2021-03-25:
## Problem description
I find that the duct end is prone to warping with the mosquito as the heat block is wider compared to V6

## Describe the solution you'd like

A slightly wider gap between prongs to stop the duct warping with Mosquito

pkucmus, 2021-04-25:
Just deployed 2.3.0, please check out https://main.eva-3d.page/addons/fan-ducts/

Closed 2021-04-25.

Thread 37 (2021-03-28):

MGN15H

vozik, 2021-03-28:
The mgn15...stls are made for MGN15C not MGN15H. On "Features" you write "EVA can be mounted on MGN12C, MGN12H and MGN15H carriages."

pkucmus, 2021-03-29:
Yes, that is an error, thanks for pointing it out.

Closed 2021-03-29.

Thread 38 (2021-04-01):

[EP] Add Support For The HextrudORT Extruder

sirhavoc, 2021-04-01:
A nice and lightweight 215g all in one extruder and hot end combo.

https://github.com/MirageC79/HextrudORT

themacboy, 2021-04-11:
Interesting option ! Currently I doubt about orbital extruder, sherpa or HextrudORT.
That last turns more interesting if I can use on EVA ;)

pkucmus, 2021-04-11:
There is one already: https://www.youtube.com/watch?v=x7njfPCIbXY I asked him if he is willing to share his mod

simonvez, 2021-04-11:
a nicer video https://www.youtube.com/watch?v=6JBIEJan6zs&t=273s

I can share. Do you need MGN12 or MGN9 ?

pkucmus, 2021-04-11:
MGN12 please, I'll make the MGN15 out of that and we can make it an official thing

simonvez, 2021-04-11:
MGN15 is too heavy.... well MGN12 is too heavy as well lol... but here you go
https://1drv.ms/u/s!AkTq2jZffWF0gocHkFKHoZjcX35RRw?e=hdV0Km

pkucmus, 2022-07-05:
I thought it might go into 3.1 but it's more difficult than I expected. Need to take it down from 3.1.

Thread 39 (2021-04-02):

[EP]tension_slider tooth

vozik, 2021-04-02:
My steppers are in the front not in the back. This couses that the tension_slider tooth is on the wrong side.
teeth should be on the inner wall?

vozik, 2021-04-02:
Not common, but some printers have front steppers. For these, the inner tooth on the tensioner would be good. the front holds the other way too.

silvalis, 2021-04-03:
Do you flip your belts at the back?

vozik, 2021-04-03:
> Do you flip your belts at the back?

No. It is a good idea. I Will change the pulleys (Back pulleys are toothed) and flip the belts. Thanks.

Closed 2021-04-02.

Thread 40 (2021-04-05):

[EP]Eva2 Front for the new Phaetus DragonFly HIC HF hotend

cyborgcnc, 2021-04-05:
## Problem description
Phaetus has just introduced their new hotend, DragonFly HIC HF.  This seems to have a lot of promise, as it has the
heartbreak AND the Nozzle Bonded/Welded together!  This should basically eliminate the possibility of ANY leaks, and
improperly tightened nozzles in the 3d printing world.  It is a high flow device, which when combined with a .6 or .8 nozzle, should really make a coreXY push a lot of plastic (needs to be proven)  More information can be found here:

https://www.phaetus.com/?page_id=1482

I would like EVA2 if possible to support this HotEnd via a "front"

## Describe the solution you'd like

An EVA front end, that would be able to accept this hotend.  I guess all the other options for extruders, should remain the same.
This should also be a nice fit for the new BMG LGX, and should also pair nicely with an orbiter.

themacboy, 2021-04-11:
Dragonfly BMO in not compatible with Dragon socket?

pkucmus, 2021-04-11:
In theory this should work either without the groove mount with the dragon face since the hole spacing is the same:
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

or with the V6 face and the groove mount, I don't have this hotend so someone would need to test it

themacboy, 2021-04-13:
Confirmed, they are compatible with dragon

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

themacboy, 2021-04-18:
Oh sorry I confuser Phaetus Dragon Fly HIC HF with the BMO.

Im sorry, miss understood!

Phaetus Dragon Fly HIC HF is other format:

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

3DPrintBeginner, 2021-06-29:
There's a STEP file available for the HIC on [Thingiverse](https://discord.com/channels/582187371529764864/758622323162218496/852110074775732224)

themacboy, 2021-07-01:
I have desing the HIC version. I f you need it please contact me in Discord for betatesting.

pkucmus, 2021-08-28:
Was this ever completed? I can only see the BMS contrib: https://contrib.eva-3d.page/hotends/DragonFly_BMS/

cyborgcnc, 2021-08-28:
Hi Pawel,

Not sure, I was not the one building it or modeling it...

thanks,

Spiro

On Sat, Aug 28, 2021 at 11:33 AM Paweł Kucmus ***@***.***>
wrote:

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

themacboy, 2021-08-28:
Please check my last PR:

https://github.com/EVA-3D/contrib-extras/pull/28

Thread 41 (2021-04-11):

[EP] mgn9 support

EduardoOliveira, 2021-04-11:
## Problem description
Lowering the weight even more with mgn9 on the x rail

## Describe the solution you'd like

The possibility to use mgn9 out of the box

### Functional and non-functional requirements
- mgn9 (h?) compatible holes
- printable shims to make for the height difference

### Proposed solution

Increase the slot size if possible to accommodate mgn9 and possible shim height difference

### Additional context
I know its a its some work, but I'm just kicking the idea out there, some us have been drooling over "that other awesome project" that is fast as hell and uses EVA. I don't mind making another version of the XY joinners for mgn9 and possible carbon fiber base axis

arne182, 2021-07-26:
I will be going to do this. The MGN9 H is a must as the C is too narrow in my opinion for the distributed weight of the extruder. I am also looking into the CF tube:
https://hobbyking.com/en_us/carbon-fibre-square-tube-20-x-20-x-800mm.html
Shims are not a bad idea for the start but I am planning on reprinting all the parts in PA-CF to get them more temperature resistant.

Closed 2021-09-04.

Thread 42 (2021-04-24):

Incorrect files ..

themacboy, 2021-04-24:
In the "stl.zip" the file "bottom_mgn12_short_duct.stl" looks like a incorrect version.

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

Download linl:
https://github.com/EVA-3D/eva-main/raw/2.2.1/stls.zip

File preview:
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

But must be:
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

Im correct? Thx in advance ! Great project !

pkucmus, 2021-04-25:
I'm about to deploy 2.3.0 today, wrote a lot of code that should do all this automagically so I hope those mistakes will not happen again (taking human error out of the equation)

pkucmus, 2021-04-25:
Deployed, please let me know if something if not right

Closed 2021-04-25.

Thread 43 (2021-04-26):

Cartesian and Idex blower [EP]

themacboy, 2021-04-26:
First of all, I'm sorry to post it here, but the Cartesian repository looks close to post issues.

I noticed than cartesian and idex design use the 5015 blower, and it is too large to fit in my Ender 5 Plus, and probalbly others.

I like to know if is possible to get a blower 4020 version. (never used onshapes, currently learning FreeCad)

Or if it is compatible to use the coreXY version.

Thx in advance ! Great work, soon I will post my pictures.

pkucmus, 2021-04-26:
I'll look for a guy who put EVA on an Ender 5 to he if he can help

pkucmus, 2021-04-26:
Also this is a perfect place for those "EPs" :)

vellkan, 2021-04-26:
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

Hi :)
You've got problem with back plate fan, correct? On repository is slim version for 5015 fan, but event with that You need to move endstop.
I've got this in Ender 5 Pro, I just move endstop a little and now everything is fine. I can provide You some photos if You want.

themacboy, 2021-04-26:
Yes, sure. And a lot of Thx

El lun., 26 abr. 2021 12:40, Igor Chudy ***@***.***> escribió:

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

themacboy, 2021-04-26:
Where is the slim version?

El lun., 26 abr. 2021 12:55, themacboy ***@***.***> escribió:

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

vellkan, 2021-04-26:
As I understand You've got this problem, yes?
This is version with slim back plate, but still can hit to this metal parts. I just moved Y endstop to the front.
Yes, I lost about 2cmm of bed in Y axis, but can live with that :)

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

themacboy, 2021-04-26:
+1

vellkan, 2021-04-26:
I found it on Discord channel, but I will upload it on OneDrive:
https://1drv.ms/u/s!AglN16Zy9Yb1pmkzyMej11izTrnm?e=GsXgku

themacboy, 2021-04-26:
Lot of Thx

El lun., 26 abr. 2021 20:37, Igor Chudy ***@***.***> escribió:

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

pkucmus, 2021-08-28:
I'll assume this one is closed

Closed 2021-08-28.

Thread 45 (2021-05-09):

[BUG] Wrong CAD link to Catesian support

flow23, 2021-05-09:
## Describe the bug
Go to https://main.eva-3d.page/addons/cartesian_idex/ and click on CAD

## Actual behavior
Opens CAD drawing of x endstops

## Expected behavior
Opens CAD of Cartesian support

## Pictures
X

## Device
X

## Additional context
X

pkucmus, 2021-05-09:
Thank you! It's fixed (will get deployed in around 10 minutes)

Closed 2021-05-09.

Thread 46 (2021-05-11):

[BUG] Belt indentation inside cartesian back

flow23, 2021-05-11:
## Describe the bug
Belt indentation inside cartesian back.

## Actual behavior
Belt indentation inside cartesian back.

## Expected behavior
No belt indentation inside cartesion back because the belt is secured by two belt blocks in the back.

## Pictures
https://cad.onshape.com/documents/a2d21b0faa4745fa21bc844e/w/d7f14dfeeee2e68fe2f1149b/e/fcd1503d3995b7b7473cc831

## Device
X

## Additional context
X

pkucmus, 2021-05-15:
I am sorry but I will require this ticket to be more descriptive as I have no idea what this is supposed to achieve

flow23, 2021-05-16:
I was wondering if this feature is really needed for cartesian printers? I thought that the belts are tentioned by the two blocks in the back. Maybe I misunderstood the CAD drawing.
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

EduardoOliveira, 2021-05-16:
In any configuration each belt has a tip that goes into a tensioning block and another tip that is held statically to the carriage.
In CoreXY systems one of the tips is held by the block in the back and the other tip is held in the front.
In Carterian systems the static tip is held by that groove and the other tip by the block

Having 2 tensioner blocks in a single belt would be redundant at best

Did I make it clearer? If you have any doubt you can  reach out on discord

flow23, 2021-05-16:
Understood.

Closed 2021-05-16.

Thread 47 (2021-05-21):

[BUG] Website - top_endstop_plug_mgn12.stl missing in 2.3.0

Mitsuma, 2021-05-21:
## Describe the bug
I was looking at the X Endstop section https://main.eva-3d.page/addons/x_endstop/ and noticed that the link for the file is giving a 404: https://main.eva-3d.page/stls/top_endstop_plug_mgn12.stl

It appears that it is missing from the 2.3.0 branch as it is not in the https://github.com/EVA-3D/eva-main/tree/main/stls folder.
Not sure if this is intended but seeing the others are still there, including the bigger MGN15 version I think this is an oversight.

You can still find it in the older 2.2.1 branch: https://github.com/EVA-3D/eva-main/blob/2.2.1/stls/top_endstop_plug_mgn12.stl
(Not sure if that part was changed from 2.2.1 to 2.3.0

pkucmus, 2021-12-29:
solved in 2.4.0

Closed 2021-12-29.

Thread 48 (2021-05-26):

[EP] Sapphire Pro compatible mount

yfaykya, 2021-05-26:
## Problem description
I printed the Orbiter mount but no matter the orientation I lose quite a lot of Y distance due to colliding with the frame.

## Describe the solution you'd like

Not sure if possible/easy but perhaps something that can slide over the top carriage.

https://photos.app.goo.gl/uEgFbnfYc6Z9rKTy5

themacboy, 2021-05-26:
Hello ! Im currently near to mount it too.

I few days ago I have modfied CoreXY to fit on a Sapphire Plus, but not sure if it is usefull in the Pro version.

As soon as posible I will test my mod and report result.

themacboy, 2021-05-26:
This is the mod for the Sapphire Plus:

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

As you can see this probably will hit with the rods on the sapphire pro.

But I will try using a 4020 blower or other.

Any idea is welocme

yfaykya, 2021-05-26:
If there is anything I can test please let me know! Appreciate this a lot!

themacboy, 2021-05-26:
how many Y are youcurrently losing ?

yfaykya, 2021-05-26:
50 mm or so.

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

yfaykya, 2021-06-05:
Can you share what you have and I can try some modifications? Thanks!

themacboy, 2021-06-05:
Currently there is a contributor that has worked on a 4020 fan version for the sapphire. Im currently waiting for him to share the files in the contrib version.

About my work it is not usefull due the belt position in the Sapphire Plus, and still not tried in my sapphire Pro. Im moving to another home, very busy month

themacboy, 2021-06-05:
>
>
> Can you share what you have and I can try some modifications? Thanks!

btw, you can use the public OnShape soucer design to make any mod. They are very usefull.

https://cad.onshape.com/documents/1765b04fac582f6c1c470bd3/w/1cc31596374d6ce51cd23fa9/e/e2fc56d355d28a162332ce38

yfaykya, 2021-06-05:
thanks!

pkucmus, 2021-06-06:
Not fully compatible with EVA 2, but there are still EVA 1 backs available - which had a 30deg back
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

Maybe you can go from there: https://cad.onshape.com/documents/1cea28d26150bba34a3d6614/w/fd185c58d38d06bda7ec83a6/e/5385243b86e5aae8a3a0e66d

themacboy, 2021-06-06:
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

YEs I was thinking on a similar option, but probably will hit with de back frame belts.

A will try to work in a totally horizintal option. But currently Im noving to other home, and Im full busy. Sorry

themacboy, 2021-06-09:
> @themacboy did you already fit EVA on Sapphire Plus? I'm interested in doing that as well. I saw the [back mod for cartesian](https://main.eva-3d.page/addons/cartesian_idex/) printers which has the blower a lot lower and I hope it could clear below the frame but I didn't take any measurements yet. I would also have to redo belt paths and I wonder maybe you already have that part figured out?

I also tried it on Sapphire plus, and had the same problem, using the Cartesian, with 5015 or 4020, it played with the belt and still forgives a lot of range on the Y axis.

This is from another user (from Discord) with nick XP-ERIMENT, here is the problem:

! [image0] (https://user-images.githubusercontent.com/8063711/121410399-d441eb80-c962-11eb-8c97-5625c1fb116d.jpg)

It looks like he finally modified the seat belt and is working well with it, but he hasn’t shared it in the STL and the images yet to see the modification on the belts.

I will soon try to work with a flat version of the fan. Although I’m not sure if it’s possible to do that.

pranas, 2021-06-10:
Thanks for sharing. I think there's another problem that the stock Sapphire Plus hot end carriage is mounted backwards: filament path in the back. If you mount EVA like it was intended at Y=0 the nozzle would be way too far in the front and out of the bed area. Maybe we should mount EVA backwards as well, that way the cartesian blower would have a lot more space because there is more space in the front due to XY motor placement there. It would not look great but would probably be a better way functionally.

yfaykya, 2021-06-30:
I have not had a chance to check in here for a bit,. Are there any model I can test? Would love to help out.

themacboy, 2021-08-28:
I just tested EVA 2.3 on Sapphire Pro and the bed has been reduced to 220x170 mm and the height is increased to 265 mm

yfaykya, 2021-09-03:
@themacboy Which model did you use?

themacboy, 2021-09-06:
corexy with a few personal modifications in the back plate to better align of belts

Thread 49 (2021-06-01):

[FR]

riox87, 2021-06-01:
**Problem description**
The motionsystem on my CoreXY has its belt postions on the opposite: on the front the belt is on the bottom left and top right.

**Describe the solution you'd like**
If possible, a version of back_corexy and universal_face with inverted beltmount postitions.

EduardoOliveira, 2021-06-01:
Hi, have you checked the contrib page (https://contrib.eva-3d.page) ? Maybe there is some adaptation that could solve your problem

riox87, 2021-06-01:
Hello.
Yes i checked it but unfortunately there is no solution for my problem.
Thank your for the quick response.

riox87, 2021-06-01:
I checked it again, you where right.
blv-mgn-cube-back_corexy.stl is what i was looking for.
Thanks a lot!

Closed 2021-06-01.

Thread 50 (2021-06-06):

[EP] Berd Air cooling support

G4Cab, 2021-06-06:
## Describe the solution you'd like
Mounts for cooling with the Berd Air cooling "eco-system"

pkucmus, 2021-06-06:
Hello, please use the issue template when issuing feature requests

Closed 2021-08-28.

Thread 51 (2021-06-07):

[BUG] CoreXY back missing sacrificial layer

jerejones, 2021-06-07:
## Describe the bug
The hole used to secure the fan on the CoreXY back is missing a sacrificial layer.

## Actual behavior
The print ends up very ugly inside that hole when it tries to print without supports

## Expected behavior
I would expect a sacrificial layer so that the slicer will bridge cleanly

pkucmus, 2021-08-28:
Thanks this is fixed in the [CAD](https://cad.onshape.com/documents/1765b04fac582f6c1c470bd3/w/1cc31596374d6ce51cd23fa9/e/570a5d066d5942fa3f78b745) already. Will get deployed with 2.4.0

Closed 2021-08-28.

Thread 52 (2021-07-04):

[EP] Volcano support

Kowy54, 2021-07-04:
Problem description
Part cooling and bltouch support for E3D Volcano hotend.

Closed 2021-07-04.

Thread 53 (2021-07-09):

[EP]V6 Threaded Heatsink Variant

LucienWells, 2021-07-09:
## Problem description
The addition of a variant of the E3D V6 hotend mount that allows for use of the V6 threaded heatsink.

## Describe the solution you'd like

Addition of an alternative EVA2.x hotend mount to allow for the use of the V6 threaded heatsink, rather than the standard V6 groove-mount.

### Proposed solution

- E3D sells a [threaded heatsink](https://e3d-online.com/collections/upgrades-v6/products/v6-threaded-heatsink) upgrade for the V6 hotend, which does away with the groove-mount.
- I believe [this is the associated E3D technical drawing](https://e3d-online.dozuki.com/Document/PqLiSCu1HbKSCBxy/V6-175-SINK-SCREW.pdf).
- Popular makers of V6 clones have also made [threaded V6 variants available](https://www.aliexpress.com/item/32889029983.html), including with a locking nut.

### Considered Alternatives

- One option would be to make the locking mechanism part of the EVA mount, such that the threaded V6 screws into the EVA mount itself.
- An alternative would be to incorporate a seperate locking nut per the original Voron Mini Afterburner released with the Voron v0 (and still available with the v0.1 for Bowden style setups).
- Relevant CAD files, including for the threaded V6, are [available from the Voron GitHub](https://github.com/VoronDesign/Voron-0/tree/Voron0.0/VORON-0/CAD).

### Additional context

I appreciate this is probably a low priority given the preponderance of groove-mount vs threaded mount V6s, but the threaded mount is superior in many ways and it would be nice to see this incorporated within the EVA ecosystem.

pkucmus, 2021-07-09:
This is one of the best made ticket here so far, thank you!
Sadly, you are right about the priority aspect the reason for that is that I'm currently working on V-minion. Another thing is that it's the most hard to achieve / design mount there is so it will require a lot of work and testing. Additionally there's the fact that V6 is the worse hotend of the supported bunch I'm not sure we want to invest much into it.

TL;DR
I'm not saying no, but it will not happen soon and when the time comes we'll see if there's still the need for this.

Closed 2021-09-04.

Thread 54 (2021-07-11):

[BUG] Sensorless endstop file link leads to 404

Hajto, 2021-07-11:
## Describe the bug
404 when trying to download sensorless endsto
https://main.eva-3d.page/stls/top_endstop_plug_mgn12.stl

## Actual behavior
404

## Expected behavior
Download the file

## Pictures
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

nfruge56, 2021-07-15:
For anyone looking for the file, until the link is fixed, they can go to the 2.2 branch and download the top_endstop_plug_mgn12 file from the STLs folder.

pkucmus, 2021-12-29:
solved in 2.4.0

Closed 2021-12-29.

Thread 55 (2021-08-01):

[EP] Make cooling options machine independent

forerunnert, 2021-08-01:
## Problem description

I think EVA is a fantastic idea and I plan to fit it onto my BLV MGN cube in the near future.
Ideally it would include a Volcano hotend and a dual 5015 blower too.

All these options exist as community contributions but they cannot be used together as the fan mounting points and part of the duct is integrated into the back plate.

## Describe the solution you'd like

I'd like to see the cooling (fan mount and duct) removed from the back plate and replaced by an interface.
This way the cooling options are not restrained anymore and can be mixed and matched with different back plates for different machines.

### Functional and non-functional requirements
- universal fan interface on backplate
- universal fan duct interface on back plate

### Proposed solution

[https://postimg.cc/hX5wfGxr](url)

### Considered Alternatives
I could take the step files of the relevant parts and make a 'for BLV' version and contribute that.
This would however create additional versions of identical parts while the whole EVA project is an opportunity to avoid just this situation:

    - 'EVA conversion kit for BLV MGN Cube' => 'EVA conversion kit for BLV MGN Cube and Volcano and dual 5015'
    - 'Horns Duct v2 variant for E3D Volcano' => 'Horns Duct v2 variant for E3D Volcano for BLV'
    - 'SuperSniffles' Dual 5015 Part Fan Mod' => 'SuperSniffles' Dual 5015 Part Fan Mod for BLV'

pkucmus, 2021-08-28:
This is interesting. Not sure yet how to approach this and it will take time but I'll think about it more. For now making a forked back part is the way to go.

Closed 2021-10-04.

Thread 56 (2021-08-08):

[EP] Annex Quickdraw Support

Kirinkunhime, 2021-08-08:
## Problem description
Support for the Annex Engineering Quickdraw (Magprobe) as an ABL solution on the EVA2

## Describe the solution you'd like
A mount on the EVA2 toolhead that allows the toolhead to pick up the Probe from the Dock (which has to be designed per printer and as such is not part of this EP) & safely retain it (see [PL08N replacement option](https://github.com/Annex-Engineering/Quickdraw_Probe/tree/main/STLs/PL08N_Drop-in_Replacement)) before dropping off at the dock again.

### Additional context
https://github.com/Annex-Engineering/Quickdraw_Probe

Thread 57 (2021-08-09):

[EP] Support for the Carabiner Toolboard

Kirinkunhime, 2021-08-09:
## Problem description
Wiring the toolhead is very annoying. As such a simple and lightweight toolboard makes wiring and replacing components (e.g. heater, fans) much easier. The

### Proposed solution
Support on EVA2 for the Carabiner toolboard.

### Considered Alternatives
While the Duet2 toolboard is an option, I personally do not like having screw-terminals to retain a higher voltage wire on a moving part of the printer.
In addition the Carabiner retains the controlling side of the electronics inside the electronics box and does not have any components inside the printer, which in an enclosed printer (which can reach 50°C chamber temperature) is an additional advantage.

### Additional context
https://github.com/Annex-Engineering/Annex_Engineering_PCBs/tree/master/carabiner-toolboard

Kirinkunhime, 2021-08-09:
Side Note: There are no vendors carrying the Carabiner, it's a completely DIY PCB. If you want one to test, please poke me in Discord ( iKirin#0001 ) and I can provide you one 👍

alecwarren, 2021-08-12:
> Side Note: There are no vendors carrying the Carabiner, it's a completely DIY PCB. If you want one to test, please poke me in Discord ( iKirin#1 ) and I can provide you one 👍

I like the design and size of that toolboard. Too bad it only has a 4 pin probe port.

Kirinkunhime, 2021-08-16:
Thank you!

I might be doing a revision that will have 5 pins for the probe-port with the 5th port being connected to one of the other 4 - basically allowing you to drop in a BLTouch without any major hassle.

Kirinkunhime, 2021-09-15:
This ping is to indicate further interest in a mount for the EVA2.

wzzx, 2022-03-30:
Would love to see this coming to EVA. It simplifies toolhead wiring significantly.

Thread 58 (2021-08-17):

[EP] Change hole shape to make nut insertion into printed pieces easier

nesdnuma, 2021-08-17:
## Problem description
Insertion of nuts in printed pieces (especially small M3 nuts) can be a real pain, especially if there's not a flat surface around the hole. Sometimes one has to push very hard to put the nut in place. Moreover, when the holes are deeper than the nut height, it's hard to know when to stop pushing with the risk of breaking a printed part.

## Describe the solution you'd like

Make the holes in such a way that the insertion of the nuts are easier.

### Proposed solution

Change the shape of the holes. Only make the hole tight at the very end where the nut is supposed to stay. Otherwise make the upper part of the hole broader. Here are three different design profiles (#2 is my favourite).

Profile 1:

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

Profile 2:

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

Profile 3:

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

nesdnuma, 2021-08-28:
No one's reading? :-(

EduardoOliveira, 2021-08-28:
Hi, have you tried pulling the nut into place by inserting a screw into the hole and thightening it into place?
That's what I usually do with a screw that's only the dept of the hole plus 3 or 4mm to grab the nut, after the nut is pulled into place i remove the screw and proceed with he assembly.

I know your suggestions simplifies the process but adds some work and provable collisions there the nut holes are close to other features.

pkucmus, 2021-08-28:
Thanks for the EP.
I honestly don't see the need for this, moreover, this is flawed as prone to alignment errors. One should not fit the nuts and after that thread the screws - we had a lot of issues with nut binding in the early days.
The proper way to seat a nut is with by ["backpulling"](https://main.eva-3d.page/printing/#handling-hex-nuts) this ensures that a nut will be driven into the socket on the angle the screw will want the nut to be.

nesdnuma, 2021-08-29:
For deep holes I still think it would be really useful and would not create alignment issues as the bottom of the hole is tight.  I have re-discovered backpulling on my side while building a V-Core Pro but the page you've linked to should be included in each Ratrig assembly documentation @pkucmus !

pkucmus, 2021-08-29:
It is on the one manual I made: https://ratrig.dozuki.com/Guide/00.+Preparations/78?lang=en#s477
as for the rest, sure just let Rat Rig know :)

Closed 2021-10-05.

Thread 59 (2021-08-25):

[BUG] E3DV6 not aligning with Titan extruder.

Keltbear, 2021-08-25:
## Describe the bug
A clear and concise description of what the bug is.

## Actual behavior
The hole on the thing does not match the hole on the other thing as I can't screw the two things together

## Expected behavior
I need the part to meet the other part but since the holes are not aligned I can't achieve that

## Pictures
[Photo](https://scontent.fsac1-1.fna.fbcdn.net/v/t39.30808-6/239427676_10225900459993710_8838118387369210191_n.jpg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)

## Device
 - Printer: [e.g. V-core ]
 - EVA version: [e.g. 2.1.0]
 - Mods:
   - Easy Mod 1.2.1

## Additional context
Add any other context about the problem here.

pkucmus, 2021-08-25:
Sorry, I can't figure out that "thing" which does not help me to figure out the problem not to mention a solution.
Please edit the description and fill out what is being asked from the issue template.

EduardoOliveira, 2021-08-25:
@pkucmus I tagged you in a FB post that seems to be related to this issue

pkucmus, 2021-08-28:
This was resolved, the issue was a bad Titan Clone

Closed 2021-08-28.

Thread 61 (2021-08-28):

[EP]

paulokinho, 2021-08-28:
## Problem description
Support Biqu H2 Direct Drive Extruder as it's a very capable and lightweight extruder.

## Describe the solution you'd like

Biqu H2 it is very similar to Hemera extruder, so probably it's possible to the change the Hemera Front and Probe to fit it.

### Functional and non-functional requirements
- Front must match Biqu H2 holes
- Front must dimensions must match Biqu H2 dimensions
- Probe adapter must match Biqu H2 holes
- Probe adapter must  match Biqu H2 dimensions

### Proposed solution

Change Hemera front and probe adapter to match Biqu H2 holes and dimensions:
- Holes coordinates: 15mm between holes located at X 36.6mm, Y 8.9mm
- Dimensions: 35mm x 61.6mm x 35mm

https://3dwork.io/en/biqu-h2-extruder-review/

pkucmus, 2021-08-28:
This one I am going to reject. Compact extruders are not a good fit for EVA (or CoreXY printers in general) in the future I would rather separate those out do different projects and release those on a different release cycle.
Maybe someone will like to pick that up as a contrib for now but it will not make it into official EVA.

paulokinho, 2021-08-28:
Ok, I see, just for curiosity, why a compact extruder is not a good fit for CoreXY printers?

EduardoOliveira, 2021-08-28:
They are usually wider than the other setups loosing X area, and since they are compact they are mounted in the from of the carriage as the other setups the motor sits on top of the carriage producing a more stable center of gravity

dlysi, 2021-09-20:
It;s a shame since Biqu H2 is only 61x35x35mm and 219g vs the Hemera which is 77x44x44 and 388g.

Thread 62 (2021-10-09):

[EP] top LGX MGN15 should have bolt back stops for screwing into the carriage (the mgn12 variant has them)

tafypz, 2021-10-09:
top_lgx_mgn15_b.stl does not have any bolt backstop, this means that the bolt head is not sitting on anything for this part.
Could you please add the backstops ?
For reference top_lgx_mgn12_b.stl has the backstops for bolting to the carriage.

Closed 2021-11-15.

Thread 64 (2021-11-10):

[EP] Missing Volcano version Hemera Duct v2.1 Angled 13.2deg.stl

inikolovski, 2021-11-10:
## Problem description

No STL for the Volcano Duct angled on Hemera present

## Describe the solution you'd like

I'd like to be able to use my Volcano hotend with the Hemera extruder.

### Functional and non-functional requirements

The volcano duct stl I've found are the straight version and the 20 deg angled version.
- Volcano on Hemera needs a 13.2deg angled duct like the V6 but lower.

### Proposed solution

Create a Volcano_Duct_v2.1_Angled_13.2deg.stl

Closed 2021-12-17.

Thread 65 (2021-12-16):

[Bug]: Dragon Hotend CAD Link has incorrect OnShape Link

LordNed, 2021-12-16:
### Discord username

Matt "@LordNed" Hoffman#3445

### What happened?

If you try to use the "CAD" link at the bottom of the Dragon Hotend page (https://main.eva-3d.page/hotends/dragon/) it tries to take you to https://cad.onshape.com/documents/1765b04fac582f6c1c470bd3/w/1cc31596374d6ce51cd23fa9/e/f85b6fffa3072e3e42bb94c9 for the Onshape document. However when loading that page, you get an error message that says "Can't open tab. The tab does not exist in this document workspace." and then the cad model shown is a blower.

### EVA Version

2.3.0

### Which printer are you using?

V-Core 3

### Terms

- [X] I did seek help on Discord and found none or was instructed that this is indeed an EVA bug.

pkucmus, 2021-12-29:
solved in 2.4.0

Closed 2021-12-29.

Thread 66 (2021-12-21):

[FR] PL-08n2 probe mount

dweight, 2021-12-21:
## Problem description
Right now there is no PL-08n2 (or similar) mount. It would be nice to have such an option.

### Functional and non-functional requirements
- mount should be very rigid
- bottom face of the probe should be flush with bottom of the heater block (at max)

### Additional context
[Probe schematics](https://drive.google.com/file/d/1gjvI52IZaFnLe3kfE6lyJJ4xNgP4oZ6O/view?usp=sharingl)

Closed 2022-01-27.

Thread 67 (2021-12-27):

[Bug]: Eva 2.4.0 mounting holes for belt

Jegstrup, 2021-12-27:
### Discord username

Noobie4ever

### What happened?

hi

when trying to mount belt on a sapphire plus the belt slider need to bee invertet otherwise the belt will be twistes any solution for this ?

### EVA Version

2.4.0

### Which printer are you using?

Other

### Terms

- [X] I did seek help on Discord and found none or was instructed that this is indeed an EVA bug.

Jegstrup, 2021-12-27:
i did manage to solve it kind off :D it will work if i turn toolhead 180 degrees but prefer to have it like i should be

pkucmus, 2022-01-02:
So you just need tensioner blocks that would have the teeth on the other side?

Jegstrup, 2022-01-03:
Exactly. 😊

søn. d. 2. jan. 2022 22.25 skrev Paweł Kucmus ***@***.***>:

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

psusong, 2022-02-04:
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
only yes no no i searched all the stl

psusong, 2022-02-04:
Only tension_slider_9mm_belt_M5.stl
no opposite

pkucmus, 2022-05-21:
I'm closing this one as EVA 3 is here and I can't take on printer compatibility work, best to ask on Discord, a bunch of people there will be able to make adjustments

Closed 2022-05-21.

Thread 68 (2021-12-27):

[Bug]:  BMO Mounting Screws

zx4017555, 2021-12-27:
### Discord username

bobble#9830

### What happened?

The Mounting Face([bmo_face](https://main.eva-3d.page/hotends/bmo/)) BOM says it requires M3X8 Screws for mounting
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

However, in reality, it requires [M2.5X8](https://www.phaetus.com/dragonfly-bmo/) instead of M3X8 screws for mounting as per the documentation
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

A user suggested that the mounting bolts are included in the BOM, but the dragon has the M2.5X8 screws listed and it would be nice to have all of the necessary hardware listed. Second, the [CAD model](https://cad.onshape.com/documents/51ec5a95e190d928dabcea10/w/94576604d1279f8314466d44/e/02d805ddbc6466248e0837f4) shows only 2 out of the 6 Screws listed on the BOM, thus I'm supposing that the other 4 M3X8 screws are for mounting since you cant get 7mm screws.

Bcus of this, I bought the wrong mounting hardware and have to wait another week for new screws to arrive 😅 , wanted to suggest this to avoid future users from buying the wrong hardware

### EVA Version

2.3.0

### Which printer are you using?

Other

### Terms

- [X] I did seek help on Discord and found none or was instructed that this is indeed an EVA bug.

pkucmus, 2021-12-27:
The M3 x 8mm screws are for probe mounting, I had M2.5 screws in the BMO box - that's why those are not in the EVA BOM.
Please tell me if that is not the case for you.

zx4017555, 2021-12-27:
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
Then thats on my part, but from what I can tell, the Dragon has those 4 M2.5X8 on the bom, however, my BMO didn't come with the M2.5 Screws, from what I saw it should be included, Ill go ask for an replacement, thanks for the quick response!

pkucmus, 2021-12-27:
I need to check how Dragon ships nowadays, thanks!

Closed 2021-12-27.

Thread 69 (2021-12-29):

[Bug]: incorrect PTFE tube length for LGX + V6 combo

blalor, 2021-12-29:
### Discord username

yolo-dubstep#8033

### What happened?

Combined PTFE tube length (46.9mm) of LGX drive ([13.8mm](https://main.eva-3d.page/drives/lgx/#bill-of-materials)) and V6 hotend ([33.1mm](https://main.eva-3d.page/hotends/v6/#bill-of-materials)) appears to be too short.  When assembling my extruder I found that ~55mm is closer to correct, with the tube passing through the LGX coupler to make contact with the body, and fully inserted into the V6 heatsink until it stops.

### EVA Version

2.4.1

### Which printer are you using?

V-Core 3

### Terms

- [X] I did seek help on Discord and found none or was instructed that this is indeed an EVA bug.

blalor, 2021-12-29:
cut per spec:
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

what I'm using:
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

pkucmus, 2022-01-02:
Thanks, fixed in 2.4.2, the model for LGX did not assume us shoving the PTFE so deep, I measured my LGX and made changes to the model I hope it'll be correct now.

Closed 2022-01-02.

Thread 70 (2021-12-31):

[Bug]: Duct for LGX is different than the others

blalor, 2021-12-31:
### Discord username

yolo-dubstep#8033

### What happened?

Screenshots below from PrusaSlicer. The one highlighted in green is `TriHorn Duct.stl` from the [LGX drive page](https://main.eva-3d.page/drives/lgx/#bill-of-materials). The other two from the top are `TriHorn Duct Default.stl` and `TriHorn Duct Wide Low.stl`.

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

The widest LGX-sourced duct interferes with the Euclid probe, which is how I discovered the problem. The existence of the LGX-sourced duct is not an issue (some may find it useful?) but it being different from the others without commentary or being included with the others in the layer cooling section _is_ an issue.

### EVA Version

2.4.1

### Which printer are you using?

V-Core 3

pkucmus, 2022-01-02:
Thanks, fixed in 2.4.2

Closed 2022-01-02.

Thread 71 (2022-01-02):

[EP] EVA 2.4 -> Missing MGN15 support

guiguijke, 2022-01-02:
## Problem description
Hello , I'm a VCAST owner and would like to migrate to your 2.4 version . However, I'm not able to do so because there is no MGN15 support for BMG mount.

## Describe the solution you'd like
Can you please continue to support such rail ?

### Functional and non-functional requirements & proposed solution
- top_bmg_mgn12 -> top_bmg_mgn15
- bottom_mgn12_short_duct -> bottom_mgn15_short_duct

pkucmus, 2022-01-02:
I am unable to consume the amount of work that is required to support both. But I have two solutions for you:
1. Wait for the V-Cast 1.5 update
2. Use the 2.3 version of the BMG mount you can find the `top` and `bottom` files here, those will be compatible with the new `universal_front` and the new `back` [2.3.0 BMG files are here](https://github.com/EVA-3D/eva-bmg/tree/c984e1e64691c87fa68022beefe8df9648ca6bdb/stls)

Closed 2022-01-02.

Thread 73 (2022-01-10):

Make EVA more modular[EP]

ManuelPeiro, 2022-01-10:
## Problem description
I am assembling the Ratrig v3 printer, and I have reached the point of mounting Eva, in fact I have already done so, my selection has been Bondtech Bmg GENUINE, with a pancake stepper and Mosquito clone.... And I am waiting Orbiter extruder. The problem I see is that when I get the new extruder or if I want another, I have to disassemble almost all EVA to be able to change it, losing the tension of the s
Belts, among other things ... However, if you switch from Hotend, it would be much easier

## Describe the solution you'd like
I propose do, top_bmg_mgn12, the part
Short summary of what you want to happen.

### Functional and non-functional requirements
- functional requirement
- functional requirement
- non-functional requirement

### Proposed solution
The piece where Eva begins to be assembled, and which is the function of the extruder, divide it into 2. A piece with which Eva begins to be assembled, and that can be attached to (universal face or back corexy) and a second piece that holds the extruder and stepper motor

Later, if can, I add some hand drawings

### Considered Alternatives
A clear and concise description of any alternative solutions or features you've considered.

### Additional context

The advantages, I think would be quite a lot, among which I see:
- if you change extruder you do not have to disassemble Eva.
- You can adjust the Endstops easier.
- You have a jam it would be easier to disassemble the extruder.

 I have to clarify that this platform, should be able to disassemble, with some screws, of that initial piece proposed

ManuelPeiro, 2022-01-10:
i have made hand drawing
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
s

pkucmus, 2022-01-10:
Thank you for this. I actually have thought about this but have a different approach where the top will be static and common for all drives. It's something I'd like to implement in the future version for sure.

ManuelPeiro, 2022-01-10:
If you need beta testers, count on me

Closed 2022-02-16.

Thread 74 (2022-03-02):

[EP] Orbiter V2.0 extruder in Eva 2.3.0?

ManuelPeiro, 2022-03-02:
## Problem description

Hi,

When I ordered the printer (RRv3), I ordered it with the printed parts for the Orbiter 1.5 extruder, but since they had just released it, I ordered LDO for Aliexpress, the Orbiter 2.0 extruder...

 Well, someone can tell me, if possible, by making some manual modification, to mount the Orbiter 2.0 Extruder, on the parts of the E. V. A, for the Orbiter 1.5 extruder (which are the ones I have).

It would not be forever, the first impression would be the pieces of the E. V. A for Orbiter 2.0

## Describe the solution you'd like

Short summary of what you want to happen.

### Functional and non-functional requirements
- functional requirement
- functional requirement
- non-functional requirement

### Proposed solution

Detailed information about the solution. Any ideas, diagrams, drawings (even by hand), links are welcome.

### Considered Alternatives
A clear and concise description of any alternative solutions or features you've considered.

### Additional context
Add any other context about the feature request here.

Thread 75 (2022-03-23):

[Bug]: TriHorn Duct Safe.stl is a 1KB file

weust1979, 2022-03-23:
### Discord username

weust#0214

### What happened?

Checking out the STL files for the ducts and noticed "TriHorn Duct Safe.stl" is a 1KB file.
Bad upload perhaps, somehow?

Location: stls\addons\layer_cooling\stls

### EVA Version

2.4.0

### Which printer are you using?

_No response_

### Terms

- [X] I did seek help on Discord and found none or was instructed that this is indeed an EVA bug.

pkucmus, 2022-05-21:
Killing this as it's EVA 2.4

Closed 2022-05-21.

Thread 76 (2022-04-09):

[EP] Updated the Ender 5 Rear Plate to fit new size Tri Horn Ducts

Anon0ne, 2022-04-09:
## Problem description
Currently the Ender 5 backplate modification for cartesian style printer is the wrong size port for the Tri Horn Duct, I have started working on a new replacement for latest models, but having issues.

## Describe the solution you'd like

Updated flat back plate to save room on an Ender 5, which doesn't need belt tensioning or any channels for belt path.

### Functional and non-functional requirements
Just a fan and to fit the new ducts.

### Proposed solution

Updated flat back plate to save room on an Ender 5, which doesn't need belt tensioning or any channels for belt path.

### Considered Alternatives

Place the new style duct from back plate onto the existing ender 5 flat plate.

themacboy, 2022-04-13:
Not sure about your problem, check my PR.

Thast my mod used in ender 5 plus

https://github.com/EVA-3D/contrib-extras/pull/47

pkucmus, 2022-05-21:
Closing as:
- printer compatibility is not something I can take on
- EVA 2.4

Closed 2022-05-21.

Thread 77 (2022-05-09):

Was support for the Dragon hotend removed?

atomicwrites, 2022-05-09:
I remember seeing the dragon in the list of hotends before, but it's gone now sometimes, or sometimes it's listed in the sidebar but the link 404s. I do see it in the v2.4.2 branch though. was this intentional?

EduardoOliveira, 2022-05-09:
Hi, official support was removed in version 3, in version 2.4 you should still be able to download directly from CAD

intelinc, 2022-05-11:
Bump. Just looking for this on 3.0.

rjorgenson, 2022-05-11:
This was mentioned in the announcement stream, they will not be supporting the Dragon hotend.

atomicwrites, 2022-05-11:
Not sure what's going on because I can't see it on the web UI, but I got this reply in an email:

> Hi, official support was removed in version 3, in version 2.4 you should still be able to download directly from CAD

rjorgenson, 2022-05-11:
> Not sure what's going on because I can't see it on the web UI, but I got this reply in an email:
>
> > Hi, official support was removed in version 3, in version 2.4 you should still be able to download directly from CAD

The 2.4 version is here in the git repo https://github.com/EVA-3D/eva-main/tree/release/2.4.2/stls/hotends/dragon under the 2.4.2 release.

proap, 2022-05-12:
would the BMO mount work if we screw the BMO collar for the Dragon hotend?

pkucmus, 2022-05-20:
> Not sure what's going on because I can't see it on the web UI, but I got this reply in an email:
>
> > Hi, official support was removed in version 3, in version 2.4 you should still be able to download directly from CAD

Who did you e-mail? EVA is just me and I did not wrote that :|

pkucmus, 2022-05-20:
The answer is here: https://main.eva-3d.page/FAQ/#dragon-support-clones-in-general
I'll close this issue now :)

Closed 2022-05-20.

Thread 79 (2022-05-09):

CAD Conflict

MicRood, 2022-05-09:
The [Chonky Shroud](https://cad.onshape.com/documents/cb8bd513b980b411d50cd513/w/6e64f1ba8609c44902ccf372/e/8d0157f74965ce8e585dfb2d) Interferes with the [BL Touch](https://cad.onshape.com/documents/cb8bd513b980b411d50cd513/w/6e64f1ba8609c44902ccf372/e/dbf188e21e46a24ca801cc78) majorly and with the [Hex Nut CoreXY Core](https://cad.onshape.com/documents/cb8bd513b980b411d50cd513/w/6e64f1ba8609c44902ccf372/e/2f4214235ff3476304094ba7) slightly in EVA 3.0
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

pkucmus, 2022-07-01:
BL-Touch will get it's own shroud if there's enough interest, for now it's not something I can fix

Closed 2022-07-01.

Thread 80 (2022-05-11):

EVA 3 - BMG vs Cable management Conflict

bubujoe, 2022-05-11:
BMG stepper motor is in conflict with the main cable management

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

pkucmus, 2022-05-21:
There is an alternative cable mount for it, I forgot to document it

pkucmus, 2022-07-09:
Fixed in 3.0.2

david-antos, 2022-08-17:
The "fat" cable guide mount doesn't actually fix that completely: the BMG motor is about 2 mm too deep and conflicts even with the cable guide *mount*, not only with the cable guide ("the basket"). So something like, e.g. https://www.printables.com/model/203244-eva-3-modified-cable-guide-for-bmg-extruder is necessary (this solution works for 5015 fans, but conflicts with 4028, though).

olivbd, 2022-08-18:
> The "fat" cable guide mount doesn't actually fix that completely: the BMG motor is about 2 mm too deep and conflicts even with the cable guide _mount_, not only with the cable guide ("the basket"). So something like, e.g. https://www.printables.com/model/203244-eva-3-modified-cable-guide-for-bmg-extruder is necessary (this solution works for 5015 fans, but conflicts with 4028, though).

I've the same issue with 4028 fan... You can check my work here: https://www.printables.com/model/261446-eva-3-modified-cable-guide-for-bmg-extruder-with-4

Closed 2022-07-09.

Thread 81 (2022-05-11):

EVA 3 - The 8mm inductive probe is in collision with the Shroud

bubujoe, 2022-05-11:
EVA 3 - The 8mm inductive probe is in collision with the Shroud

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

Thread 82 (2022-05-17):

EVA3.0-rc1 5051 fan ducts are slightly too tight

mikejwaters, 2022-05-17:
With a little grinding, I can fit my Winsinn fans, but my Delta fans won't line up. I think an extra 0.5 mm in the vertical direction (of these photos will make them fit easily.
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

mikejwaters, 2022-05-23:
Update: I shaved off more plastic and jammed the delta fans in place.

pkucmus, 2022-06-12:
Fixed in 3.0

Closed 2022-06-12.

Thread 83 (2022-05-17):

Bl-touch mount

duniu9, 2022-05-17:
The Bl-touch mount is too thick and collides with the sensor. There is 8mm space for the bl-touch, the mount is 9.5mm thick.
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

duniu9, 2022-05-17:
Another problem is the sensor collision with the shroud
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

mikejwaters, 2022-05-18:
I also had the same problem. I shaved away the excess after printing to put the BLtouch on it's mount.

pkucmus, 2022-05-21:
The shroud compatibility is something I'll think about more, will likely produce many different shrouds.
As for the mount, please test this: https://cad.onshape.com/documents/cb8bd513b980b411d50cd513/w/6f7fd7828c4d7cb1c0c853da/e/dbf188e21e46a24ca801cc78

mpx1986, 2022-05-21:
the next Problem ist the fan shroud

mbiedak, 2022-05-24:
New version is correct in height, but I am unable to fit it with cables attached. You can see that on the picture above

mbiedak, 2022-05-25:
@duniu9 can you share with me your updated file?

duniu9, 2022-05-26:
> @duniu9 can you share with me your updated file?

[Bl-touch fix.zip](https://github.com/EVA-3D/eva-main/files/8777071/Bl-touch.fix.zip)

pkucmus, 2022-05-26:
BL-Touch is tricky as it has many versions and revisions, some say it works for some it does not, can you post real life pictures here for me to better understand what is going on?

sladewexo, 2022-05-30:
Though the bl-touch fitted for me, it was sitting to low on my V-Core 3 500.  I altered @pkucmus design a bit to move it higher up.  For those interested, I've included the STL and STEP file here
[bltouch.zip](https://github.com/EVA-3D/eva-main/files/8796484/bltouch.zip)
.

mikejwaters, 2022-06-01:
> BL-Touch is tricky as it has many versions and revisions, some say it works for some it does not, can you post real life pictures here for me to better understand what is going on?

@pkucmus I know it's inelegant, but would having a printable shim help with BL-Touch compatibility? Just a thought.

pkucmus, 2022-06-12:
I made a bunch of improvements to the BL-Touch mount, please tell me how it works, EVA 3.0 was just released: https://main.eva-3d.page/heat_insert/probes/bl_touch/

b33k-WA, 2022-06-13:
I really struggled to get the nuts into the recesses, perhaps a little more tollerance, I ended up having to print the piece 3x because of bending the thin arm when trying to pull the nut into place and another when it spun.  I ended up printing at a high infill and setting the nut like a brass insert (sorry I know you hate those).  Once I got it on the machine I encountered issues with not having any adjustment available and felt it was too close to run.

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
![IMG_1334](https://user-images.githubusercontent.com
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
/95461285/173274287-9dac702b-dccb-49d5-bbc8-492a2a12534c.jpeg)

Closed 2022-06-12.

Thread 84 (2022-05-18):

LGX mount interferes with the bottom of the LGX

mikejwaters, 2022-05-18:
Hi again,

The LGX has two protruding ovals that don't let it sit flat on the current LGX bracket. Here's a picture:
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

Bondtech provides .STEP files at the bottom of their product page which should help with fixing the issue: https://www.bondtech.se/product/lgx-large-gears-extruder/

MidnightLink, 2022-05-18:
You're using the wrong interface. You want to use the one that has the bowden adaptor on it and remove the adaptor

mikejwaters, 2022-05-19:
Yeap, the Bowden adapter fits perfectly. My mistake. Issue closed.

Closed 2022-05-19.

Thread 85 (2022-05-25):

Request. E3d Revo Voron mount

midicdj1000, 2022-05-25:
Hi, Will an EVA 3 mount for the E3d Revo Voron be in the future  ? It's not the same as the BMO.
https://e3d-online.com/blogs/news/revo-voron-available-now
I am just printing a BMO set at the moment in PC CF and it looks fantastic

midicdj1000, 2022-05-25:
HI, I just saw that I can download the step file so I can edit in 123design my normal cad software. if I make my own parts for my diy printer what should I do so others can use ? I just made the top part with limit switch to fit my mgn12H part instead of the mgn12c for example.

pkucmus, 2022-05-30:
I just purchased a Revo Voron with donation money, I'll make the mount for it soon

midicdj1000, 2022-05-30:
Thanks, I am almost finished with this EVA3 for a dragonfly. I printed in Prsament PC CF and Esun silver PETG
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

pkucmus, 2022-06-12:
Released: https://main.eva-3d.page/heat_insert/hotend/revo_voron/

midicdj1000, 2022-06-13:
Thank you. What is the link to send you a small donation ?

Closed 2022-06-12.

Thread 86 (2022-06-13):

EVA 3 Orbiter 1.5 hits the cable Guide.

b33k-WA, 2022-06-13:
The cable guide cage hits the back end of my orbiter 1.5, if the cable guide bottom mounting hole was 40mm higher it would clear the top of the the motor or if it were rotated to mount face backwards rather than sideways.

pkucmus, 2022-07-01:
CAD-wise it seems ok, it is too close to be immune to real-life errors but there is a question of how big of an issue it is. I'm going to mark it as won't fix but please feel free to let me know here if it's a deal breaked issue.
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

Closed 2022-07-01.

Thread 87 (2022-06-14):

[EP] EVA 3 E3D Revo V6 Support

githubcura35, 2022-06-14:
EVA 3 now supports the E3D Revo Voron. Are there any plans to support the E3D Revo Six? (https://e3d-online.com/products/revo-six) Any plans to support V6 based hotends at all?

pkucmus, 2022-07-01:
This would also mean support for V6, right? Not sure about the timing but something I'd like to address

huzargarden, 2022-08-27:
Definitely, something that I'll be looking for. I like the EVA design and I'm very happy with my V6 Hot End.

a937983423, 2022-09-21:
I would like to ask why the most popular E3D_ V6 does not support

fj-guy, 2022-10-13:
The old e3d v6 served me well for quite awhile.  Since the Revo 6 was a direct drop-in replacement I switched to that. And I would imaginge a lot of V6 users did the same.  Not all of us care to print at 300mm/s with crazy accel values.  I recently upgraded to the V-CORE-3.1 but had retained the older 2.4 carriage because I didn't want to upgrade to a HF hotend just yet.  Luckily someone did a V6 mount for EVA 3.  Do your survey on REVO 6 users instead of V6 users.

MechanizedMedic, 2022-10-25:
I just got done drawing up a [to-spec remix](https://cad.onshape.com/documents/aa6b87b04c53d0436ebc5b95/w/52b723d56fd8bb8eb734a789/e/abb8bc791c22639c7a986955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) that is compatible with Volcano/V6 (if push fitting is removed). It should allow the Volcano and v6 to use the same hotend block with the standard cooling duct.

I also made a cable mount for the BMG extruder but it is only compatible with the single 50mm blower for now.

Feedback and collaboration are welcome! :)

githubcura35, 2022-10-25:
@MechanizedMedic Thanks a lot. I am unable to export to STL. Can you grand permissions in Onshape?

MechanizedMedic, 2022-10-25:
@githubcura35, yep sorry about that. Should be good now.

githubcura35, 2022-10-27:
@MechanizedMedic Thanks a lot. I will check it out but feedback will take some time.

githubcura35, 2022-10-31:
@MechanizedMedic The V6 fits perfectly but I am having some trouble with the cooling. The duct from the default bottom reaches lower than the tip of the nozzle
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

githubcura35, 2022-11-01:
@MechanizedMedic There is no way to move "hotend_volcano" further down as the zip tie holder collides with the "universal_front".
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

MechanizedMedic, 2022-11-02:
Okay, thanks for testing. I'll fix it up later this evening and repost.

olivbd, 2022-11-02:
Why not use this Printables model? https://www.printables.com/model/201093-eva-30-e3dv6-revo-revo-micro-hotends-mount

I printed and used it for several months without any problem...

MechanizedMedic, 2022-11-02:
@githubcura35, I updated the design this morning to move the hotend down 7.5mm. This should put the v6 in the correct spot for the standard duct. The Volcano hotend will now need the Volcano duct.

TekuSP, 2023-06-30:
> Why not use this Printables model? https://www.printables.com/model/201093-eva-30-e3dv6-revo-revo-micro-hotends-mount
>
> I printed and used it for several months without any problem...

That is REVO V6 and not V6 standard

Thread 88 (2022-06-15):

EVA 3 - Single 5015 - Not enough clearance

samsonnguyen, 2022-06-15:
EVA3 with a single 5015 cooling fan

The width between the stems of the single 5015 inlet is measuring exactly 15mm from the onshape files.
Unfortunately, measuring a Sunon 5015 maglev fan, the width of the fan casing is 15.15mm +/- 0.1mm. Hence it is not possible to slide the fan into the inlet without significant strain or modifications like sanding the stems manually.

Additionally, due to printing tolerances and slight warping when printing in ASA. The width of my printed part varies between 14.9mm to 15.2mm. I printed this part vertically as shown in the "How to print" documentation.

Overall, it would be great to have more clearance to accomodate:
* Slightly oversized fan casings
* Printing tolerances
* Plastic warping during print (especially if using ABS or ASA)

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

pkucmus, 2022-07-01:
This was fixed in 3.0.1

Closed 2022-07-01.

Thread 89 (2022-06-15):

EVA2 - BLtouch mount for short hotends

jbjhjm, 2022-06-15:
about a week ago there was a discussion in RatRig community because someones BLtouch tip was destroyed several times when a print failed and produced some mess.
I just upgraded my EVA to a Dragon HF and realized it is really short. Even with the BLtouch screwed all the way to it's mount, the retracted tip will be pretty much on one level with the nozzle, so pretty much exposed and vulnerable to damage.

I created a simple remix of the EVA (2.4) BLtouch socket which will allow the probe to be mounted 5mm higher so that it is mounted in relative safety. The Zip contains STEP and STL files. Don't know if you still want to add things to EVA 2.4 or if you focus 100% on EVA3 now. Anyways, here it is. As always, big thanks for the amazing work you do!

[BL-Touch Mount DragonHF.zip](https://github.com/EVA-3D/eva-main/files/8908403/BL-Touch.Mount.DragonHF.zip)

pkucmus, 2022-07-01:
Thank you, you can file it to contrib. EVA 2 is archived now.

Closed 2022-07-01.

Thread 90 (2022-06-24):

Orbiter + Mosquito = Gap!

Tylersuard, 2022-06-24:
Currently the EVA combo for Orbiter and Mosquito introduces a gap where the filament is just hanging in the breeze for about 15 mm.  The Orbiter is specially designed to constrain flexible filament so it has nowhere to go.  Adding a gap below it completely defeats the purpose!

it would be nice if we could get a version with a dorect connection from the orbiter to the mosquito.

Yako000, 2022-06-24:
You are suppposed to add a piece of bowden tube between the extruder and the hotend. It should tell you how long it needs to be in the list of required hardware.

pkucmus, 2022-07-01:
Yeah, I think @Yako000 nailed what might be wrong here.
Please see https://main.eva-3d.page/getting_started/#ptfe-lenghts and:
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

Closed 2022-07-01.

Thread 91 (2022-06-28):

eva 3.0.1 bltouch mount for mosquito magnum hotend

daveke0201, 2022-06-28:
the bl touch mount is to low for the mosquito hotend. retracted probe and nozzle are at the same height
[BL-touch v4.zip](https://github.com/EVA-3D/eva-main/files/8999091/BL-touch.v4.zip)
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
.

pkucmus, 2022-07-01:
Please check https://cad.onshape.com/documents/cb8bd513b980b411d50cd513/w/6e64f1ba8609c44902ccf372/e/5887f86caa14d2846bbaf4f9
It should be fixed now

daveke0201, 2022-07-04:
check

pkucmus, 2022-07-05:
I made another iteration that moves the BL-Touch mount away from the nozzle (thus allowing shroud space) and a volcano variant. Both can be exported from here: https://cad.onshape.com/documents/cb8bd513b980b411d50cd513/w/6e64f1ba8609c44902ccf372/e/e226e1499a99fe1c8452b17d

pkucmus, 2022-07-09:
Fixed in 3.0.2

Closed 2022-07-09.

Thread 92 (2022-07-01):

Add more space for the top mount zip ties

pkucmus, 2022-07-01:
With some drive mounts it's tight and thicker zip ties simply do not fit, this ticket is to address that.

Example from Mitsuma:
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

pkucmus, 2022-07-01:
Fix: https://cad.onshape.com/documents/cb8bd513b980b411d50cd513/w/6e64f1ba8609c44902ccf372/e/5b925785aeadeceec03b658f
Before we had space for 1.5mm thick zip tie, now it's 2.0mm

Thread 93 (2022-07-02):

EVA3 - BLTouch `horizontal_move_z can't be less than probe's z_offset`

DrMullings, 2022-07-02:
When using the EVA3.0 or EVA 3.01 version of the BL Touch Holder I have Z offsets from 14 to 16 and therefore neither Z Tilt, nor the heightmap calibration works without adapting horizontal_move_z (default are 5 and 12) in the printer.cfg
This adaption only seems to be a workaround, as it was not necessary in EVA 2.4

joaobarros, 2022-07-02:
This looks like an issue to be open in RATOS, not here

DrMullings, 2022-07-02:
> This looks like an issue to be open in RATOS, not here

This was introduced by switching from EVA 2.4 to 3.0
That is the reason why I opened the bug here and not in RatOS

pkucmus, 2022-07-05:
#91 should fix this or it's indeed something for RatOS to address.
@miklschmidt is this anything you can help with?

pkucmus, 2022-07-07:
I'm closing this as not EVA related. If you need further help I suggest Discord :)

Closed 2022-07-07.

Thread 94 (2022-07-07):

Dragon UFH support

pkucmus, 2022-07-07:
There's the new Dragon UHF hotend that has screws instead of tubes between the heat block and the radiator cage.
This ticket is to add EVA support for it. Need to remember to document the difference between UHF and UHFm and that the "volcano" (Rapido UHF) ducts work.

pkucmus, 2022-07-07:
Took the official Phateus model and fixed it up a bit: [onshape](https://cad.onshape.com/documents/26459cb5644fa29b6c39cab8/w/baa2c853cc475d4744198189/e/7041854cfafaeb688136d13b)
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

pkucmus, 2022-07-07:
And here are the tastable parts: https://cad.onshape.com/documents/cb8bd513b980b411d50cd513/w/6e64f1ba8609c44902ccf372/e/40a0f896c01ef6c441d83662

pkucmus, 2022-08-08:
For the UFH variant the volcano ducts should be used, the 8mm probe mount should be able to grab the probe even if lowered by 8mm (tell me if that's not true).

pkucmus, 2022-08-08:
Additionally, you can try this approach: https://cad.onshape.com/documents/cb8bd513b980b411d50cd513/w/5ab9cded4098d1052df4fbf4/e/04a1727e01ef430de292dd1c
Dragon UHF is extremely close to the plastic in EVA 3.0 - it's too close in my opinion the link above is a branch link to test a change in the universal face and the bottom parts (only standard duct) to check if more room will make things less melty
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

Thread 95 (2022-07-13):

No E3D Titan support on EVA 3.

Rai-Oliveira, 2022-07-13:
Previous versions of EVA supported the Titan extruder, however this version doesn't seem to. Is there a reason for it?

pkucmus, 2022-07-16:
Yes a couple of them there were close to no interest in it. As I need to prioritize Titan lost.

Closed 2022-07-16.

Thread 96 (2022-07-15):

ADXL345 Mount Holes Too Large

JingleheimerSE, 2022-07-15:
The ADXL345 mount holes are currently designed for 3mm hardware but the Adafruit ADXL345 board only has 2.5mm mounting holes.

Although I love the idea of keeping the hardware BOM simple, perhaps the design could err toward the smaller diameter hardware to enable a larger range of boards?

Alternatively, I will likely use the 3mm hole to insert a 2.5mm heat set insert. Perhaps this could be noted in the current Core BOM?

JingleheimerSE, 2022-07-18:
Closing as I now see the Adafruit board was not the designed for part.

Closed 2022-07-18.

Thread 97 (2022-07-18):

Improvement: Move heat set inserts to Cable Guide from Cable Guide Mount

JingleheimerSE, 2022-07-18:
One design change that could improve usability would be to move the heat set inserts out of the Cable Guide Mount and into the Cable Guide. In other words, reverse the direction of the screws through those parts. That would allow disconnecting the Cable Guide from the rest of the system while its still zip tied to the cable bundle. Currently, to separate the system, the cable ties need to be cut.

Thread 98 (2022-07-22):

Document how to mount the hotends to the hotend parts

pkucmus, 2022-07-22:
CAD does not contain screws for mounting the hotends to their parts, as this is on purpose - not to have those in the BOM, as the included hotend screws are to be used - it's misleading.

Document that!

Thread 99 (2022-07-25):

LGX Lite mounting screws are too short

pkucmus, 2022-07-25:
The LGX lite mount CAD and BOM talk about 6mm screws to mount the extruder. That does not work, change the BOM to use 8mm screws there.

Thread 101 (2022-08-02):

Biqu H2 extruder/hotend

Twistedsocal, 2022-08-02:
Any chance of getting support for the biqu H2? I just got the H2o which is water cooled and really want to be able to use it with this setup. Thanks. I'm happy to Paypal for the effort.

pkucmus, 2022-08-03:
Nope sorry, my stance did not change since this comment: https://github.com/EVA-3D/eva-main/issues/61#issuecomment-907641956

pkucmus, 2022-09-30:
For context, EVA had Hemera (I'll compare H2 to Hemera here as the reasoning is the same for both) up to I think 2.3 or some version like that, people did not care for it more many reasons (3.1% of the users were on Hemera). The same story was with the Aero.

We called them compact or "front heavy" extruders. With the "normal" setup you always have the motor (heaviest part) on top and very close to the MGN carriage. Where those compact extruders have their center of mass shifted to the front where the weight can sag the whole assembly. They also stole print volume, so the math is:

+ whatever there is that is good about those (I honestly do not see the appeal)
? a shorter filament path, but that was proven to have no or negligible impact on everything
- close to no interest from the community
- tons of extra work
(and cons that are more universal in terms of CoreXY)
- need more space in the front of the carriage (i.e. for EVA compatibility the printer would need to reserve much more XY space for EVA)
- the center of gravity is further away from the anchor point (MGN carriage)
- probes always had to be in weird places

Additionally about the weight gain: H2 is 219g, the rather huge LGX is 218.6g, LGX Lite is 48g add a typical hotend ~ 41g (Mosquito) - unless H2 has more push force (which I have no data for but I seriously doubt that) I see no reason to use H2 on any printer (if money is no issue).

If you'd want to discuss this further we could take it to Discord, comments here are not the best for this kind of discussion.

dlysi, 2022-09-30:
@pkucmus Now with H2 V2S Lite and and Hs V2S revo i believe you should rethink this.
H2 V2S Lite is 175g with 45mm3/s flow volume
and
H2V2S Revo is 198g

https://biqu.equipment/collections/h2-series-extruder/products/h2-v2s-lite
https://biqu.equipment/collections/h2-series-extruder/products/biqu-h2-v2s-revo-extruder

pkucmus, 2022-09-30:
@dlysi still does not compare to a LGX Lite and any hotend able to push that much filament, but even if it would compare it only addresses one argument. Not sure what there is to rethink.

If I had the time to add support for it it would be a standalone EVA Compatible-ish project that would live outside of EVA's release cycle - it would probably involve a special front and bottom. Maybe someone would like to pick that up? I have high-demand hotend support lined up and I'm super late on that.

dlysi, 2022-09-30:
@pkucmus i agree with this... "it would be a standalone EVA Compatible-ish project that would live outside of EVA's release cycle"

Twistedsocal, 2022-09-30:
Ok, thanks for the clarification. To be clear, the H2 is not the hemera,
not anything like the hemera, the hemera is larger, heavier and less
capable across the board, the H2 which I got because of the ability to turn
retraction settings down to 0.2mm and to do so rapidly means no artifacts
in the print. The ability to reach 500c in the same setup so long as you
were to swap the heartbreak out for the titanium version which I have and
the extremely short filament path great for flexible filament. Plus a one
stop shop plug it in turn it on and run it type of deal and now they have
improved it even more. Idk just wanted to fill you in, still thanks for the
info, too bad you are missing out on this pretty capable awesome product.

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

Closed 2022-08-03.

Thread 102 (2022-08-03):

V6 hotend for EVA3

ZeyHex, 2022-08-03:
E3D V6 is the most common platform at the moment, which is still a relevant and productive solution, and I find it strange that V6 heatsink support was removed from EVA 3. I suggest returning it. To do this, I, in the image and likeness of the original solutions, modeled a technological bed for the V6. Model attached there: https://github.com/ZeyHex/eva3_hotend_v6

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

I ask you not to condemn the applied solution for fixing the radiator in the glass bed immediately with a bayonet. The radiator is mounted in it once and no longer requires disassembly. If you choose the right distance between the holes, the screws firmly and securely fix it both from falling out and from turning. And besides this, the rigidity and protection against inertia of the structure is given by the emphasis of the walls of the radiator in the body of the bed from the inside.

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

You can take the model that I attached as a basis and modify it if something is wrong in it.

pkucmus, 2022-08-03:
Hi, thanks. This is a duplicate of #87 closing - V6 support will happen in that ticket.
I would like to address the "most common platform" bit. According to the EVA survey taken more than a year ago, V6 had 11.5% of the usage I can only imagine that number being lower now.
I don't understand the second part with the glass bed and bayonet, can you explain? I also don't have Fusion360 so I can't open the attached file.

ZeyHex, 2022-08-03:
added step
https://github.com/ZeyHex/eva3_hotend_v6/blob/main/EVA3%20v6%20hotend.step

elcojacobs, 2022-08-04:
https://www.printables.com/model/201093-eva-30-e3dv6-revo-revo-micro-hotends-mount/files

This one works well already.

Closed 2022-08-03.

Thread 103 (2022-08-08):

[FR] Sherpa Mini/Micro mount

Karol01pl, 2022-08-08:
Please add support lightweight and good extruder.
https://github.com/Annex-Engineering/Sherpa_Micro-Extruder
https://github.com/Annex-Engineering/Sherpa_Mini-Extruder

emersonsc, 2022-09-11:
I second this.

Thread 104 (2022-08-12):

Explicit file naming to differentiate insert and hex nut part variants

intelinc, 2022-08-12:
I'm about done with building/installing a 3.0 carriage on one of my printers. I usually prefer heated inserts, but I find that some of the current parts are more robust using hex-nuts. So I've printed a number of parts in both versions. This means that I have multiple identically named files that are actually different parts. It would be helpful to differentiate between the two fastener variants in the file names, just to make clear which version of the part it is for users that are experimenting with both.

One option would be to use the existing filename to apply to the heat insert versions, with a '_hex' appended to the nut insert versions.
`bl_touch_mount.stl` vs `bl_touch_mount_hex.stl`

intelinc, 2022-08-12:
Just realized this is already implemented with the 'fi', but I just didn't catch it due some duplicate files.

Closed 2022-08-12.

Thread 105 (2022-09-11):

"Safe" Cooling Duct Link for 2.4.2 bad

emersonsc, 2022-09-11:
The link for the "safe" cooling duct stl downloads a 1kb file. Would like the be able to download it especially for those of us still using the 2.4.2 design since its not compatible with our printers and/or extruders.

Closed 2022-09-11.

Thread 106 (2022-09-11):

Zero G Mercury 1.1 Support

emersonsc, 2022-09-11:
Hoping you're able to officially add the Zero G Mercury 1.1 support like it had *unofficially* support on the 2.4.2 platform. Love the 3.0 look and design

pkucmus, 2022-09-21:
This comes back from time to time. The gist of the compatibility is that it's the printer that needs to be compatible with EVA - not the other way around. Having designed EVA, V-Core3, V-Minion and Easy-Mod for V-Core Pro I can vouch that it's not that hard to achieve.

The reasoning behind that is that EVA already needs to adhere to all the standards, like hotends and drives shapes and sizes, different cooling, etc if I was ever to aim at printer compatibility it would a maintenance nightmare. Something has to give so the compatibility needs to go this way:
```
All the hotneds <--- EVA <--- Printers
All the drives  <---
All the cooling <---
...
```
This also makes sense as it's the printer that will benefit of integrating with EVA as the interface, Eva does not gain much from being compatible with more printers, it gains on being compatible with more hotends, etc. The printer gains as if it's EVA compatible it's automatically compatible with all that EVA brings.

That is my stance at least, I hope it makes sense.

Closed 2022-09-21.

Thread 107 (2022-10-03):

Cartesian Back Belt Slant

JoviousTreeWolf, 2022-10-03:
Hi!
I assume that cartesian version of EVA3 back is supposed to be used with GT2 20T pulleys, MGN12 rail and 2020 extrusion.
In that case there will be slight belt slant.
Because belt anchor point is further from beam center than it needs to be.

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

JoviousTreeWolf, 2022-10-05:
Ok, just found out that slant was caused because i was using 16t pulley on motor. Sorry for disturbance.

Thread 108 (2022-10-25):

Inferoir cooling for mosquito throat radiator

AlexTOOT, 2022-10-25:
Hi, I'm using EVA3 on a corexy machine with mosquito.

The back of mosquit is almost closed by the extruded aluminum chassis, causing the radiator cooling fan to stall creating tons of noise and insufficient cooling for throat. (Not part cooling, trihorn works perfect)

with that happening , when long time printing with high speed and high temp, sometimes the softened plastic goes up the throat and almost get into extruder causing severe clogs. Any tips?

Thanks for the stunning design BTW.

pkucmus, 2022-10-31:
Hi, thanks. What do you refer to when speaking of "extruded aluminum chassis"? The X gantry 2020? My first guess would be a problem with the fan itself. I'm currently running a Mosquito HF on my main VC3.1 with a default 4010 GDS fan and have no issues, neither with clogs or noise.

AlexTOOT, 2022-11-04:
>

yes, X gantry. forgot its name in English.

I tested several sunon 4010s, a sunon 4020 and a delta 4028. They all have the same issue but varies a little, the 4010 is easier to recovery from the stalling state by blowing into it from the front. I believe that breaks the vortex or some sort,  force it to re-stabilize.
The other two are a little bit harder to recover but they eventually do recover.  And when they get stable, they stay that way till shutdown.
 I'm not quite sure what is going on, so... maybe i'll do more test and let you know.

TekuSP, 2022-11-13:
If you have board supporting 12V, try using Noctua 4010. On paper should have higher airflow than most sunons, and mainly a lot quieter, so it can run at higher RPMs.

Thread 109 (2022-11-18):

BLTouch with Mosquito on same level

Seven4ninE, 2022-11-18:
I have a BLTouch + Mosquito with NoozleX and LGX Mini.The BLtouch is at the same Level as the Noozle.
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

olivbd, 2022-11-21:
Do you have a guenine BLTouch or a clone?

Mine is a 3D-Touch (clone) and I've same issue with BMO hotend... so I designed a 2mm raised version of the bracket.

You can find it here https://www.printables.com/model/322057-eva-3-modified-bl-touch-mount

Seven4ninE, 2022-11-21:
Hi,mine is an original and i made now a Version That is 1mm higher. Thank you for your reply .RegardsHarryVon meinem iPhone gesendetAm 21.11.2022 um 17:21 schrieb Olivier Béraud ***@***.***>:
Do you have a guenine BLTouch or a clone?
Mine is a 3D-Touch (clone) and I've same issue with BMO hotend... so I designed a 2mm raised version of the bracket.
You can find it here https://www.printables.com/model/322057-eva-3-modified-bl-touch-mount

—Reply to this email directly, view it on GitHub, or unsubscribe.You are receiving this because you authored the thread.Message ID: ***@***.***>

Thread 111 (2023-01-06):

duet tool bord

BenDiesel1, 2023-01-06:
i was wondering if any one had a way of mounting a duet tool bord to the eva hot end system? im building a ratrig 500.

olivbd, 2023-01-07:
What drive are you using? BMG, LGX, Orbiter... ?

BenDiesel1, 2023-01-07:
we have the ldo obiter 2.0
thanks

olivbd, 2023-01-07:
you can try this
https://www.printables.com/model/233448-duet-toolboard-1lc-mount-eva3-compatible

BenDiesel1, 2023-01-07:
oh lol that works thanks

Closed 2023-01-10.

Thread 113 (2023-02-04):

CR-touch

niefachowy, 2023-02-04:
is there any chance of using cr-touch instead of bl-touch?

C4rdsh4rk, 2023-03-14:
I would also appreciate a mount for the cr touch. My BLtouch broke because the default bltouch mount was too tight. I bought a crtouch now, but it can't be mounted the same way as the bltouch.

Thread 114 (2023-02-26):

Incorrect toothed belt profile at the slide tensioner

ZeyHex, 2023-02-26:
It's about this detail:
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

At the moment, the profile of the channel of the toothed belt is as follows:
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

However, a typical toothed belt profile is as follows:
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

Even in the model, this movable belt tensioner does not inspire confidence in its reliability, but in reality it is not uncommon for 1-2 belt teeth to pop out of the tensioner when the belt is tensioned. And sometimes, with sufficient jerks and accelerations, the belt can completely pull out of the tensioner.

For myself, I solved the problem by narrowing this place by 0.2 mm, and now the part behaves quite reliably, however, I think that the model in the project needs to be corrected in such a way that it ensures that the belt is securely held in any conditions.
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

ZeyHex, 2023-07-19:
This is an awesome solution! How did I not think of it myself .. Super!

I also switched to a 9mm strap on the print head and that also helped it stay on the slider.

ricki158, 2025-02-10:
Have you STL reviewed with this solution?

Thread 117 (2023-06-04):

Fan duct blows crookedly

ZeyHex, 2023-06-04:
Hello!
I did not have enough airflow in the configuration with 5015 and I installed server 4028. It turned out that already at half power the air blows beyond the nozzle and forward, and not down on the part. As it shown on the picture.
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
I think we need to extend the air channels a little closer to the nozzle to straighten the flow more, and make them smaller at the exit so that the flow gets where it needs to be with more speed and pressure.
For example, as shown in the pictures below.
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
I also understand that some people still use outdated oversized heaters and this option will not work for them. In this case, the flow can be straightened by bending the channel more, as shown in the figure.
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

In the current implementation, powerful airflow through such channels is simply impossible, they blow absolutely in the wrong direction when the fan accelerates to large flows.

dstrelnikov, 2023-06-09:
I just replaced 2x5015 with a powerful 4028 fan and can confirm the issue. Even at 50% the airflow shifts to the front from the nozzle.

@ZeyHex, please let me know if you get some improvement with an adjusted duct.

MudiStar, 2024-04-20:
I don't know if this is still a topic for you, but try the tri horn
The airflow seems to fit
https://main.eva-3d.page/heat_insert/bottoms/tri_horn/#description

ZeyHex, 2024-04-20:
> I don't know if this is still a topic for you, but try the tri horn The airflow seems to fit https://main.eva-3d.page/heat_insert/bottoms/tri_horn/#description

What's the difference? It also blows crookedly.
Apparently, EVA is dead, now RatRig make their own head and airflow.

Thread 118 (2023-10-11):

Building a new V-Cast, what are my options?

dolence, 2023-10-11:
First, I'd like to express gratitude for your work. I know it's not ane asy work and very time consuming.

I'm building a cartesean V-Cast 1.5. Many people ask why I choose this instead an more active CoreXY project and my reason to this is that I don't have any FDM printer yet and needed to print tons of parts for my 500x500 CoreXY. V-Cast is cheap, I can find most of the parts locally (many of them I already had laying around, like MGN12) and have only a few parts that need printing to be assembled. Also, having an additional printer for smaller parts or parallel work is nice too.

Now, let's talk about the printhead... I've tried to get some help on Discord group, but since everyone is building CoreXY these days, V-Cast builds aren't getting much attention.

I'm planning to use an Orbiter V2 and a Phaetus Rapido V2. I'm not sure if I would have any benefit from an UHF version.
I read on the EVA documentation that V-Cast isn't being supported anymore. Please, would you kindly give me some advices on how to proceed? What parts do I need to use? What need to be adjusted? I'm really lost... Any help would be greatly appreciated!

oliof, 2023-10-11:
there is a community remix of EVA 3 for V Cast https://www.printables.com/model/210744-eva3-mgn-12-vcast-idex-backs

Thread 119 (2024-04-25):

Bigtreetech Eddy

Alterminifahrer1986, 2024-04-25:
Hi guys,
i want to build up a Mercury One.1 and just Look for the toolhead. I would like to have a contactless sensor like the Bigtreetech Eddy - Easy Installation with an existing Manta M8P v2 board.
Is it planed to integrate it or still available?

Cheers

Closed 2024-05-04.

Thread 120 (2025-06-28):

m3s nut dimensions

Gotos, 2025-06-28:
Hi!

Thanks for this awesome project!

I'm currently building an EVA for a Cartesian printer (in case that's important: I'm building the heat insert version).
For the belt grabber, I should use an M3s nut according to the BOM and also the assembly in onShape. However, I noticed an issue - the model of the M3s nut used is 5.4 by 5.4 mm (and therefore the nut opening in the belt grabber is that size, too). But from what I can tell, DIN 562 specifies square M3 nuts to have a width and height of 5.5 mm. (I do not have access to the actual DIN 562 specs at this time, but all shops I found so far that sell nuts that they claim are up to spec list the size as 5.5 by 5.5 mm, so I'm moderately confident that this is the correct size.)

Is this a deliberate decision (e.g. for a press fit) or a mistake?
