EVA-3D/eva-main/(commit log)

2020-11-15 doc changes, use eva-docs-builder
    [e3d.csv, mosquito.csv]
2020-11-17 prep for the submodule approach, add bowden submodule
    [e3d.csv, mosquito.csv]
2020-11-18 add bmg, add titan, add endstops
    [e3d.csv, mosquito.csv]
2020-11-29 add aero, bump everything to new endstop sliders, bottom zip tie slots
2020-12-30 add stls superset
    [4040_fan_face.stl, LJ8_probe_mount.stl, SSX_tensioner_thing_2426505.stl, aero_face.stl, aero_support.stl, back_cartesian.stl, back_corexy.stl, back_idex_x1.stl]
2021-01-05 bump probes, fix typos, add print orientation view
2021-01-26 2.2.0 release
    [4040_fan_face.stl, LJ12_probe_mount.stl, LJ18_probe_mount.stl, LJ8_probe_mount.stl, aero_front_probe.stl, bl_touch_mount.stl, bl_touch_mount_alt.stl, bmg-m_pfte_adapter.stl]
2021-03-06 [#24] Fix MGN15 bottom middle hole misalignment
    [bottom_mgn12_short_duct.stl, bottom_mgn15.stl, bottom_mgn15_hemera.stl, mosquito_face.stl, top_endstop_openbuilds.stl, top_endstop_openbuilds_mgn15.stl, top_orbiter_mgn12.stl, top_orbiter_mgn15.stl]
2021-03-06 [#22] Add volcano bl-touch probes
2021-03-06 Update mkdocs material, add automatic build
    [superbom.csv]
2021-03-06 recreate stls directory
    [bl_touch_mount_alt_volcano.stl, bl_touch_mount_volcano.stl]
2021-03-20 fix bottom mgn12 name collision
    [bottom_mgn12_aero.stl, bottom_mgn12_hemera.stl, bottom_mgn12_short_duct.stl, top_orbiter_mgn12_cr_10.stl, top_orbiter_mgn15_cr_10.stl]
2021-03-26 Add angled endstop to superbom
    [superbom.csv]
2021-03-26 Add custom Horns Ducts
2021-03-29 Fix typo in MGN carriages, closes #37.
2021-04-25 Changes for new documentation schema, add lgx, add copperhead
    [Copperhead.csv, Dragon.csv, LJ12_probe_mount.stl, LJ18_probe_mount.stl, LJ8_probe_mount.stl, Mosquito.csv, SSX_tensioner_thing_2426505.stl, V6.csv]
2021-04-26 split hotends
    [Copperhead.csv, Dragon.csv, Mosquito.csv, V6.csv, copperhead_face.stl, copperhead_support_a.stl, copperhead_support_b.stl, dragon_face.stl]
2021-04-26 move global stls to root directory
    [LJ12_probe_mount.stl, LJ18_probe_mount.stl, LJ8_probe_mount.stl, SSX_tensioner_thing_2426505.stl, aero_face.stl, aero_front_probe.stl, aero_support.stl, back_cartesian.stl]
2021-04-26 Fix stl gathering, add cad urls
    [Dragon.csv, Mosquito.csv]
2021-05-06 Add CAD links, add superbom generator
2021-05-09 fix the wrong CAD link on addon / cartesian fixes #45
2021-06-04 move submodules to parent
    [Aero.MGN12.csv, Aero.MGN15.csv, BMG.MGN12.csv, BMG.MGN15.csv, BOM_Endstops.angled.MGN12.csv, BOM_Endstops.angled.MGN15.csv, BOM_Endstops.openbuilds.MGN12.csv, BOM_Endstops.openbuilds.MGN15.csv]
2021-06-04 add sqlite bom handling
2021-12-22 add orbiter 2.0, add low wide cooling
    [back_corexy.stl, bottom_mgn12_short_duct.stl, cable_holder.stl, face_belt_grabber.stl, tension_slider_9mm_belt_M5.stl, top_orbiter_2_0_mgn12.stl, top_orbiter_mgn12.stl, universal_face.stl]
2021-12-27 fix version, fix missing bmg-m adapter, add missing shrouds
    [back_corexy.stl, bmg-m_pfte_adapter.stl, bmgm_pfte_adapter.stl, cable_holder.stl, queen_shroud.stl, queen_shroud_adxl.stl, queen_shroud_led.stl, shroud.stl]
2022-01-02 add UHF duct, fix incorrect duct export in drives
    [back_corexy.stl, cable_holder.stl, top_orbiter_1_5_mgn12.stl, top_orbiter_2_0_mgn12.stl, universal_face.stl]
2022-02-07 fix BMO model and put the right PTFE length for it
    [back_corexy.stl, cable_holder.stl, top_mgn12.stl]
2022-02-19 general cleanup, remove old stls, bump eva docs builder
    [Duct v2.1 Angled 13.2deg.stl, Duct v21 Angled 132deg.stl, TriHorn Duct Safe.stl, back_corexy.stl, back_idex_x1.stl, back_idex_x2.stl, bottom_mgn12_short_duct.stl, cable_holder.stl]
2022-05-08 major 3.0 release
    [40mm_fan_inlet.stl, 40mm_fan_inlet_fi.stl, Duct v2.1 Angled 13.2deg.stl, LJ12_probe_mount.stl, LJ18_probe_mount.stl, LJ8_probe_mount.stl, SSX_tensioner_thing_2426505.stl, TriHorn Duct Safe.stl]
2022-05-09 fix typos and broken links
    [40mm_fan_inlet_fi.stl, 5015_inlet.stl, 5015_inlet_fi.stl, back_cartesian.stl, back_cartesian_fi.stl, back_core_xy.stl, back_core_xy_fi.stl, bl_touch_mount.stl]
2022-05-10 fix broken STL export, add contribution information
    [40mm_fan_inlet.stl, 40mm_fan_inlet_fi.stl, 5015_inlet.stl, 5015_inlet_fi.stl, back_cartesian.stl, back_cartesian_fi.stl, back_core_xy.stl, back_core_xy_fi.stl]
2022-06-12 EVA 3.0 main
    [40mm_fan_inlet_fi.stl, 5015_inlet.stl, 5015_inlet_fi.stl, bl_touch_mount.stl, cable_guide_mount.stl, cable_guide_mount_barrel.stl, cable_guide_mount_fi.stl, dual_5015_inlet.stl]
2022-06-25 fix the default layer duct (bottom)
    [40mm_fan_inlet_fi.stl, hotend_bmo.stl, hotend_mosquito.stl, hotend_nova.stl, hotend_nova_fi.stl, hotend_revo_voron.stl, hotend_revo_voron_fi.stl, shroud_chonky_fan_cover.stl]
2022-07-09 improve bl-touch mount, add bl-touch mount for volcano options
    [bl_touch_mount.stl, bl_touch_mount_volcano.stl]
